AlksGit/OOTY-/BACKLOG.md

# Backlog

## TODO
- [ ] TASK-009 | Phase 6 — Fabrication
  > Gerbers + drill + CPL + BOM fab zippés dans out/fab/<projet>_<rev>.zip, checklist finale dans NOTES.md.
  > ⏸ Checkpoint final.
  > Blocked by: TASK-008 (DRC propre)

## IN PROGRESS
- [ ] TASK-008 | Phase 5 — Routage
  > Routage complet, zones remplies, DRC --schematic-parity : 0 erreur, 0 net non connecté. SVG par couche + rendu 3D.
  > ⏸ Checkpoint : routage relu.
  > Paires Kelvin et nœud µA des INA190 : F.Cu d'abord, B.Cu accepté à défaut (décision du 2026-10-20).
  > Blocked by: — (TASK-012 mergée)

## ON HOLD

## DONE
- [x] TASK-012 | Placement — intégration des nouveaux blocs + finition de la sérigraphie
  > Merged in: devape (2026-10-20) — revue + contre-revue « prêt pour le routage », DRC 0 / parité 0, découplage 59/59 ; face arrière non assemblée acceptée
- [x] TASK-011 | Schéma — mesure double calibre ×2 + retours de tension des rails fixes
  > Merged in: devape (2026-10-20) — ERC 0, netlist 196 nets et BOM 242 pièces sans écart
- [x] TASK-010 | Spec + composants — mesure double calibre (3V3_SW, 5V_SW) et retours de tension des rails fixes
  > Merged in: devape (2026-10-20) — validée par l'utilisateur après revue indépendante
- [x] TASK-007 | Phase 4 — Placement
  > Merged in: devape (2026-10-20) — refait après la revue des checkpoints, puis repris par TASK-012
- [x] TASK-006 | Phase 3 — Setup PCB
  > Merged in: devape (2026-10-20) — règles et classes corrigées après revue
- [x] TASK-005 | Phase 2 — Schéma
  > Merged in: devape (2026-10-20) — corrigé après revue (LQFP-80, boutons, ESD par header)
- [x] TASK-004 | Phase 1 — BOM préliminaire
  > Merged in: devape (2026-10-19) — BOM validée au checkpoint (recommandations retenues), choix du fabricant reporté en Phase 6
- [x] TASK-003 | Phase 0 — Spécification
  > Merged in: devape (2026-10-19) — spec validée au checkpoint
- [x] TASK-002 | Setup environnement + arborescence
  > Merged in: devape (2026-10-19)
- [x] TASK-001 | Remplir §1 de CLAUDE.md + créer la branche devape
  > Merged in: devape (2026-10-19)

## CANCELLED
