AlksGit/OOTY-/out/renders/pcb_phase3_iso.png

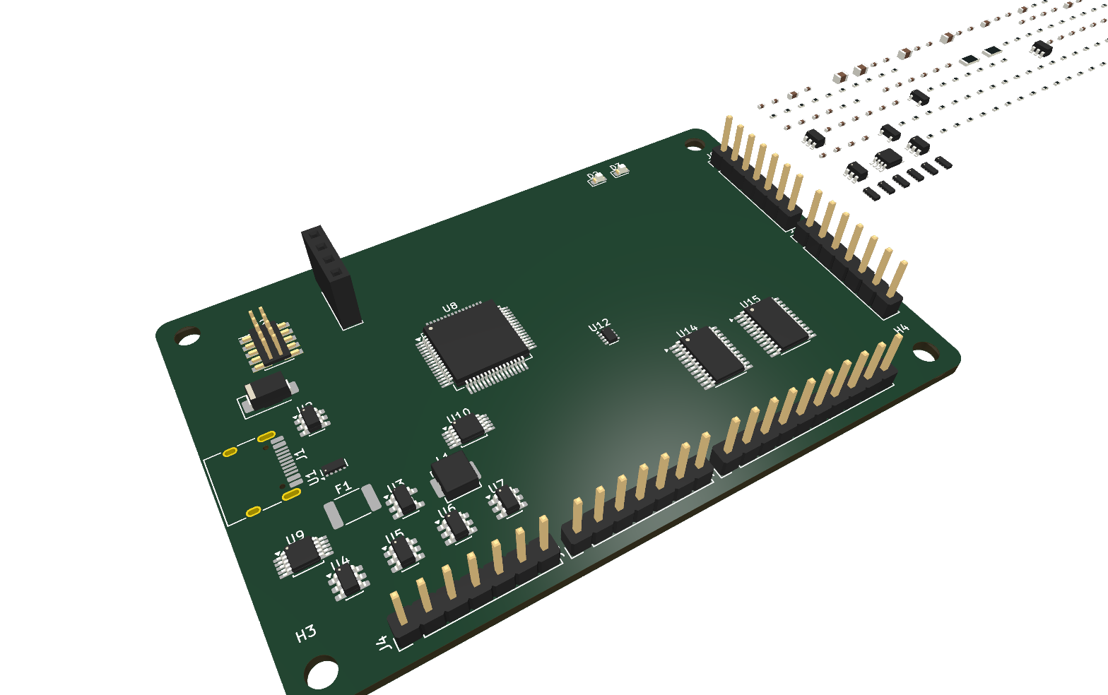
out/renders/pcb_phase3_iso.png
