AlksGit/OOTY-/out/renders/pcb_phase3_top.png

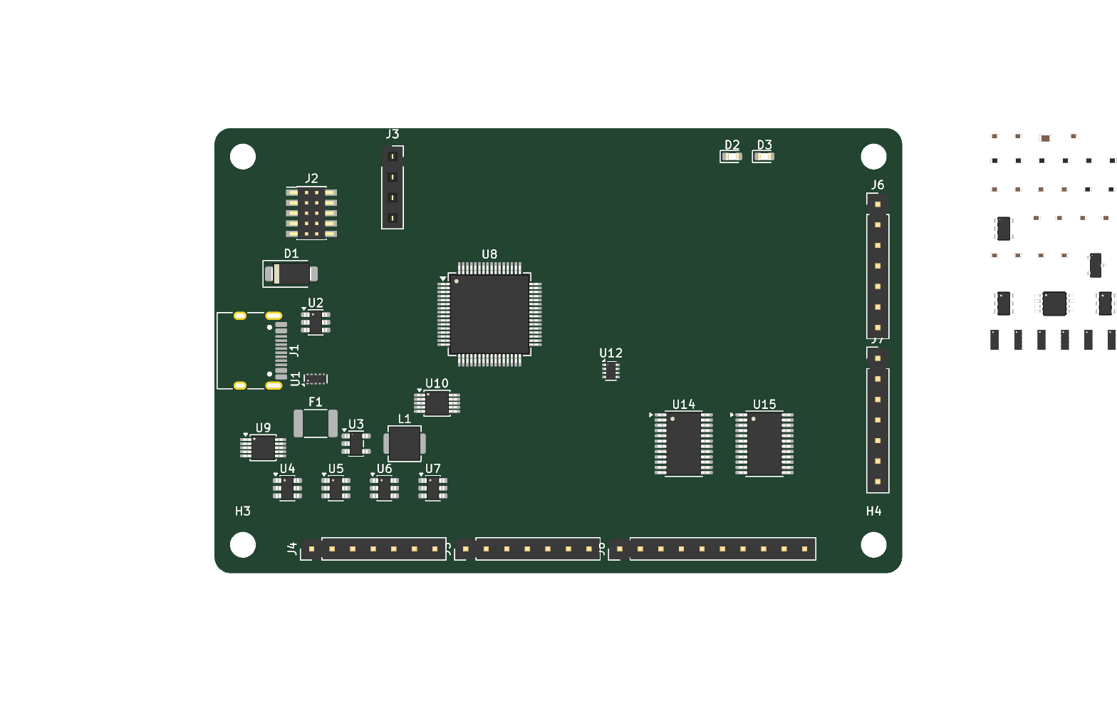
out/renders/pcb_phase3_top.png
