AlksGit/OOTY-/out/renders/pcb_placement_bottom.png

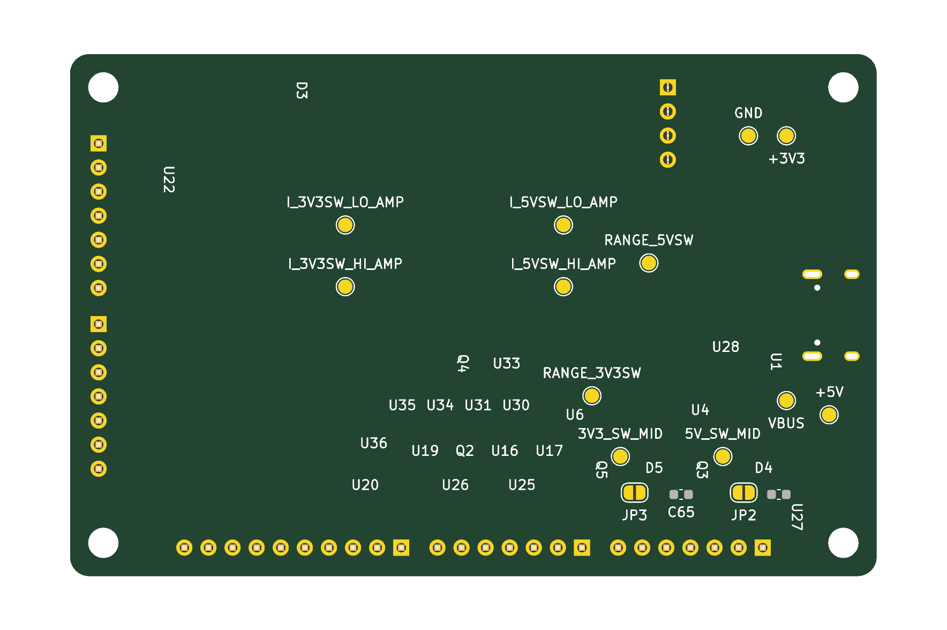
out/renders/pcb_placement_bottom.png
