AlksGit/OOTY-/out/renders/pcb_placement_iso.png

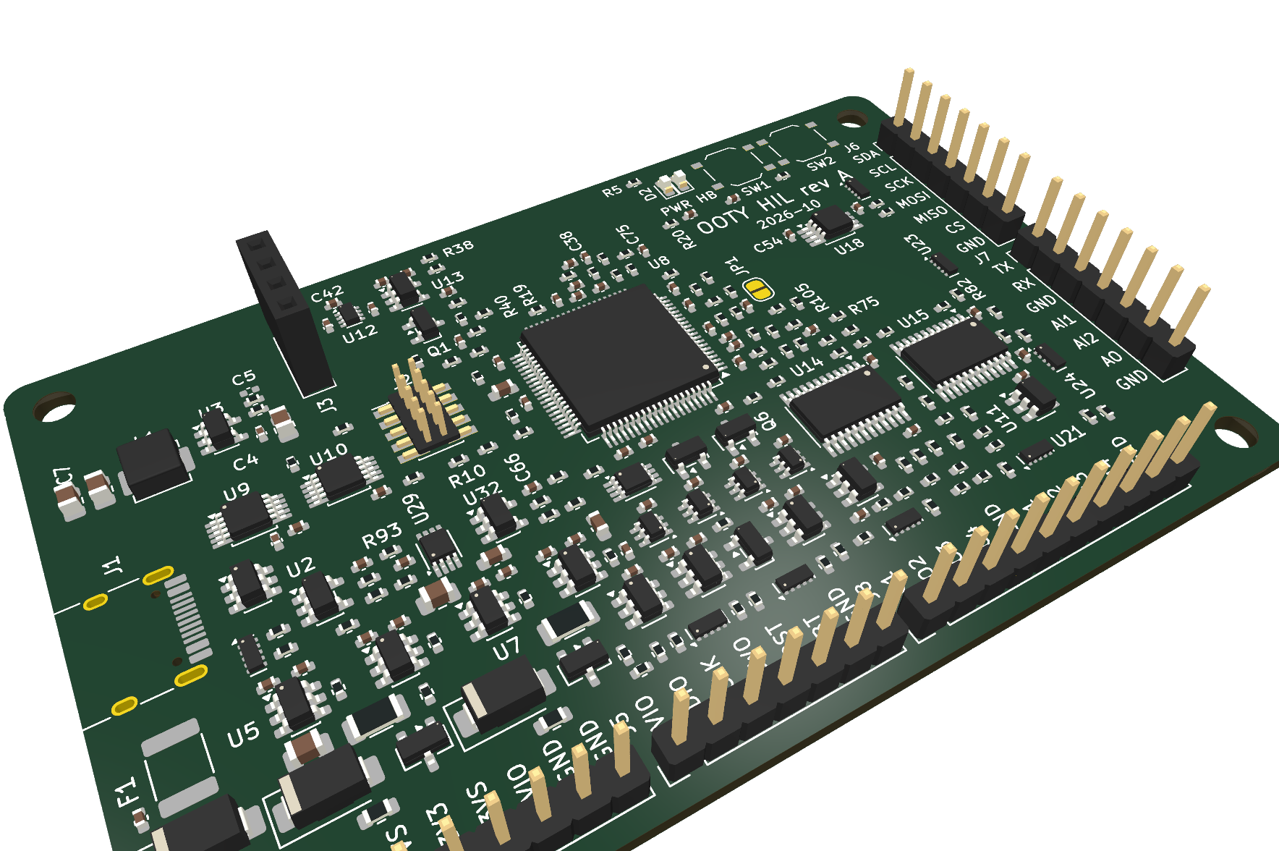
out/renders/pcb_placement_iso.png
