AlksGit/OOTY-/out/renders/pcb_placement_ratsnest.png

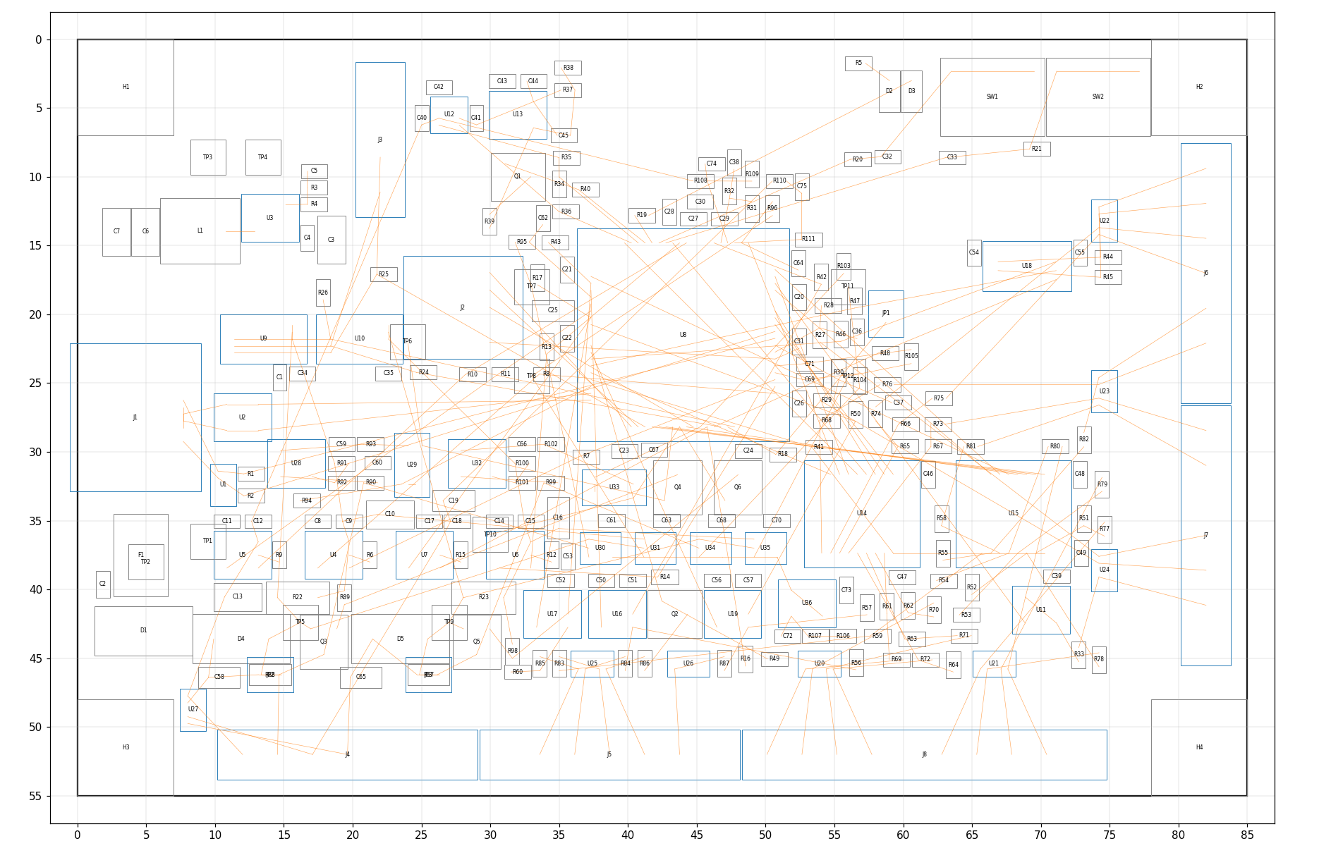
out/renders/pcb_placement_ratsnest.png
