AlksGit/OOTY-/out/renders/pcb_placement_top.png

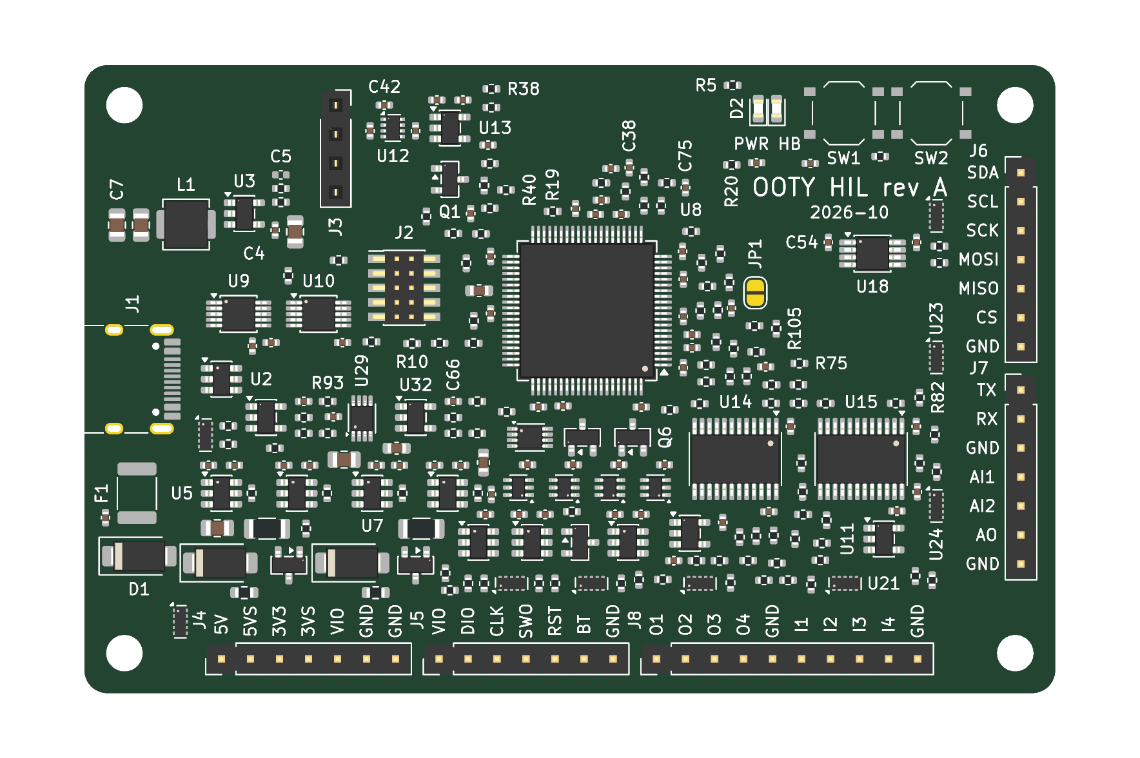
out/renders/pcb_placement_top.png
