AlksGit/OOTY-/out/renders/schematic_p1.png

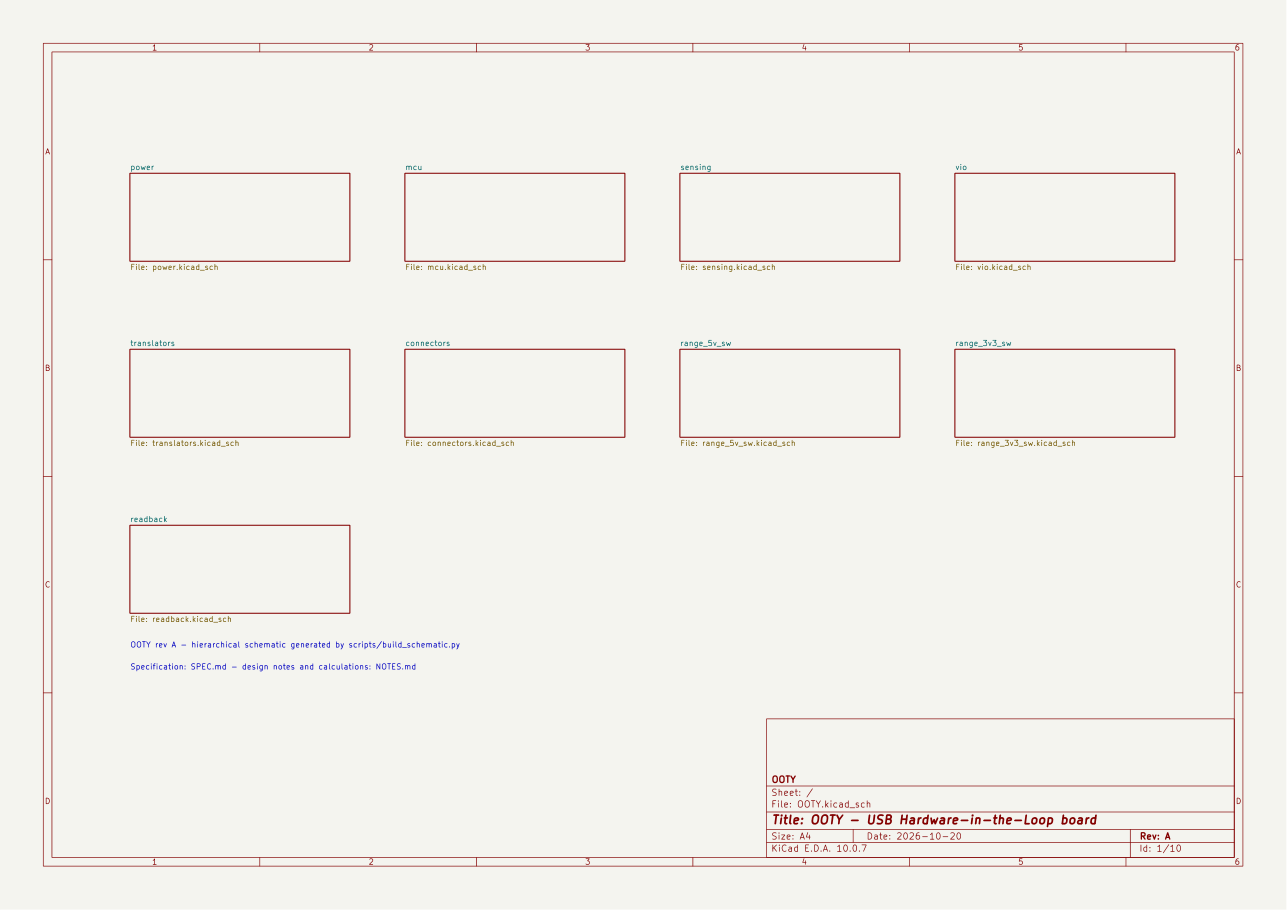
out/renders/schematic_p1.png
