AlksGit/OOTY-/out/renders/schematic_p2.png

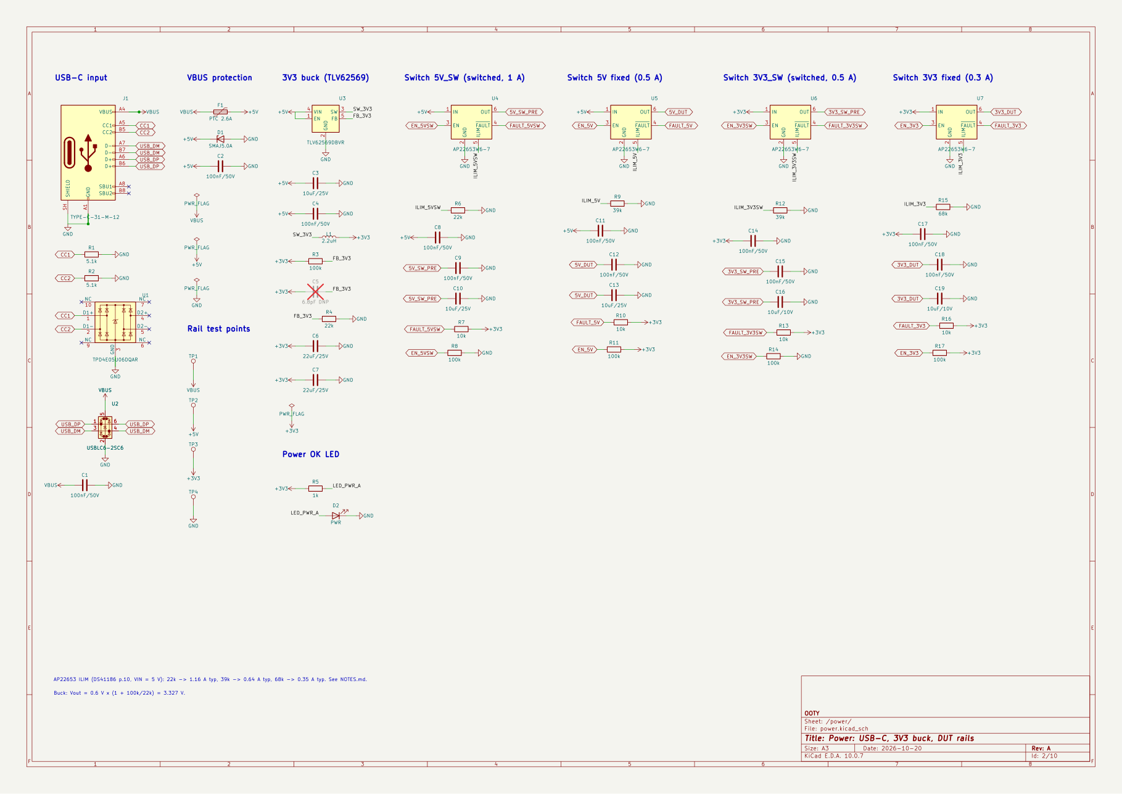
out/renders/schematic_p2.png
