AlksGit/OOTY-/out/renders/schematic_p3.png

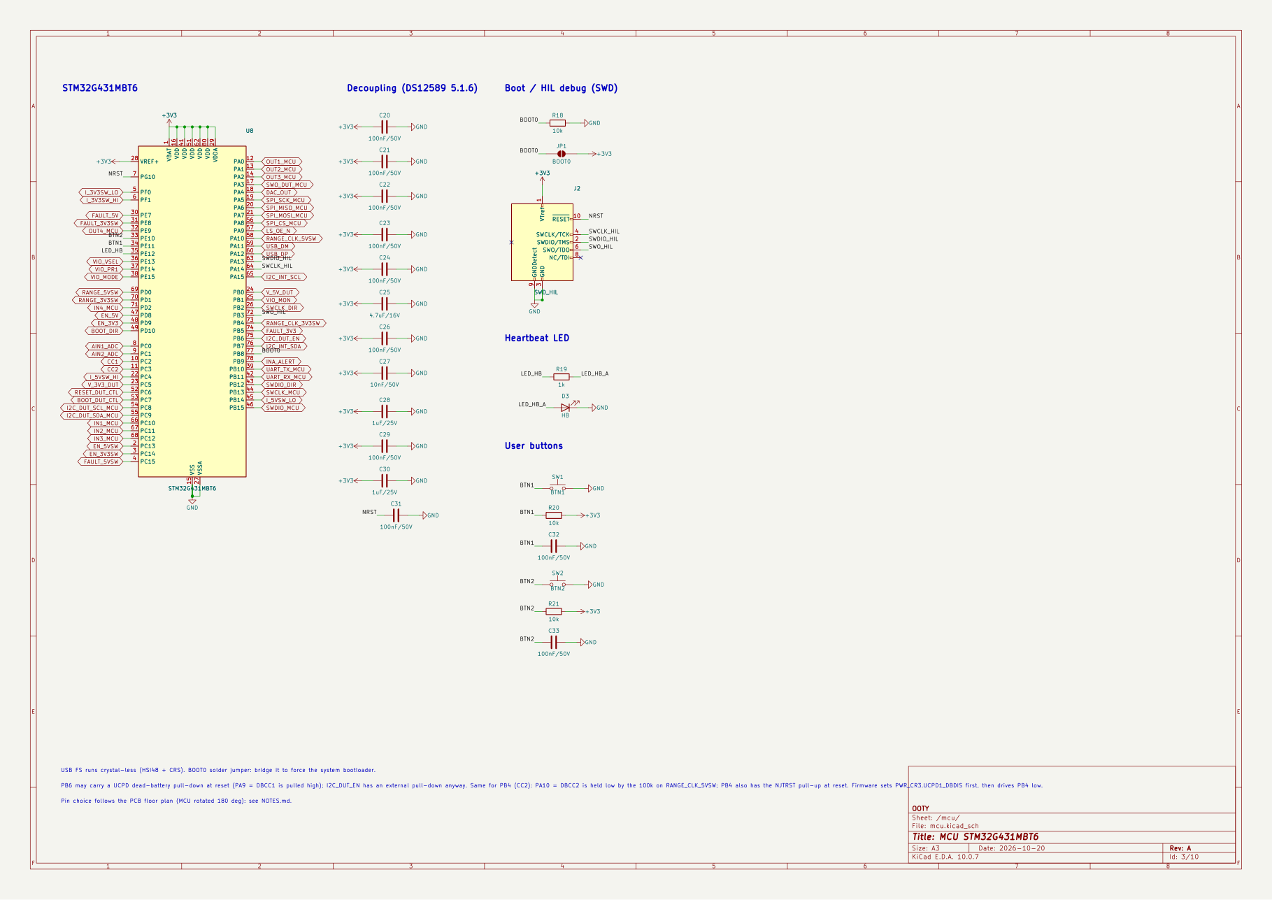
out/renders/schematic_p3.png
