AlksGit/OOTY-/out/renders/schematic_p4.png

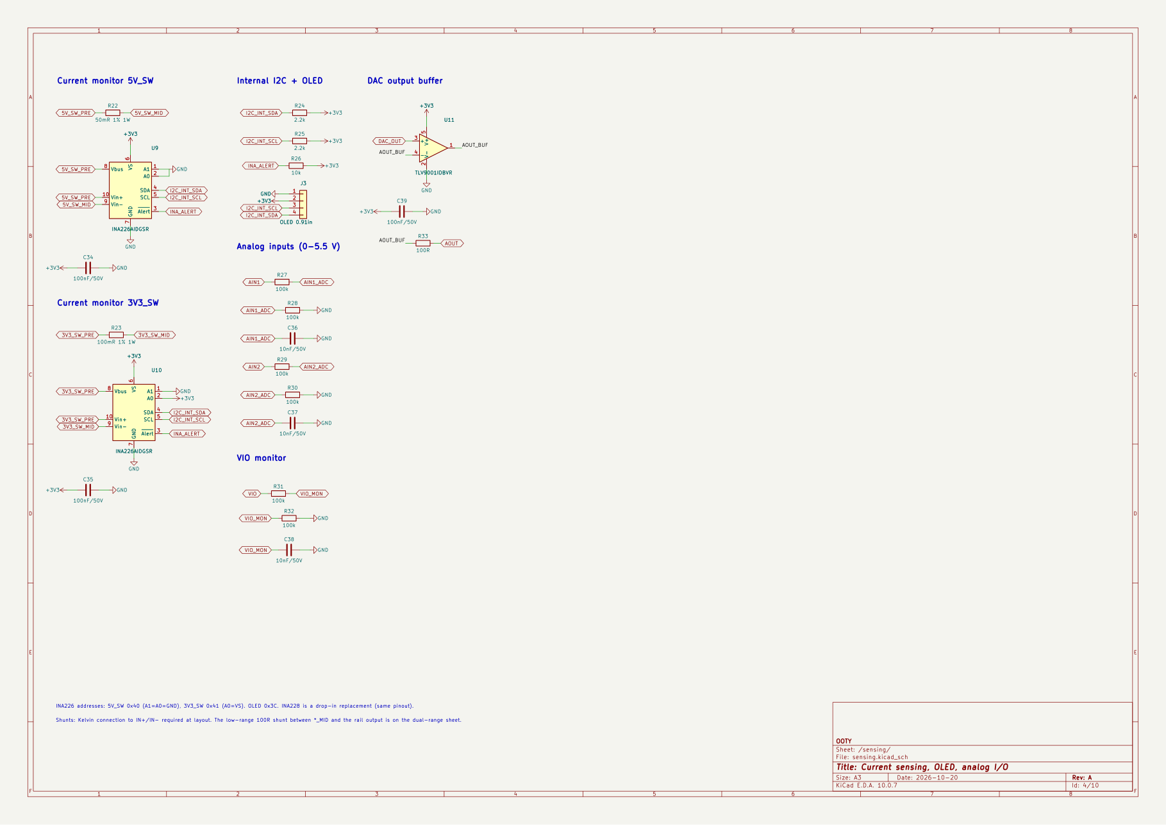
out/renders/schematic_p4.png
