AlksGit/OOTY-/out/renders/schematic_p5.png

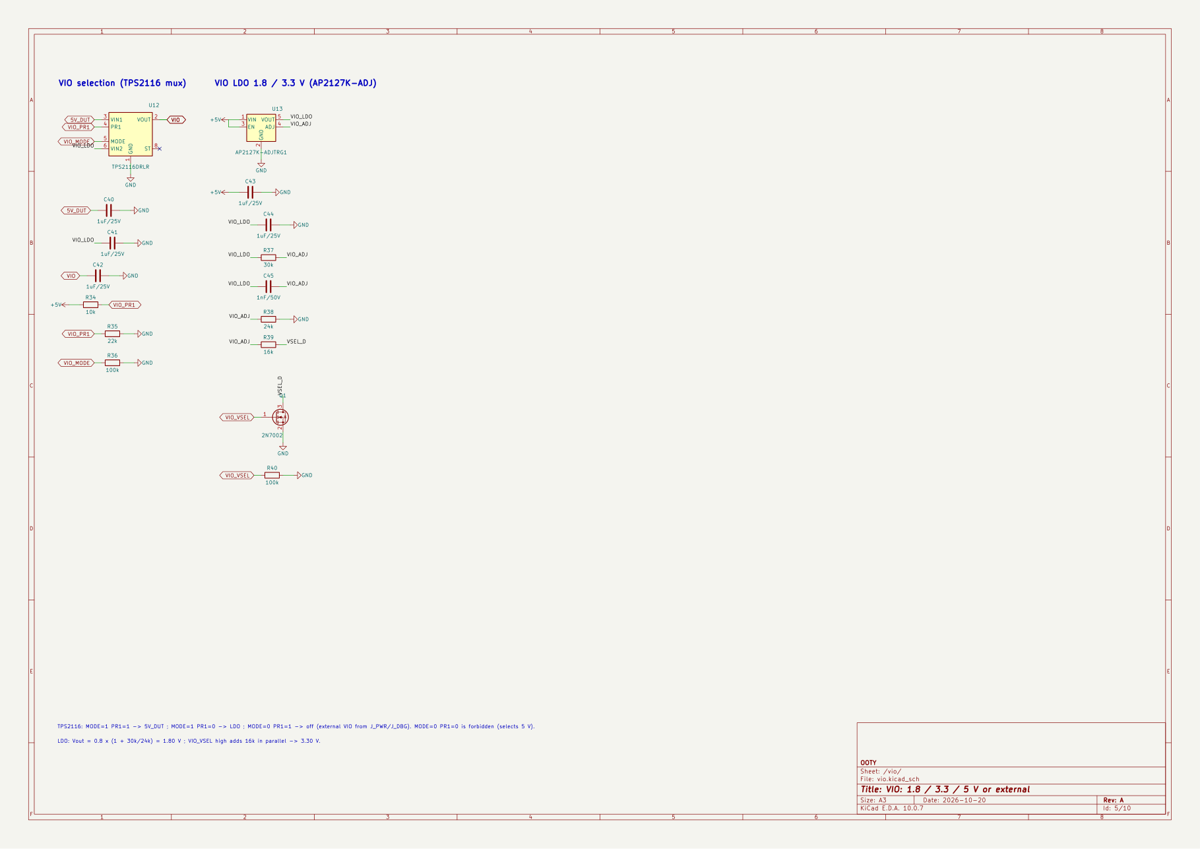
out/renders/schematic_p5.png
