AlksGit/OOTY-/out/renders/schematic_p6.png

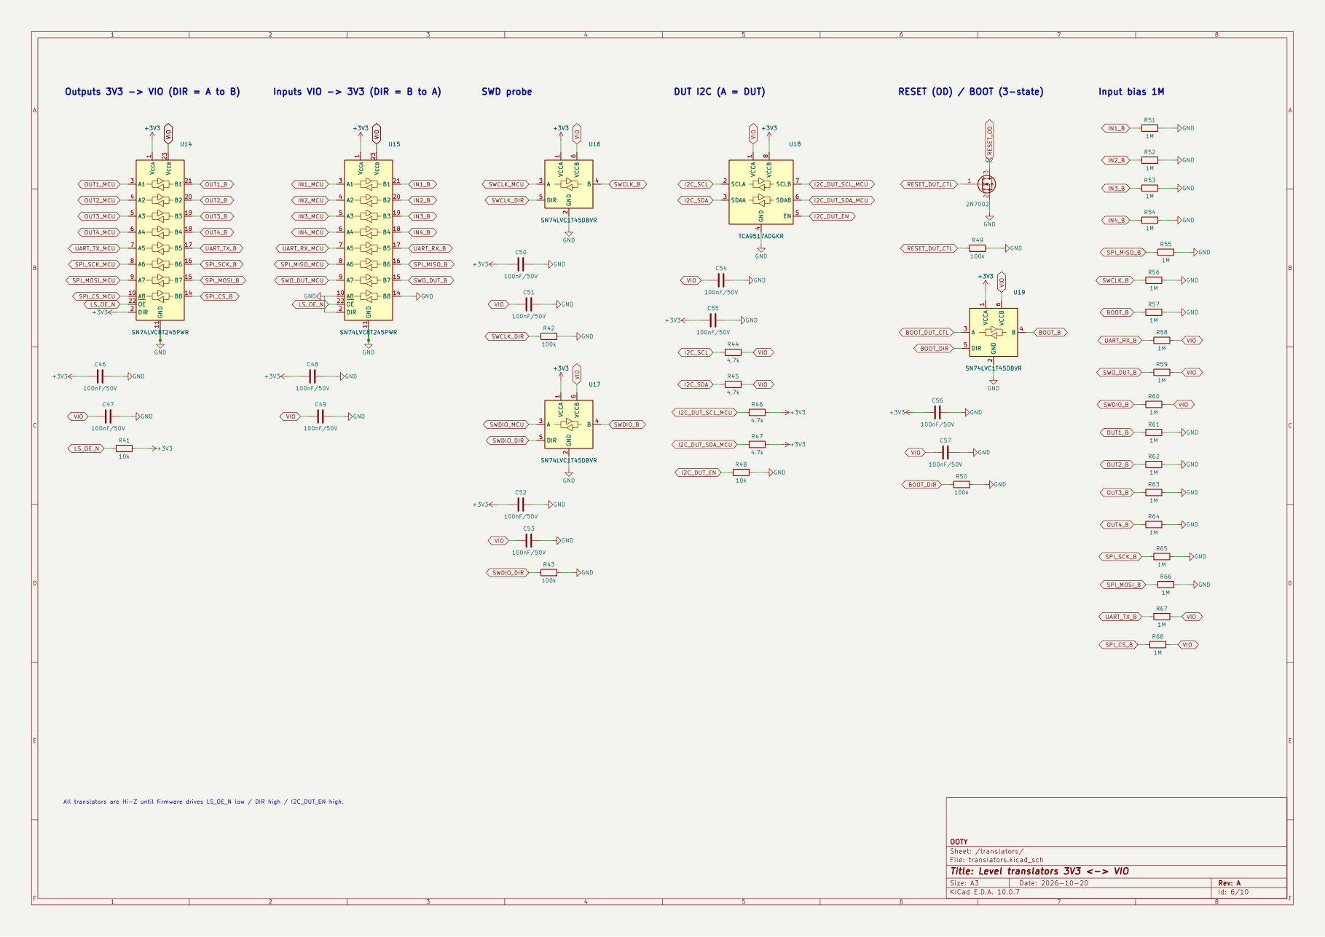
out/renders/schematic_p6.png
