AlksGit/OOTY-/out/renders/schematic_p7.png

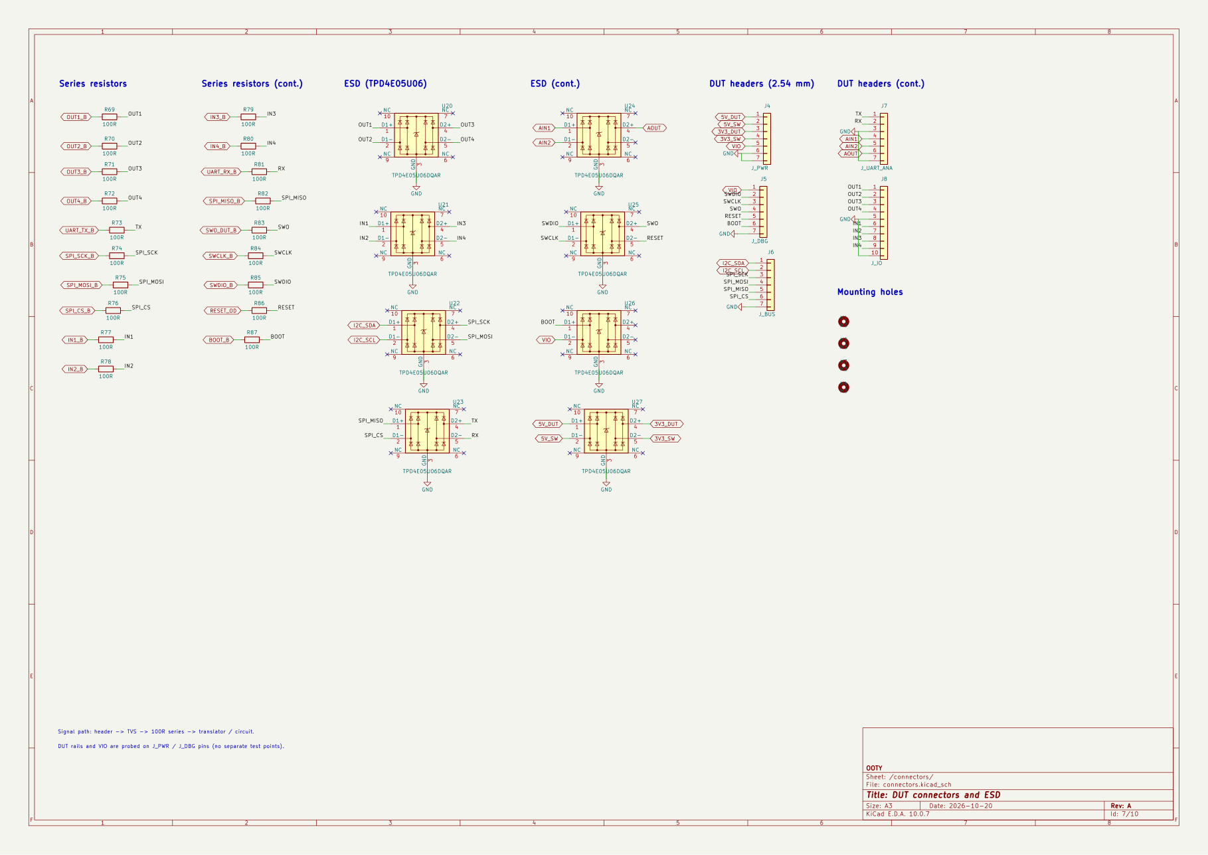
out/renders/schematic_p7.png
