AlksGit/OOTY-/out/renders/schematic_p8.png

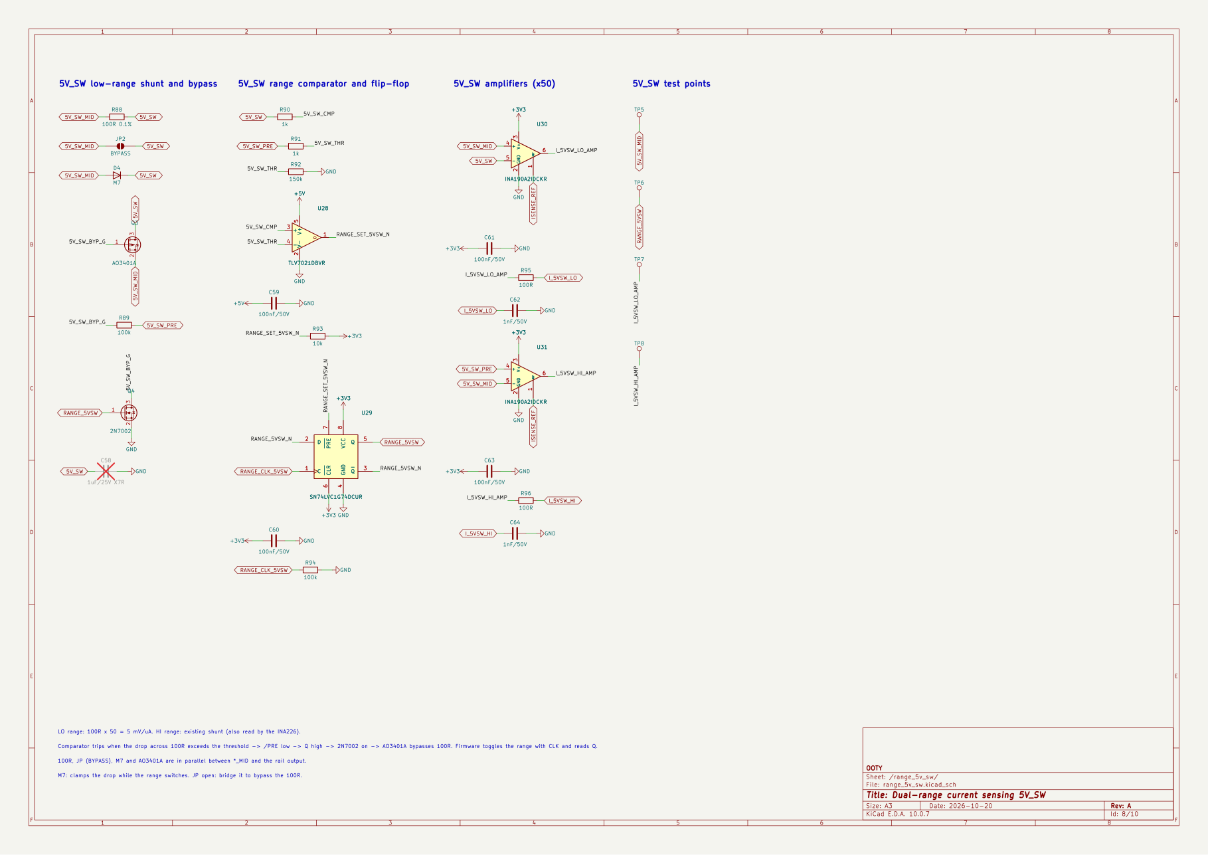
out/renders/schematic_p8.png
