AlksGit/OOTY-/out/renders/schematic_p9.png

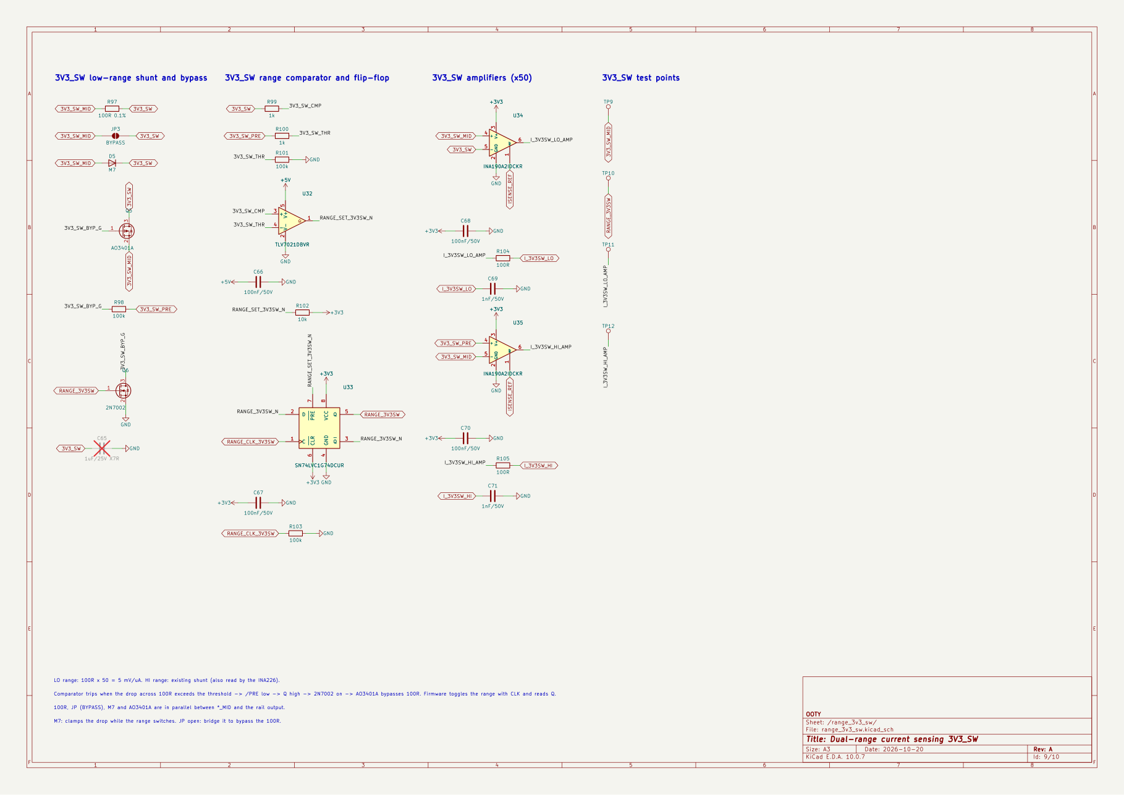
out/renders/schematic_p9.png
