AlksGit/OOTY-/out/renders/schematic_p10.png

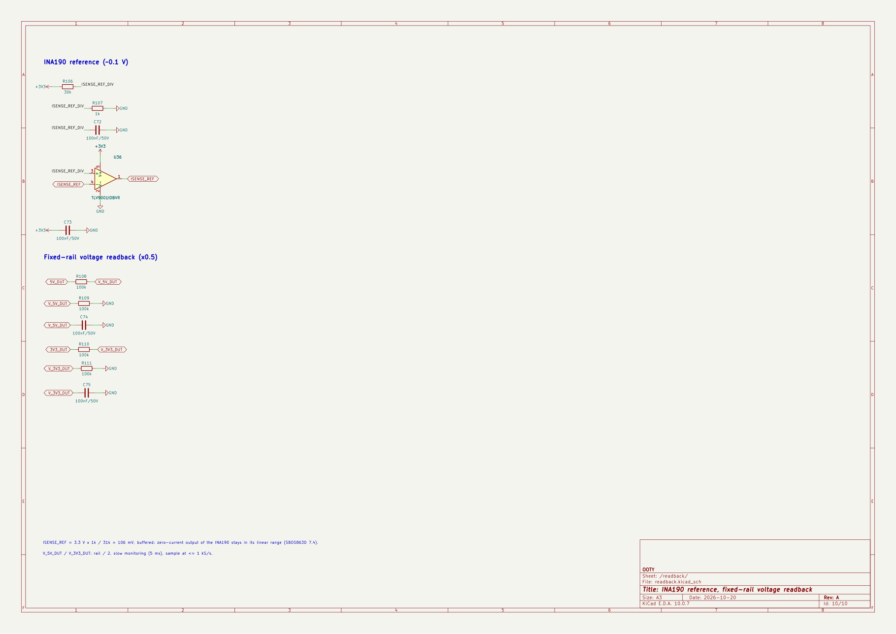
out/renders/schematic_p10.png
