AlksGit/OOTY-/out/OOTY_schematic.pdf

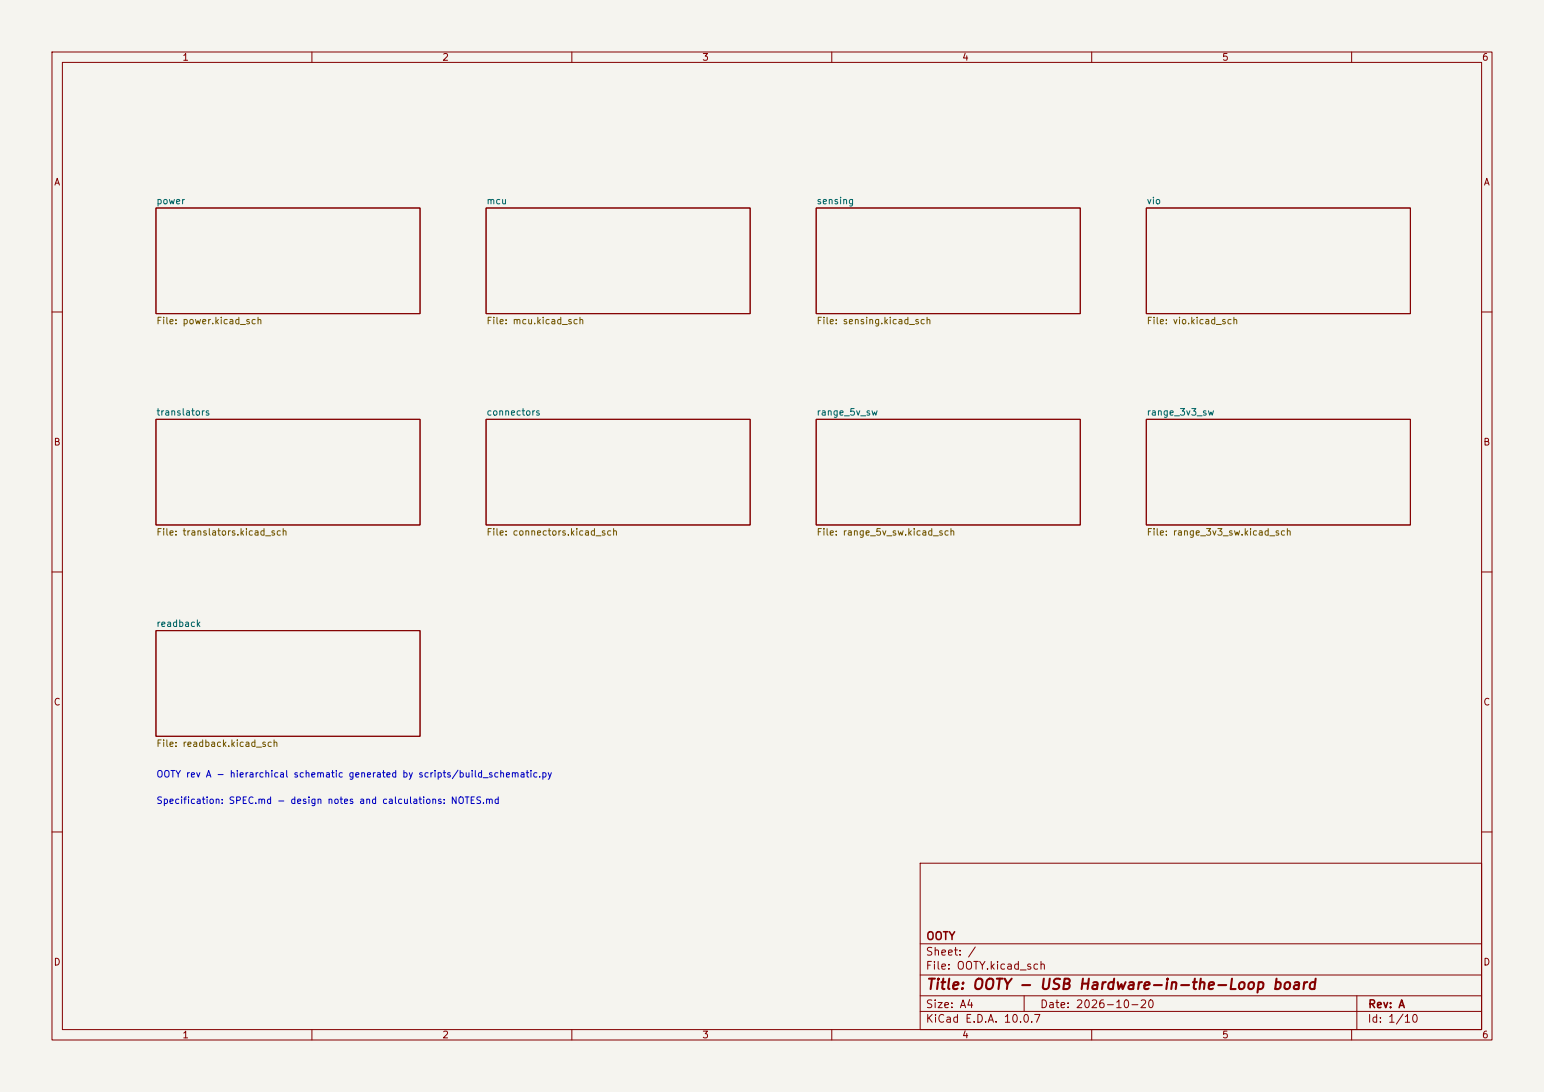
[picture p17: page 1]

File: range_5v_sw.kicad_sch OOTY rev A - hierarchical schematic generated by scripts/build_schematic.py

Specification: SPEC.md - design notes and calculations: NOTES.md

OOTY
Sheet: /
File: OOTY.kicad_sch
Title: OOTY - USB Hardware-in-the-Loop board

Size: A4 | Rev: A
KiCad E.D.A. 10.0.7 | Id: 1/10

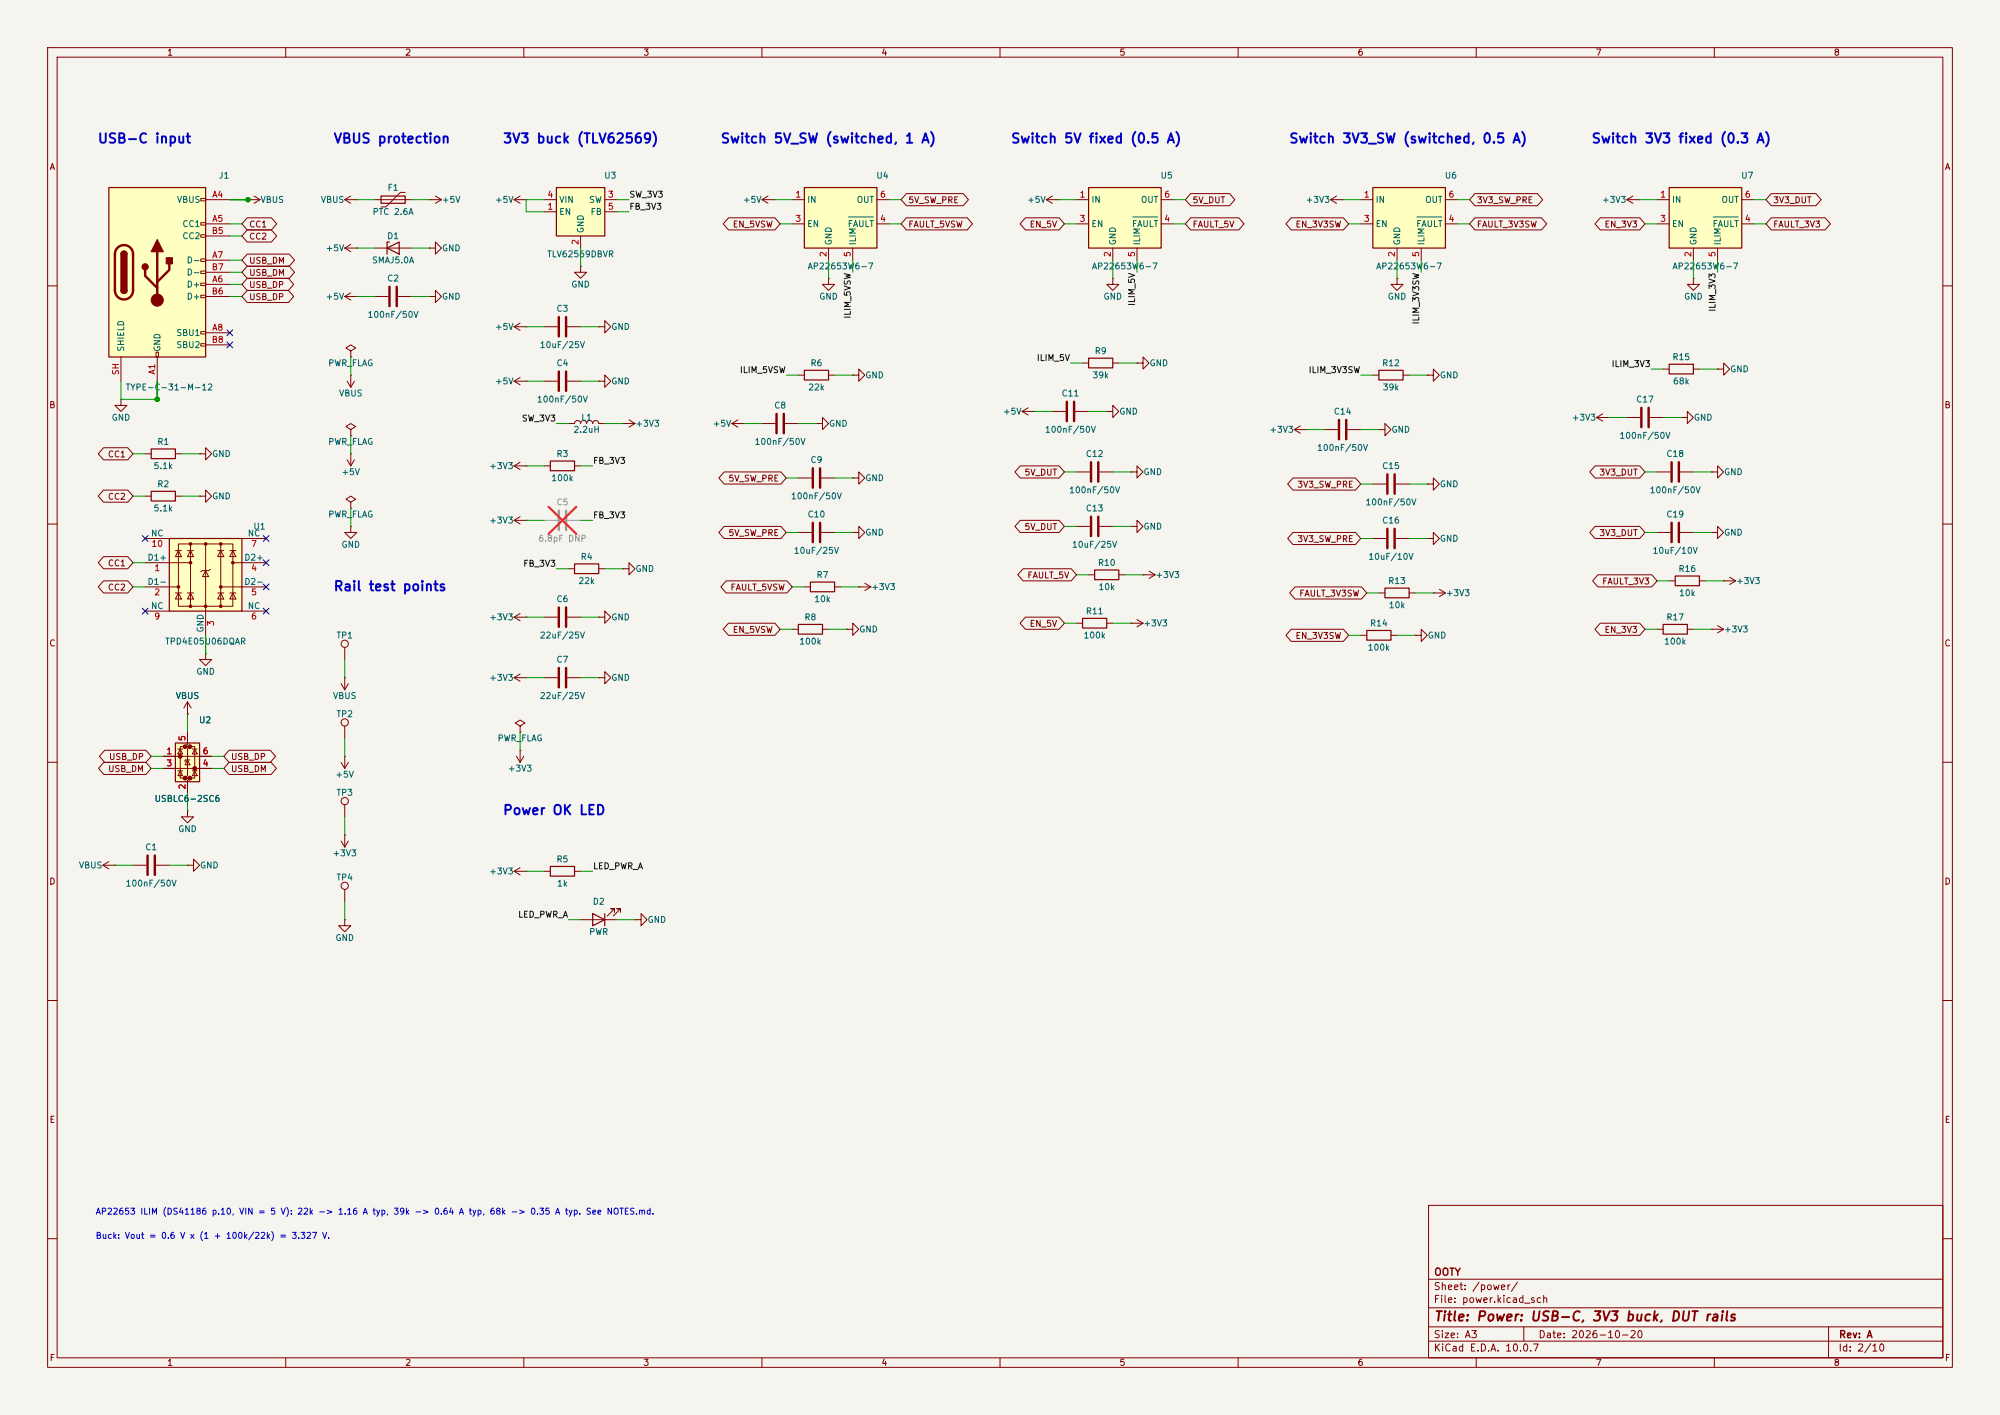
[picture p18: page 2]

Buck: Vout = 0.6 V x (1 + 100k/22k) = 3.327 V. AP22653 ILIM (DS41186 p.10, VIN = 5 V): 22k -> 1.16 A typ, 39k -> 0.64 A typ, 68k -> 0.35 A typ. See NOTES.md.

Sheet: /power/
File: power.kicad_sch
Title: Power: USB-C, 3V3 buck, DUT rails

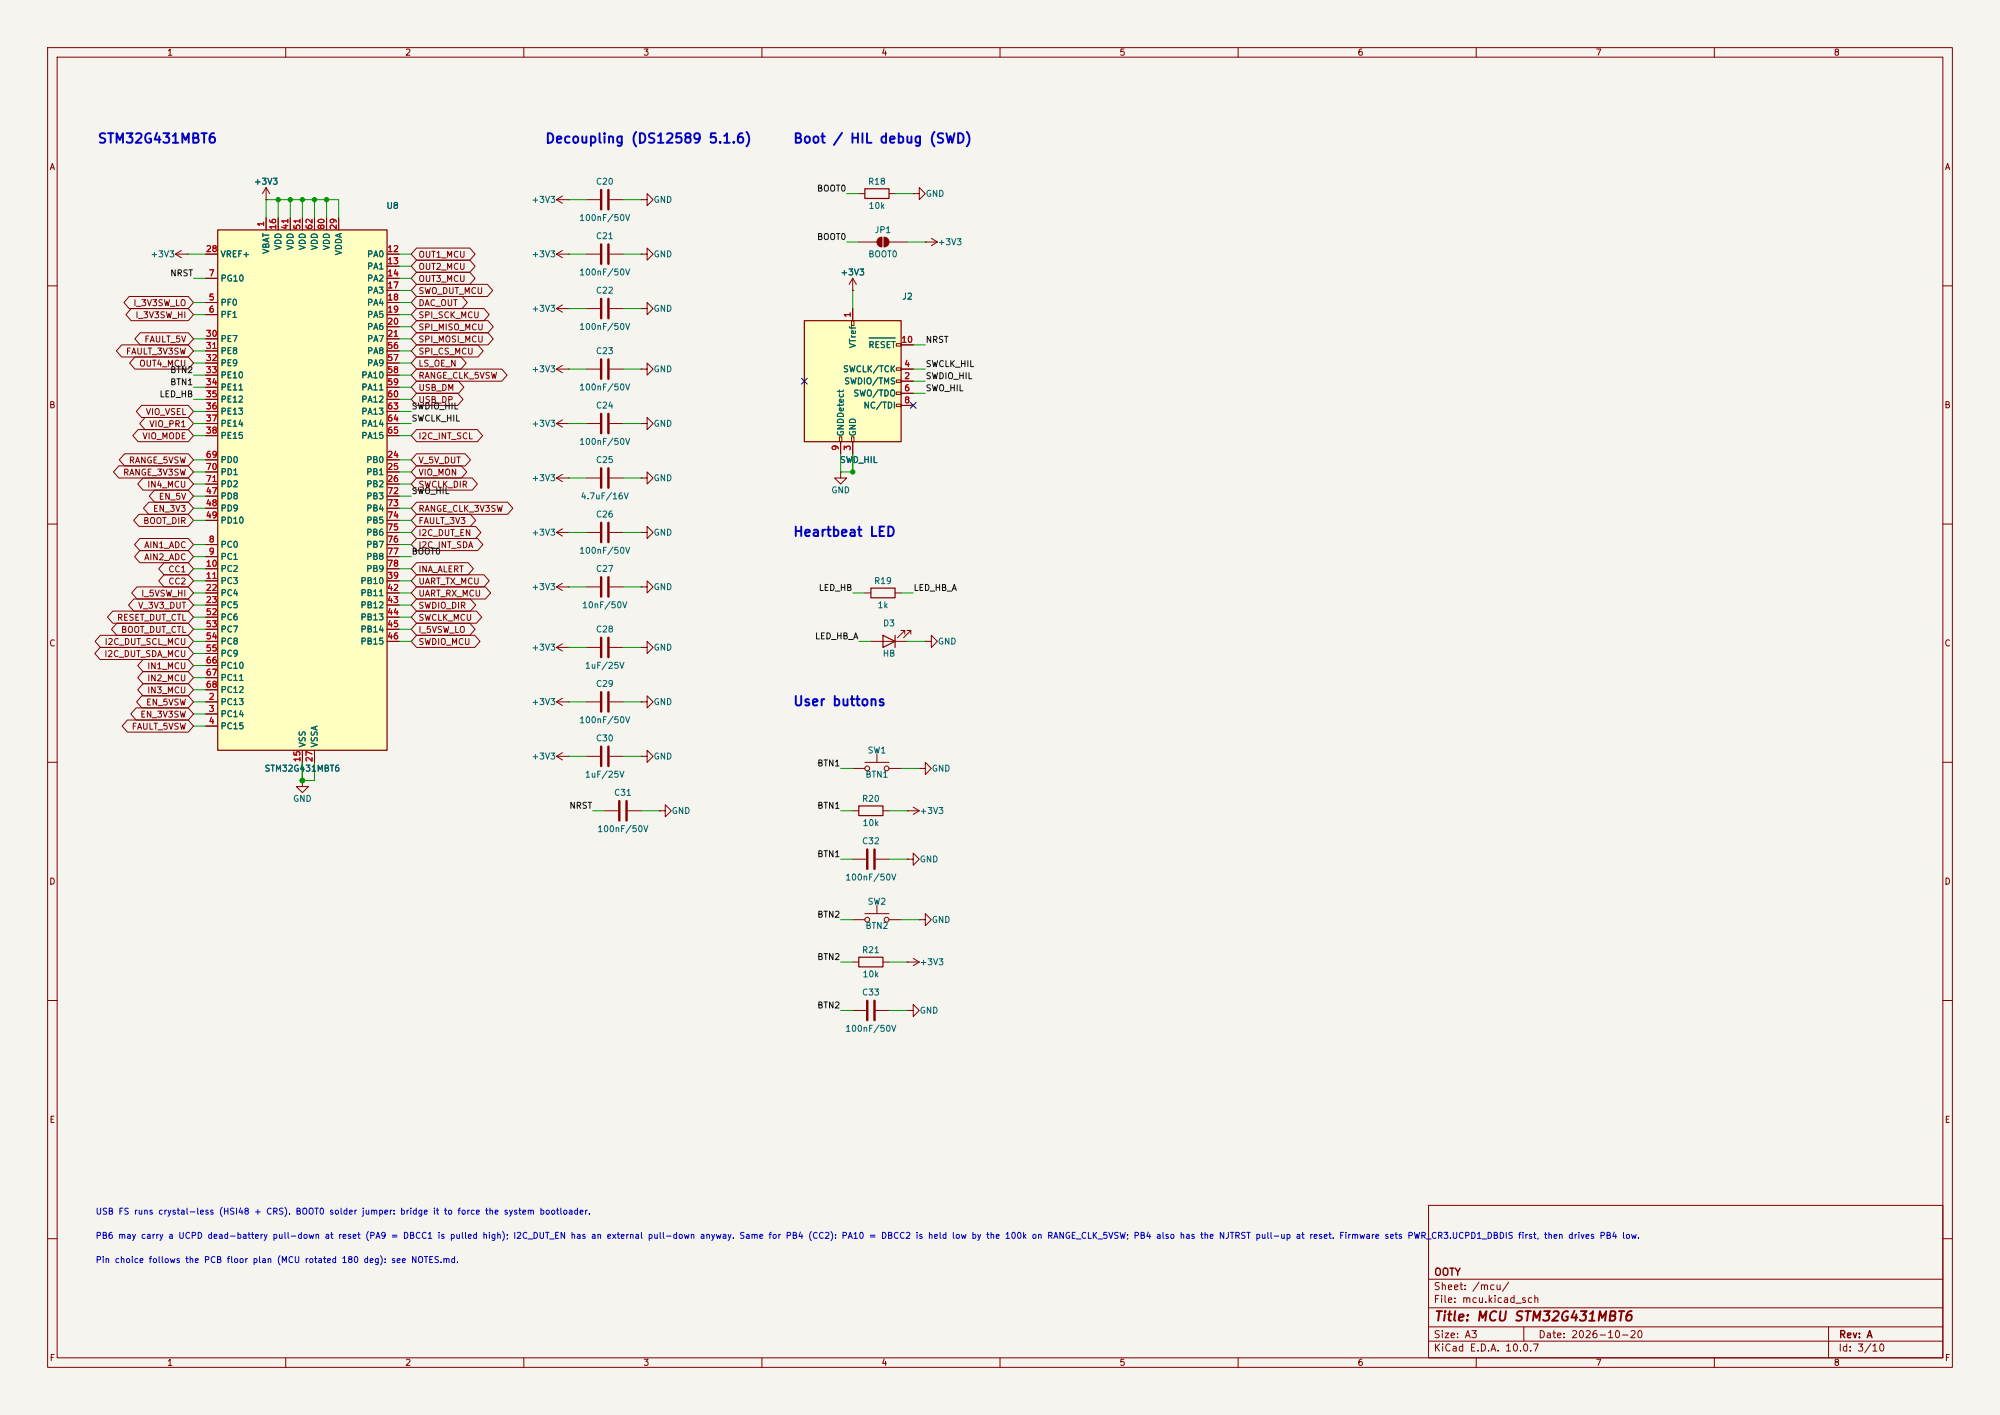
[picture p19: page 3]

Pin choice follows the PCB floor plan (MCU rotated 180 deg): see NOTES.md. PB6 may carry a UCPD dead-battery pull-down at reset (PA9 = DBCC1 is pulled high); I2C_DUT_EN has an external pull-down anyway. Same for PB4 (CC2): PA10 = DBCC2 is held low by the 100k on RANGE_CLK_5VSW; PB4 also has the NJTRST pull-up at reset. Firmware sets PWR_CR3.UCPD1_DBDIS first, then drives PB4 low. USB FS runs crystal-less (HSI48 + CRS). BOOT0 solder jumper: bridge it to force the system bootloader.

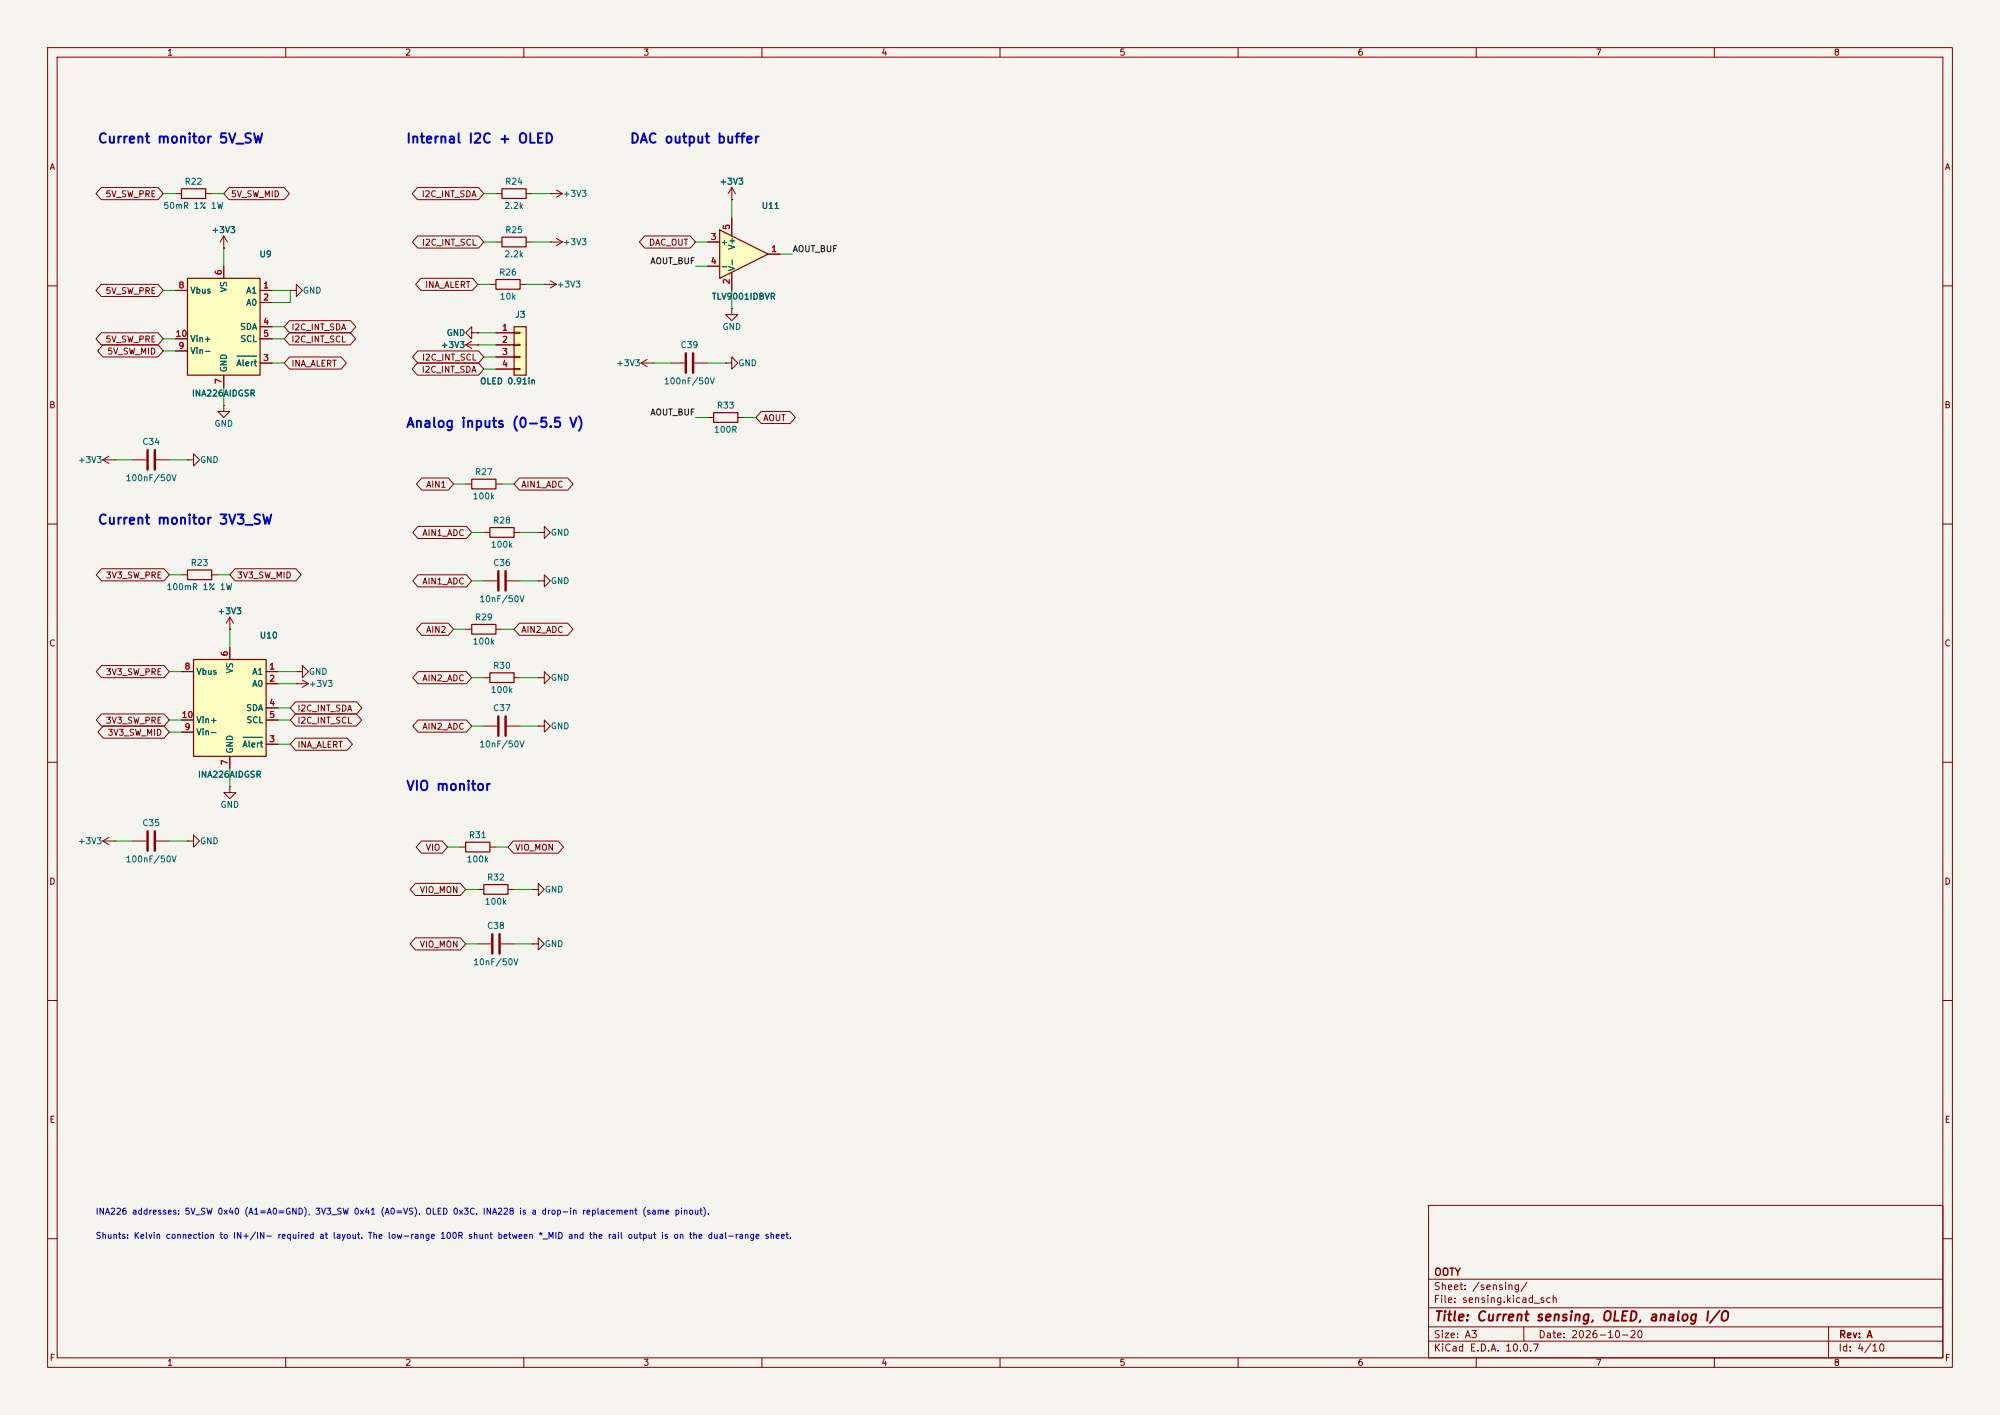
[picture p20: page 4]

INA226 addresses: 5V_SW 0x40 (A1=A0=GND), 3V3_SW 0x41 (A0=VS). OLED 0x3C. INA228 is a drop-in replacement (same pinout).

Shunts: Kelvin connection to IN+/IN- required at layout. The low-range 100R shunt between *_MID and the rail output is on the dual-range sheet.

OOTY
Sheet: /sensing/
File: sensing.kicad_sch
Title: Current sensing, OLED, analog I/O

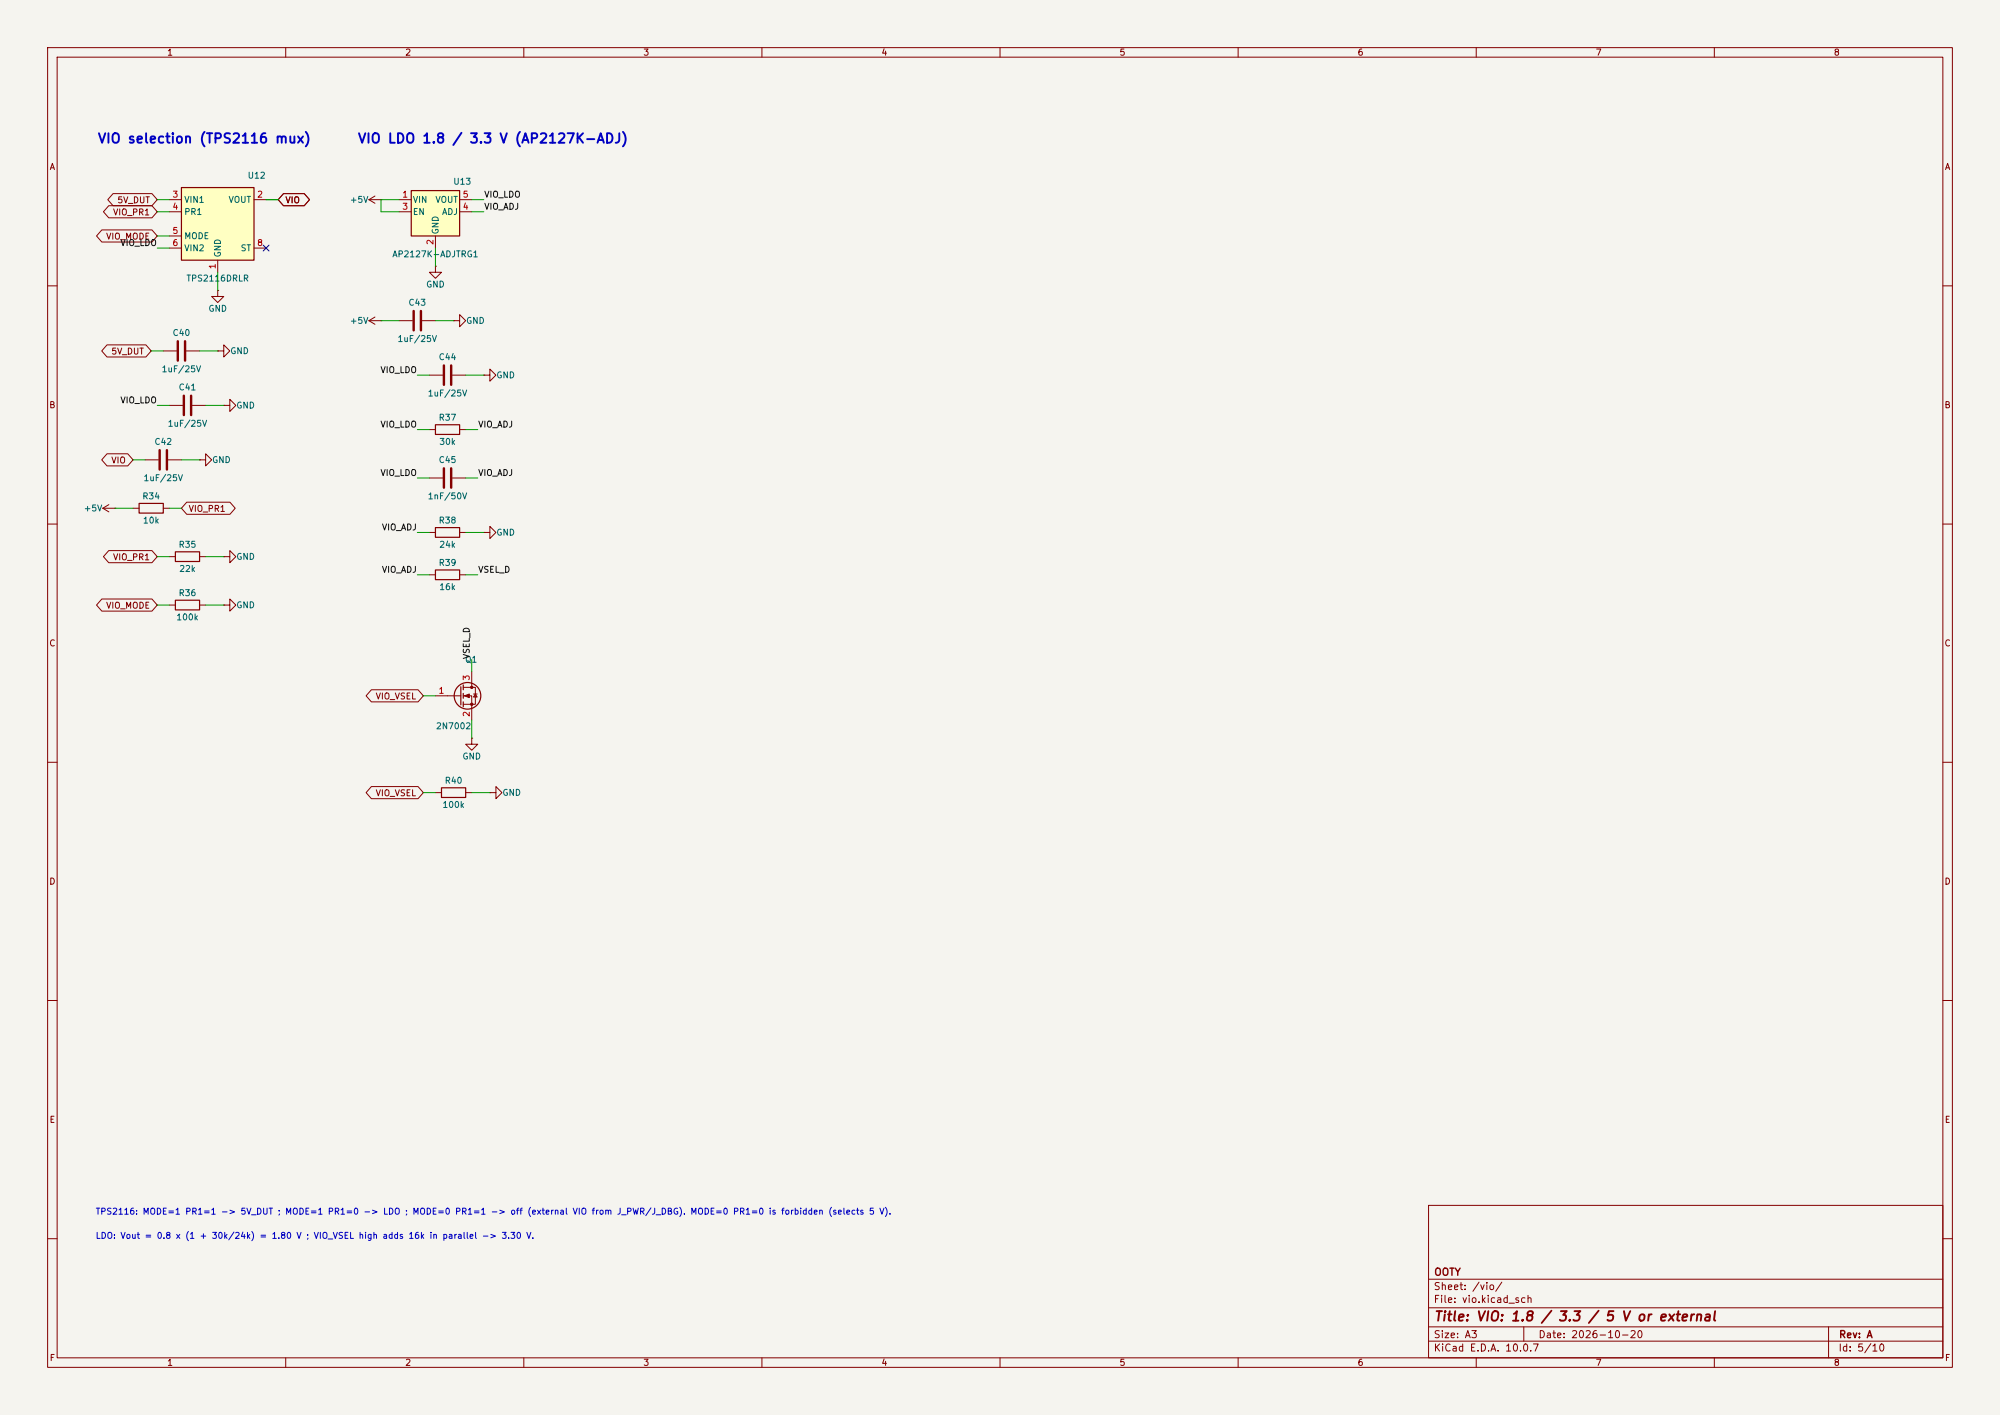
[picture p21: page 5]

TPS2116: MODE=1 PR1=1 -> 5V_DUT ; MODE=1 PR1=0 -> LDO ; MODE=0 PR1=1 -> off (external VIO from J_PWR/J_DBG). MODE=0 PR1=0 is forbidden (selects 5 V).

LDO: Vout = 0.8 x (1 + 30k/24k) = 1.80 V ; VIO_VSEL high adds 16k in parallel -> 3.30 V.

Sheet: /vio/
File: vio.kicad_sch
Title: VIO: 1.8 / 3.3 / 5 V or external

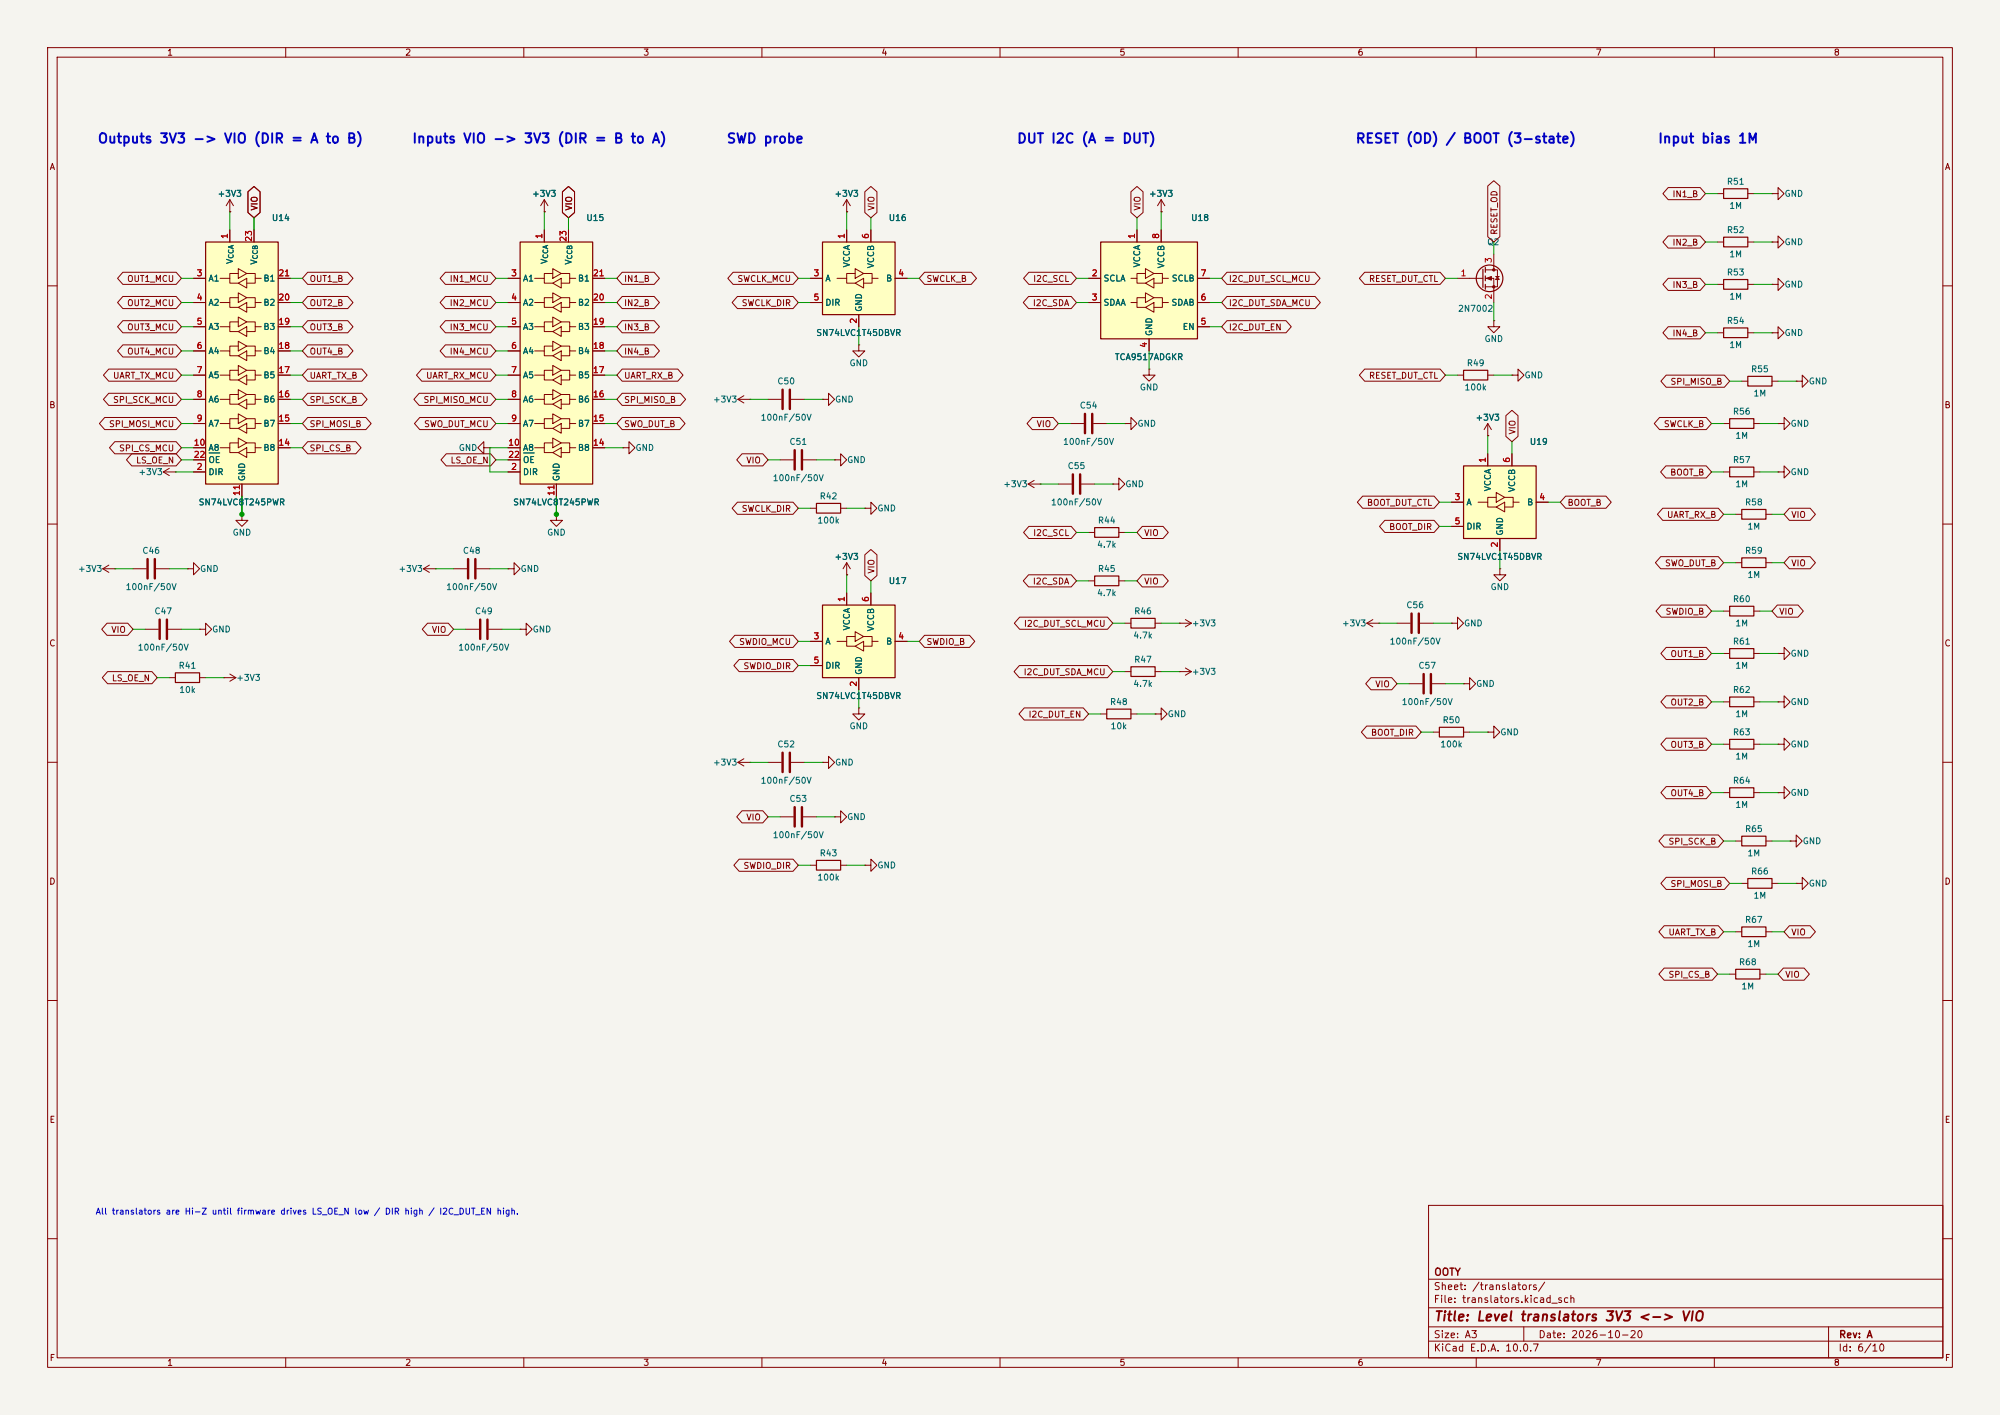
[picture p22: page 6]

All translators are Hi-Z until firmware drives LS_OE_N low / DIR high / I2C_DUT_EN high.

OOTY
Sheet: /translators/
File: translators.kicad_sch
Title: Level translators 3V3 <-> VIO

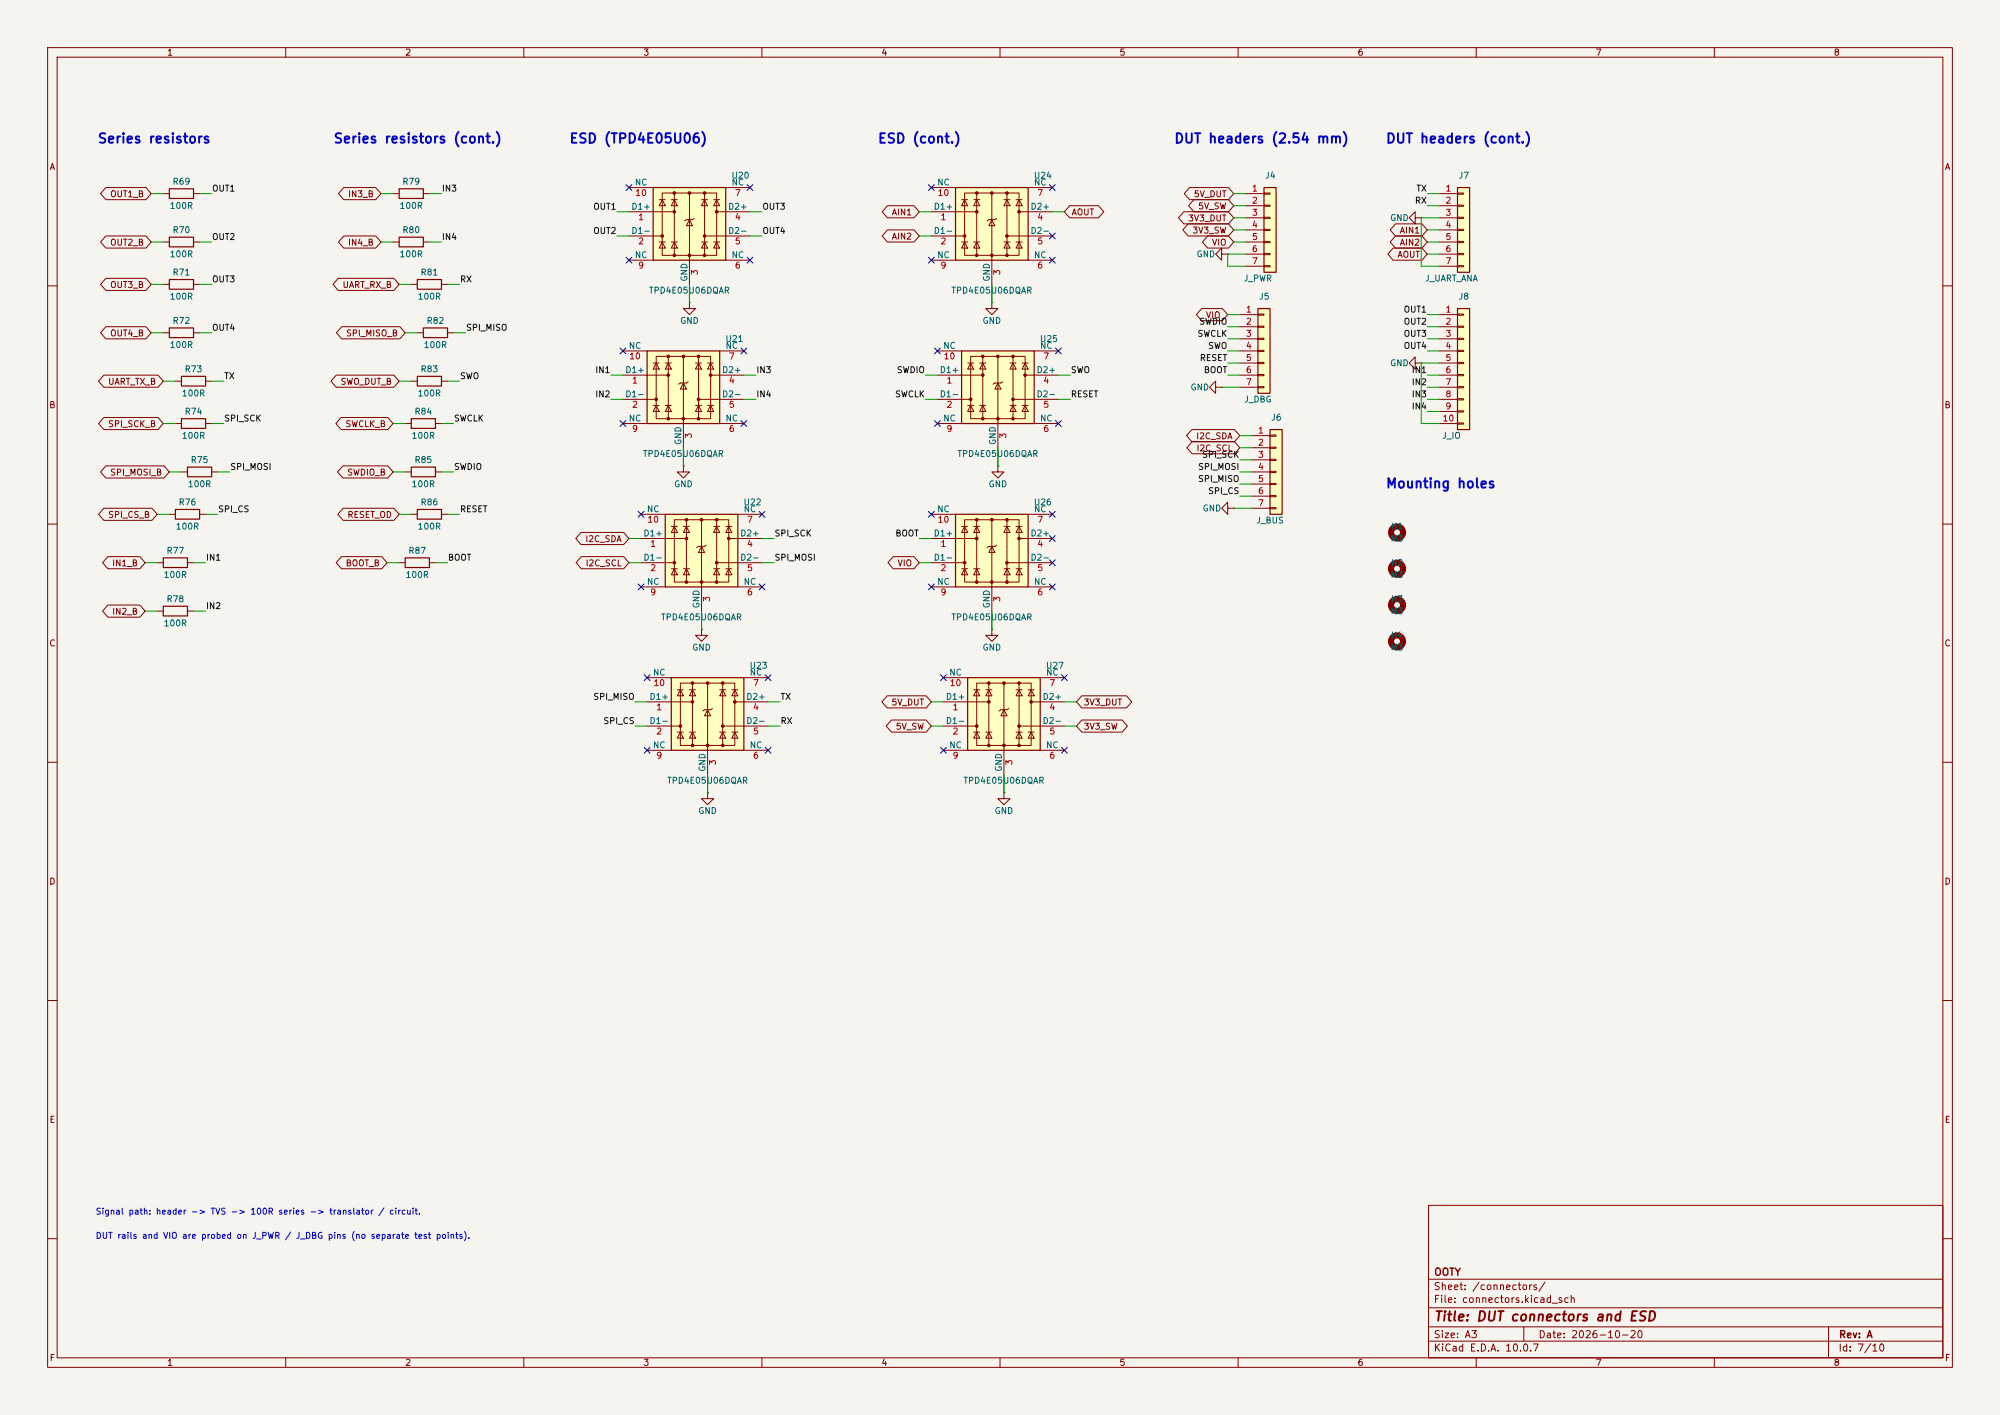
[picture p23: page 7]

DUT rails and VIO are probed on J_PWR / J_DBG pins (no separate test points).

OOTY
Sheet: /connectors/
File: connectors.kicad_sch
Title: DUT connectors and ESD

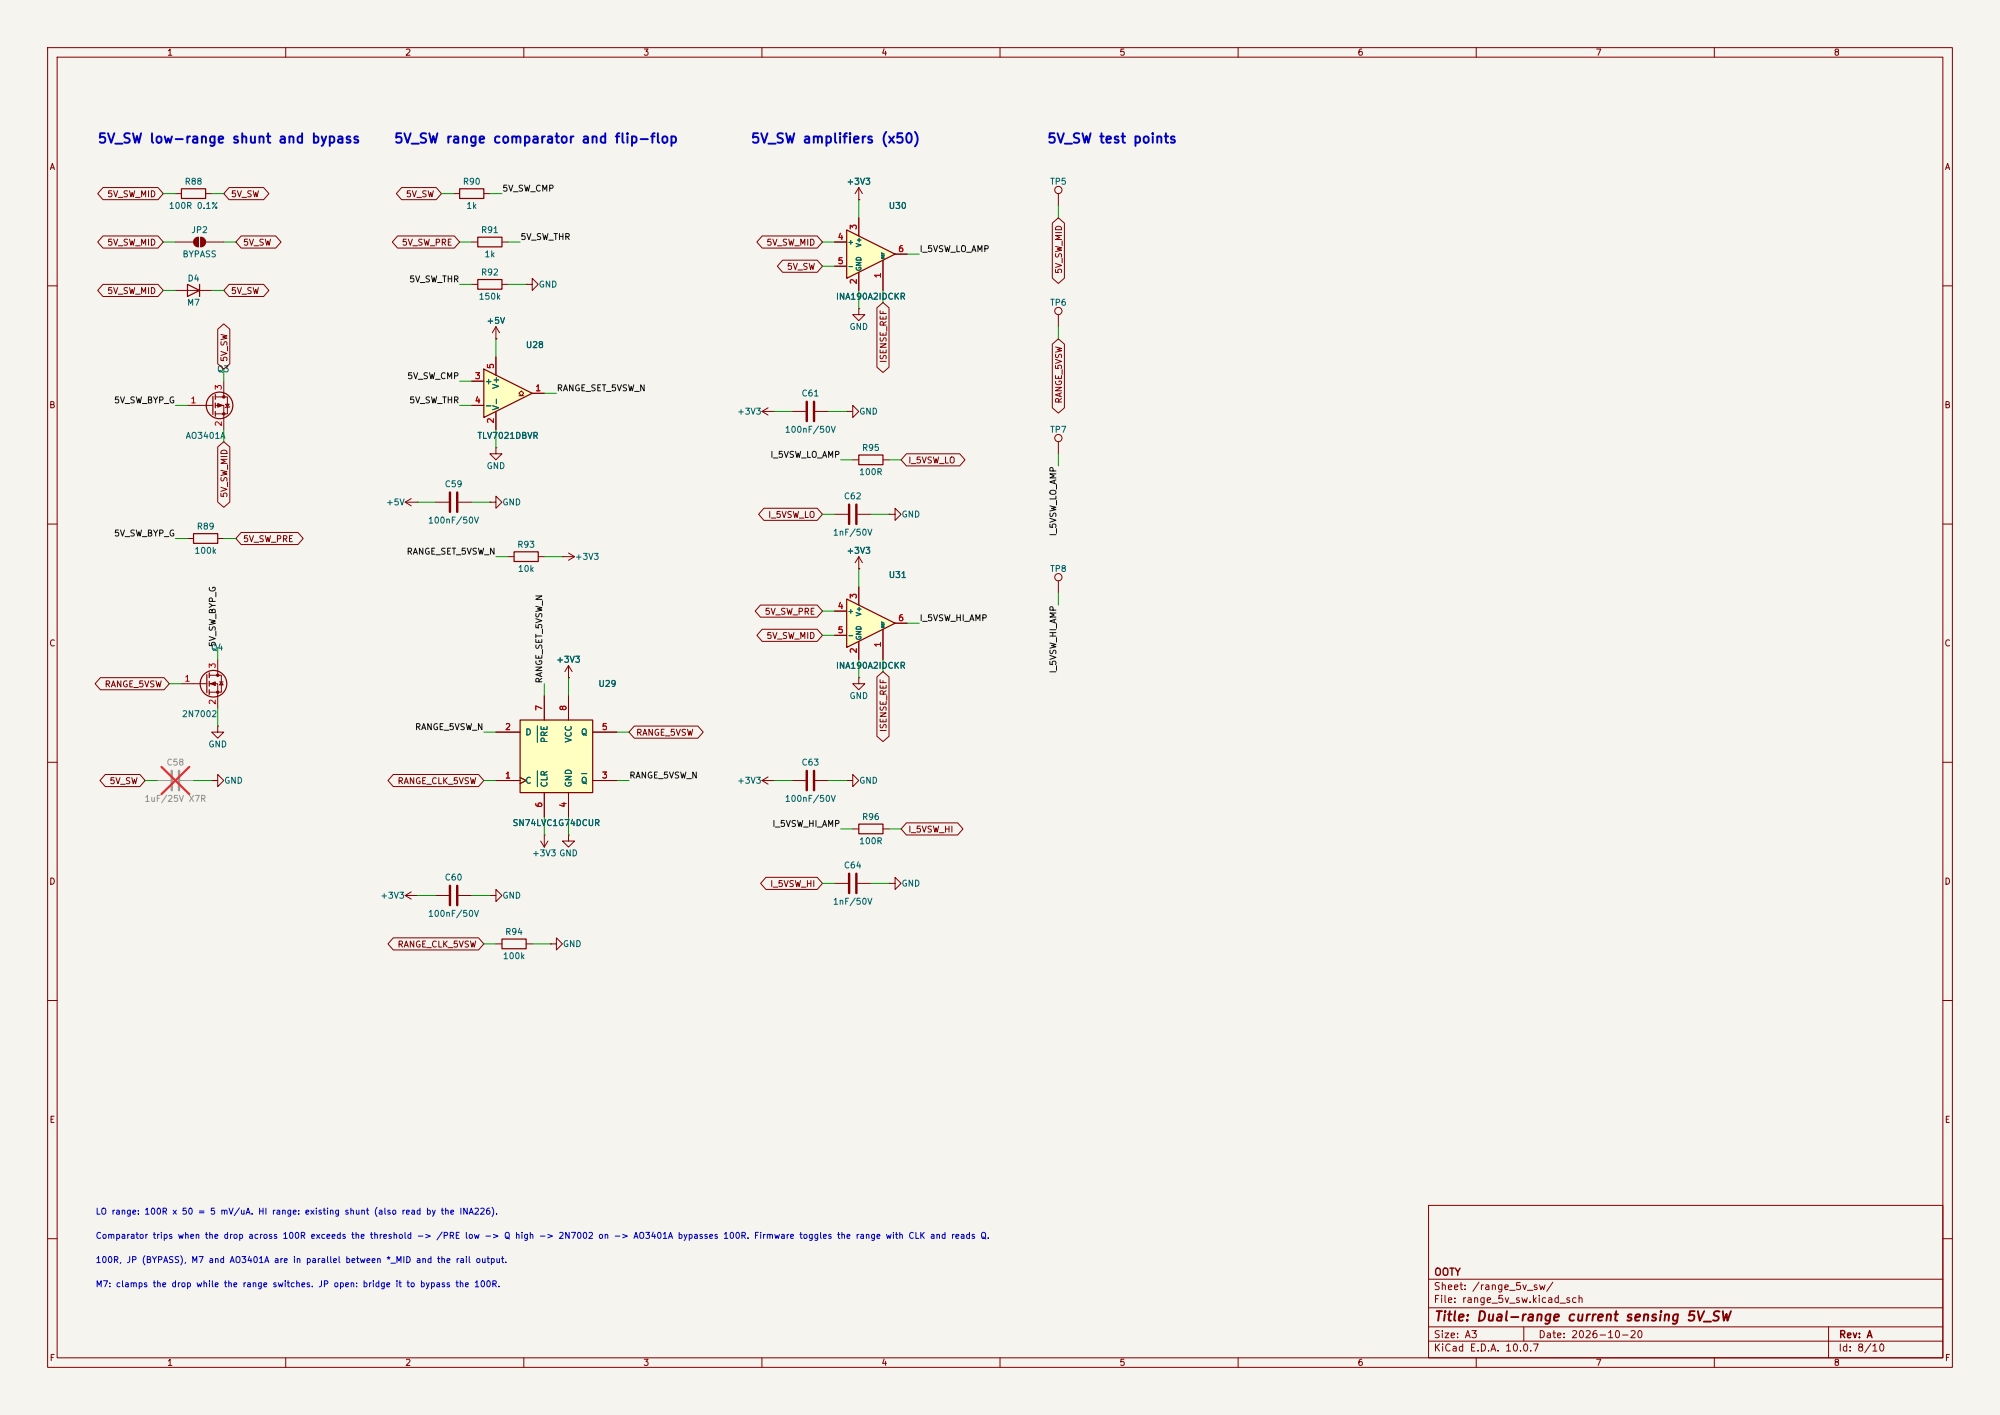
[picture p24: page 8]

5V_SW low-range shunt and bypass

LO range: 100R x 50 = 5 mV/uA. HI range: existing shunt (also read by the INA226).

Comparator trips when the drop across 100R exceeds the threshold -> /PRE low -> Q high -> 2N7002 on -> AO3401A bypasses 100R. Firmware toggles the range with CLK and reads Q. 100R, JP (BYPASS), M7 and AO3401A are in parallel between *_MID and the rail output. M7: clamps the drop while the range switches. JP open: bridge it to bypass the 100R.

OOTY
Sheet: /range_5v_sw/
File: range_5v_sw.kicad_sch
Title: Dual-range current sensing 5V_SW

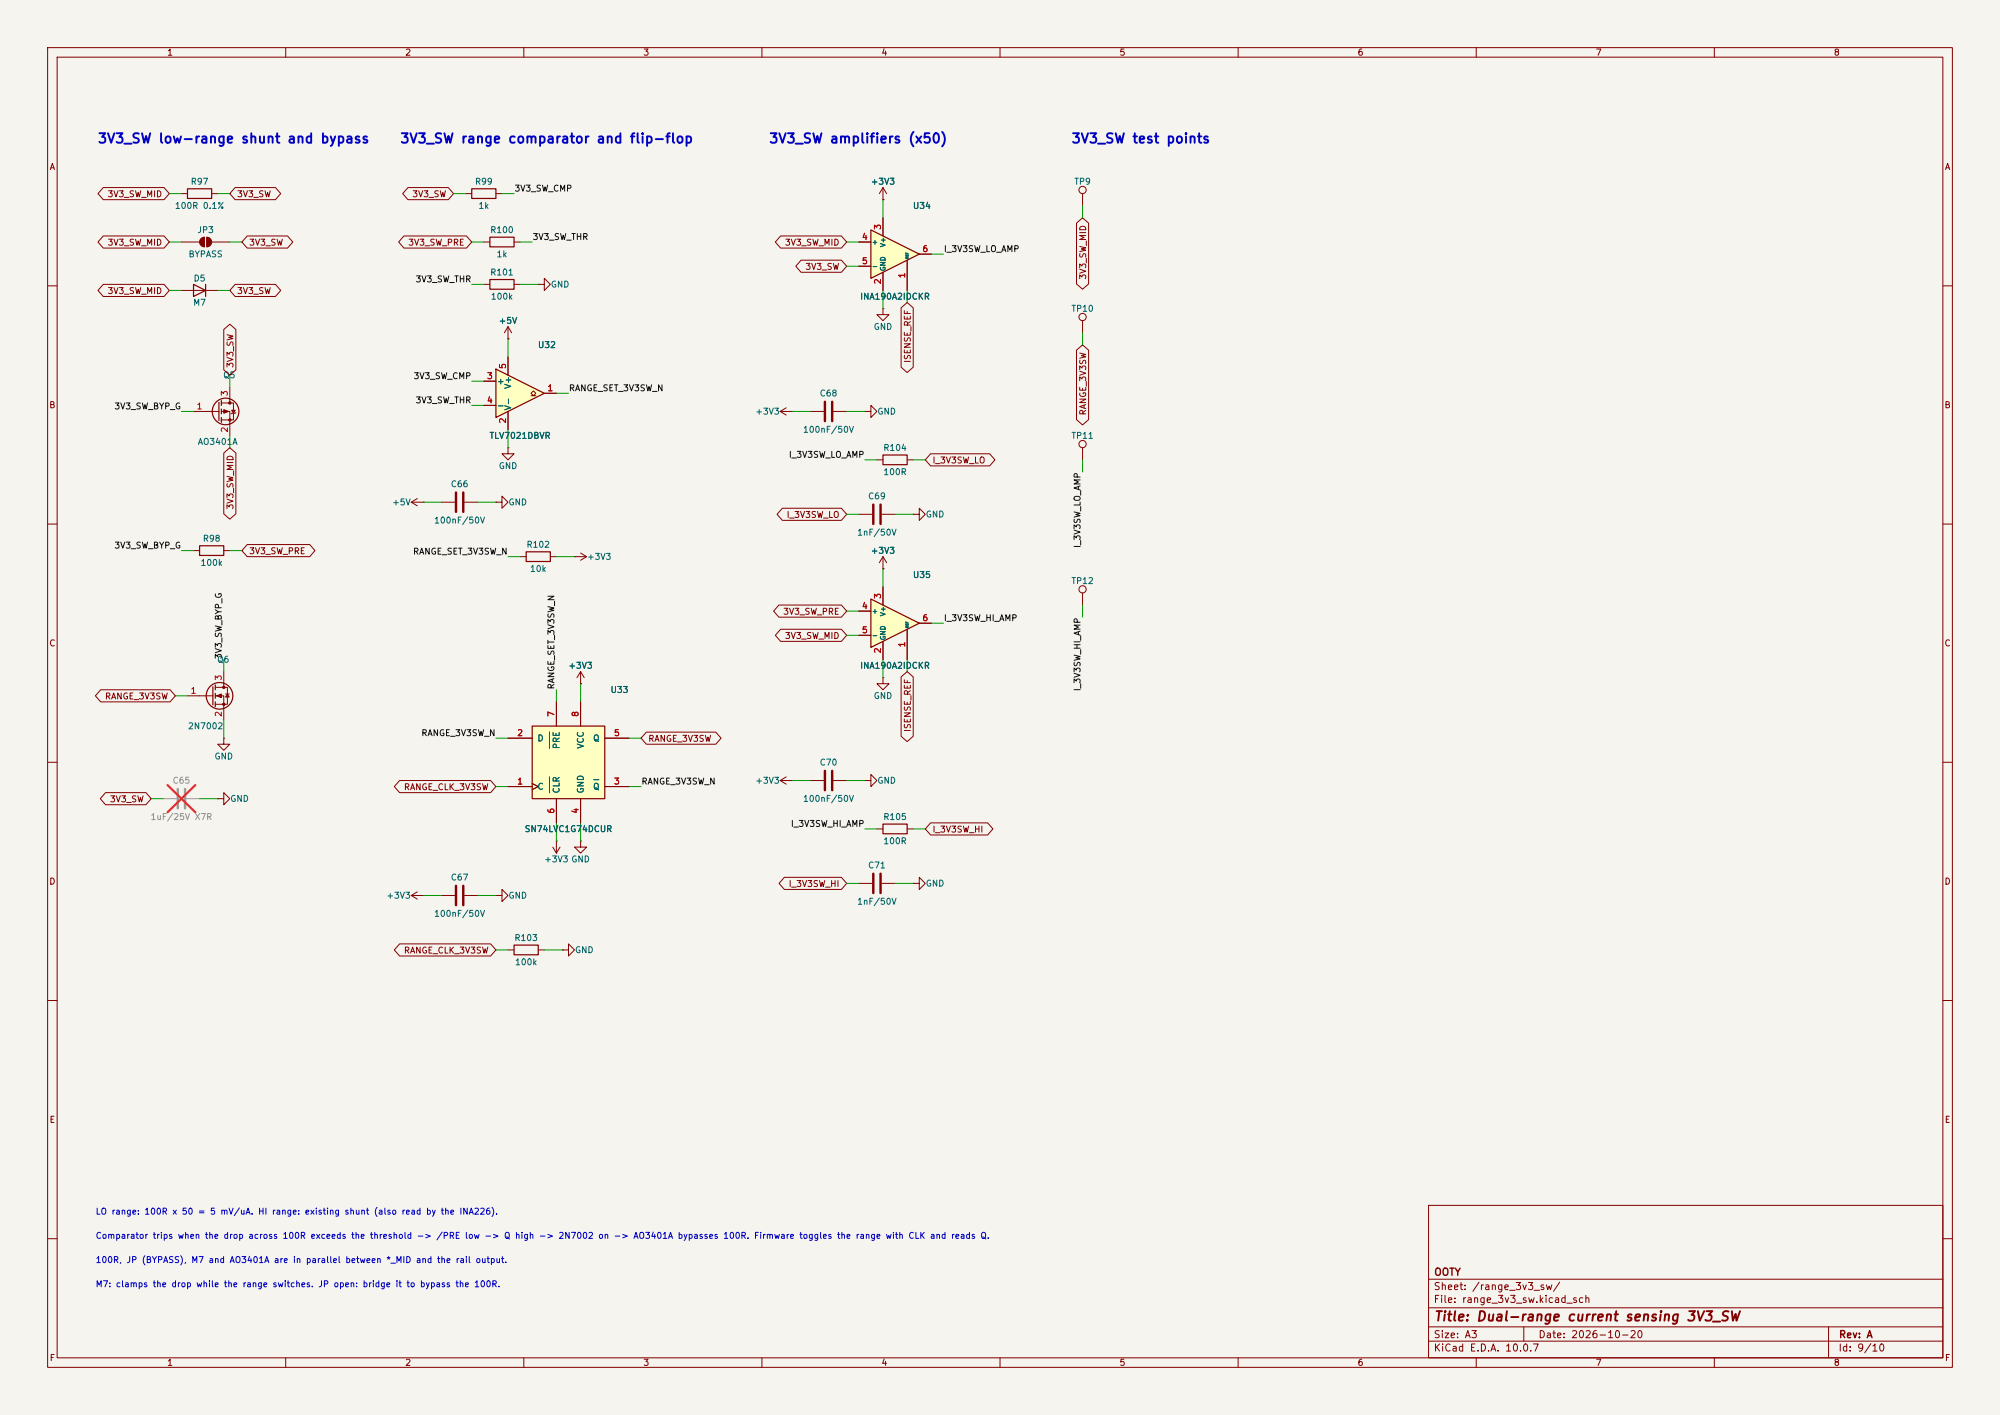
[picture p25: page 9]

100R, JP (BYPASS), M7 and AO3401A are in parallel between *_MID and the rail output. LO range: 100R x 50 = 5 mV/uA. HI range: existing shunt (also read by the INA226).

Comparator trips when the drop across 100R exceeds the threshold -> /PRE low -> Q high -> 2N7002 on -> AO3401A bypasses 100R. Firmware toggles the range with CLK and reads Q. M7: clamps the drop while the range switches. JP open: bridge it to bypass the 100R.

OOTY
Sheet: /range_3v3_sw/
File: range_3v3_sw.kicad_sch
Title: Dual-range current sensing 3V3_SW

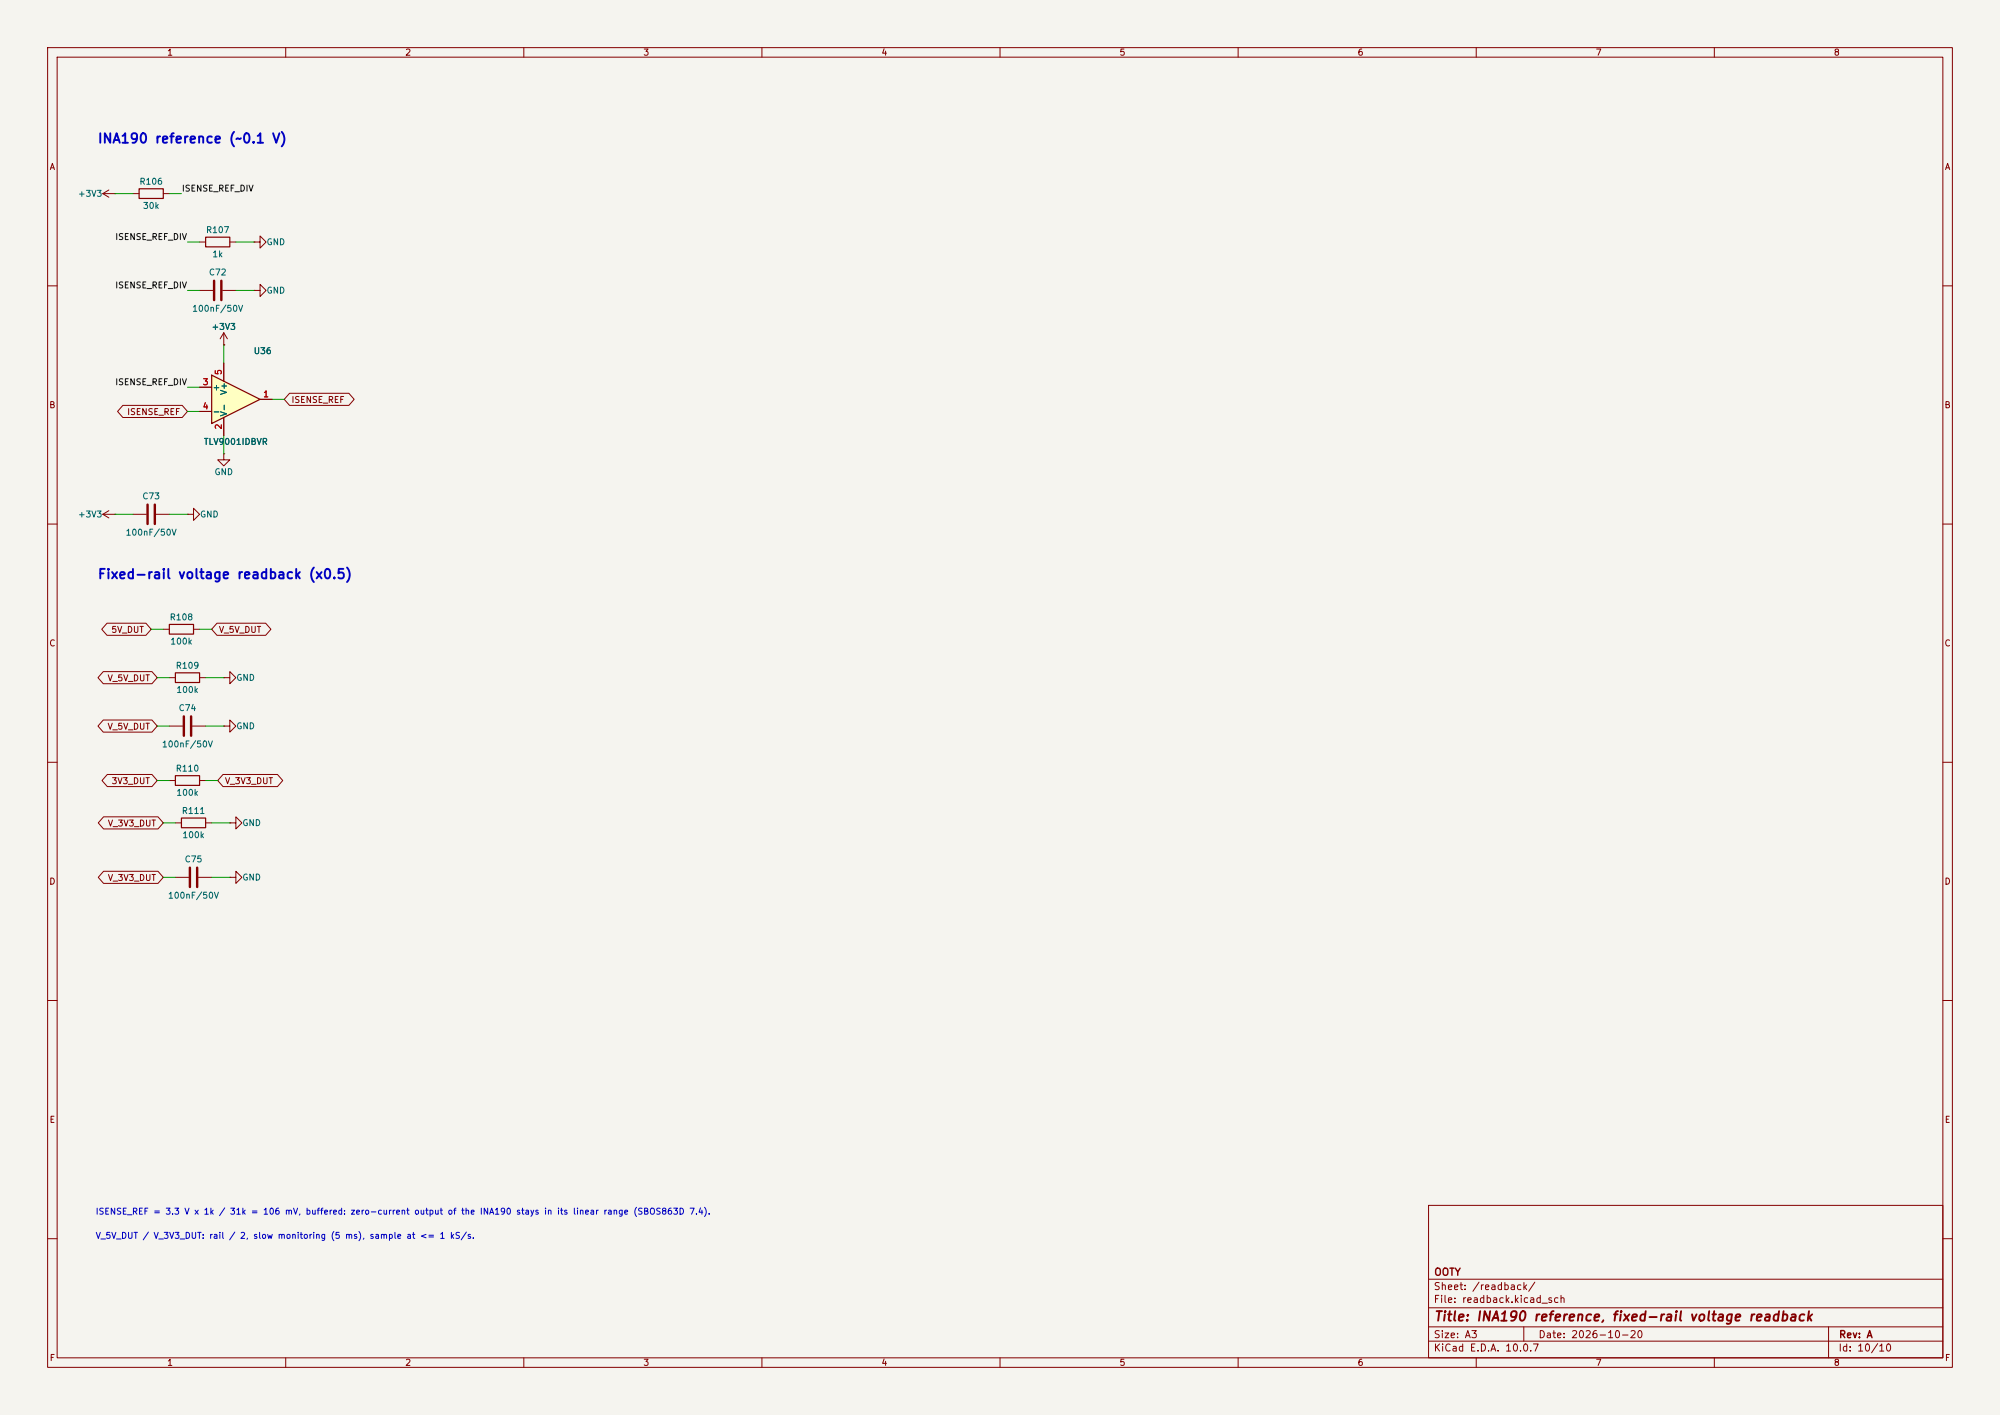
[picture p26: page 10]

ISENSE_REF_DIV Fixed-rail voltage readback (x0.5)

ISENSE_REF = 3.3 V x 1k / 31k = 106 mV, buffered: zero-current output of the INA190 stays in its linear range (SBOS863D 7.4).

V_5V_DUT / V_3V3_DUT: rail / 2, slow monitoring (5 ms), sample at <= 1 kS/s.

OOTY
Sheet: /readback/
File: readback.kicad_sch
Title: INA190 reference, fixed-rail voltage readback
