AlksGit/OOTY-/out/renders/pcb_placement_assembly_top.pdf

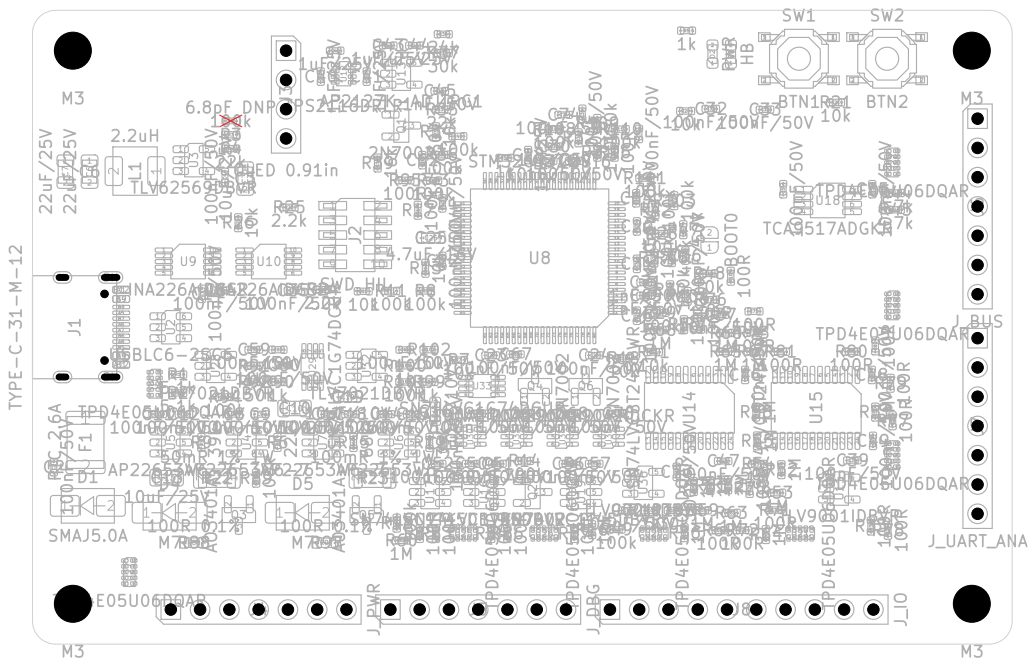
[picture p28: page 1]

Size: A4 | Rev:
KiCad E.D.A. 10.0.7 | Id: 1/1
