AlksGit/OOTY-/OOTY.kicad_pcb

## KiCad design OOTY.kicad_pcb (2026-10-20)

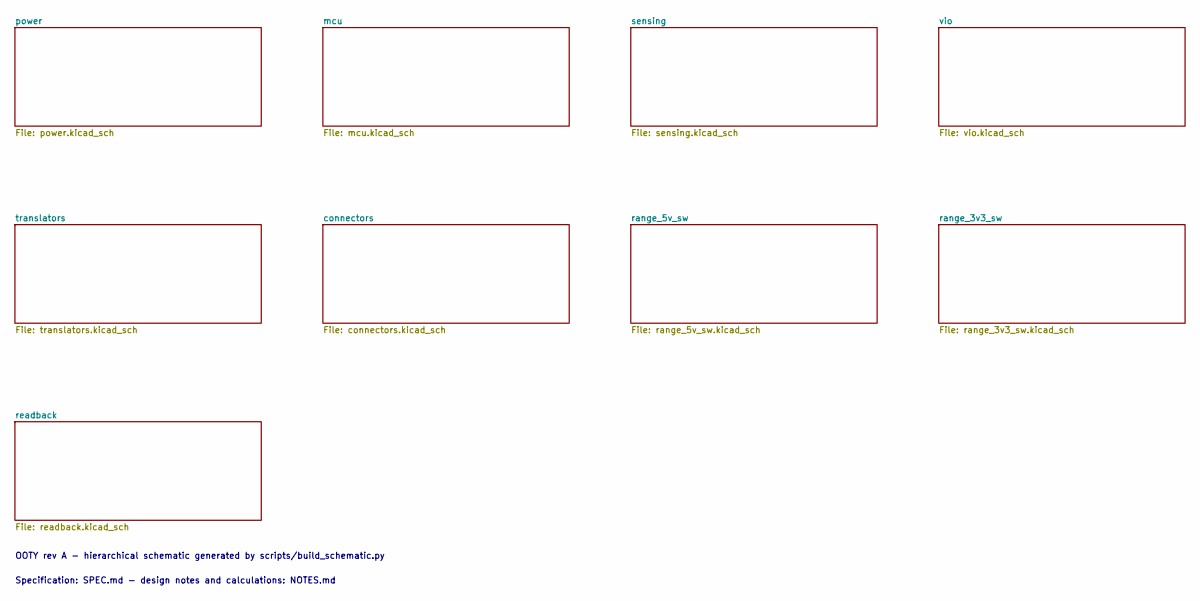
[picture p29: schematic OOTY.kicad_sch, OOTY - USB Hardware-in-the-Loop board]

Notes on the sheet:
OOTY rev A - hierarchical schematic generated by scripts/build_schematic.py
Specification: SPEC.md - design notes and calculations: NOTES.md

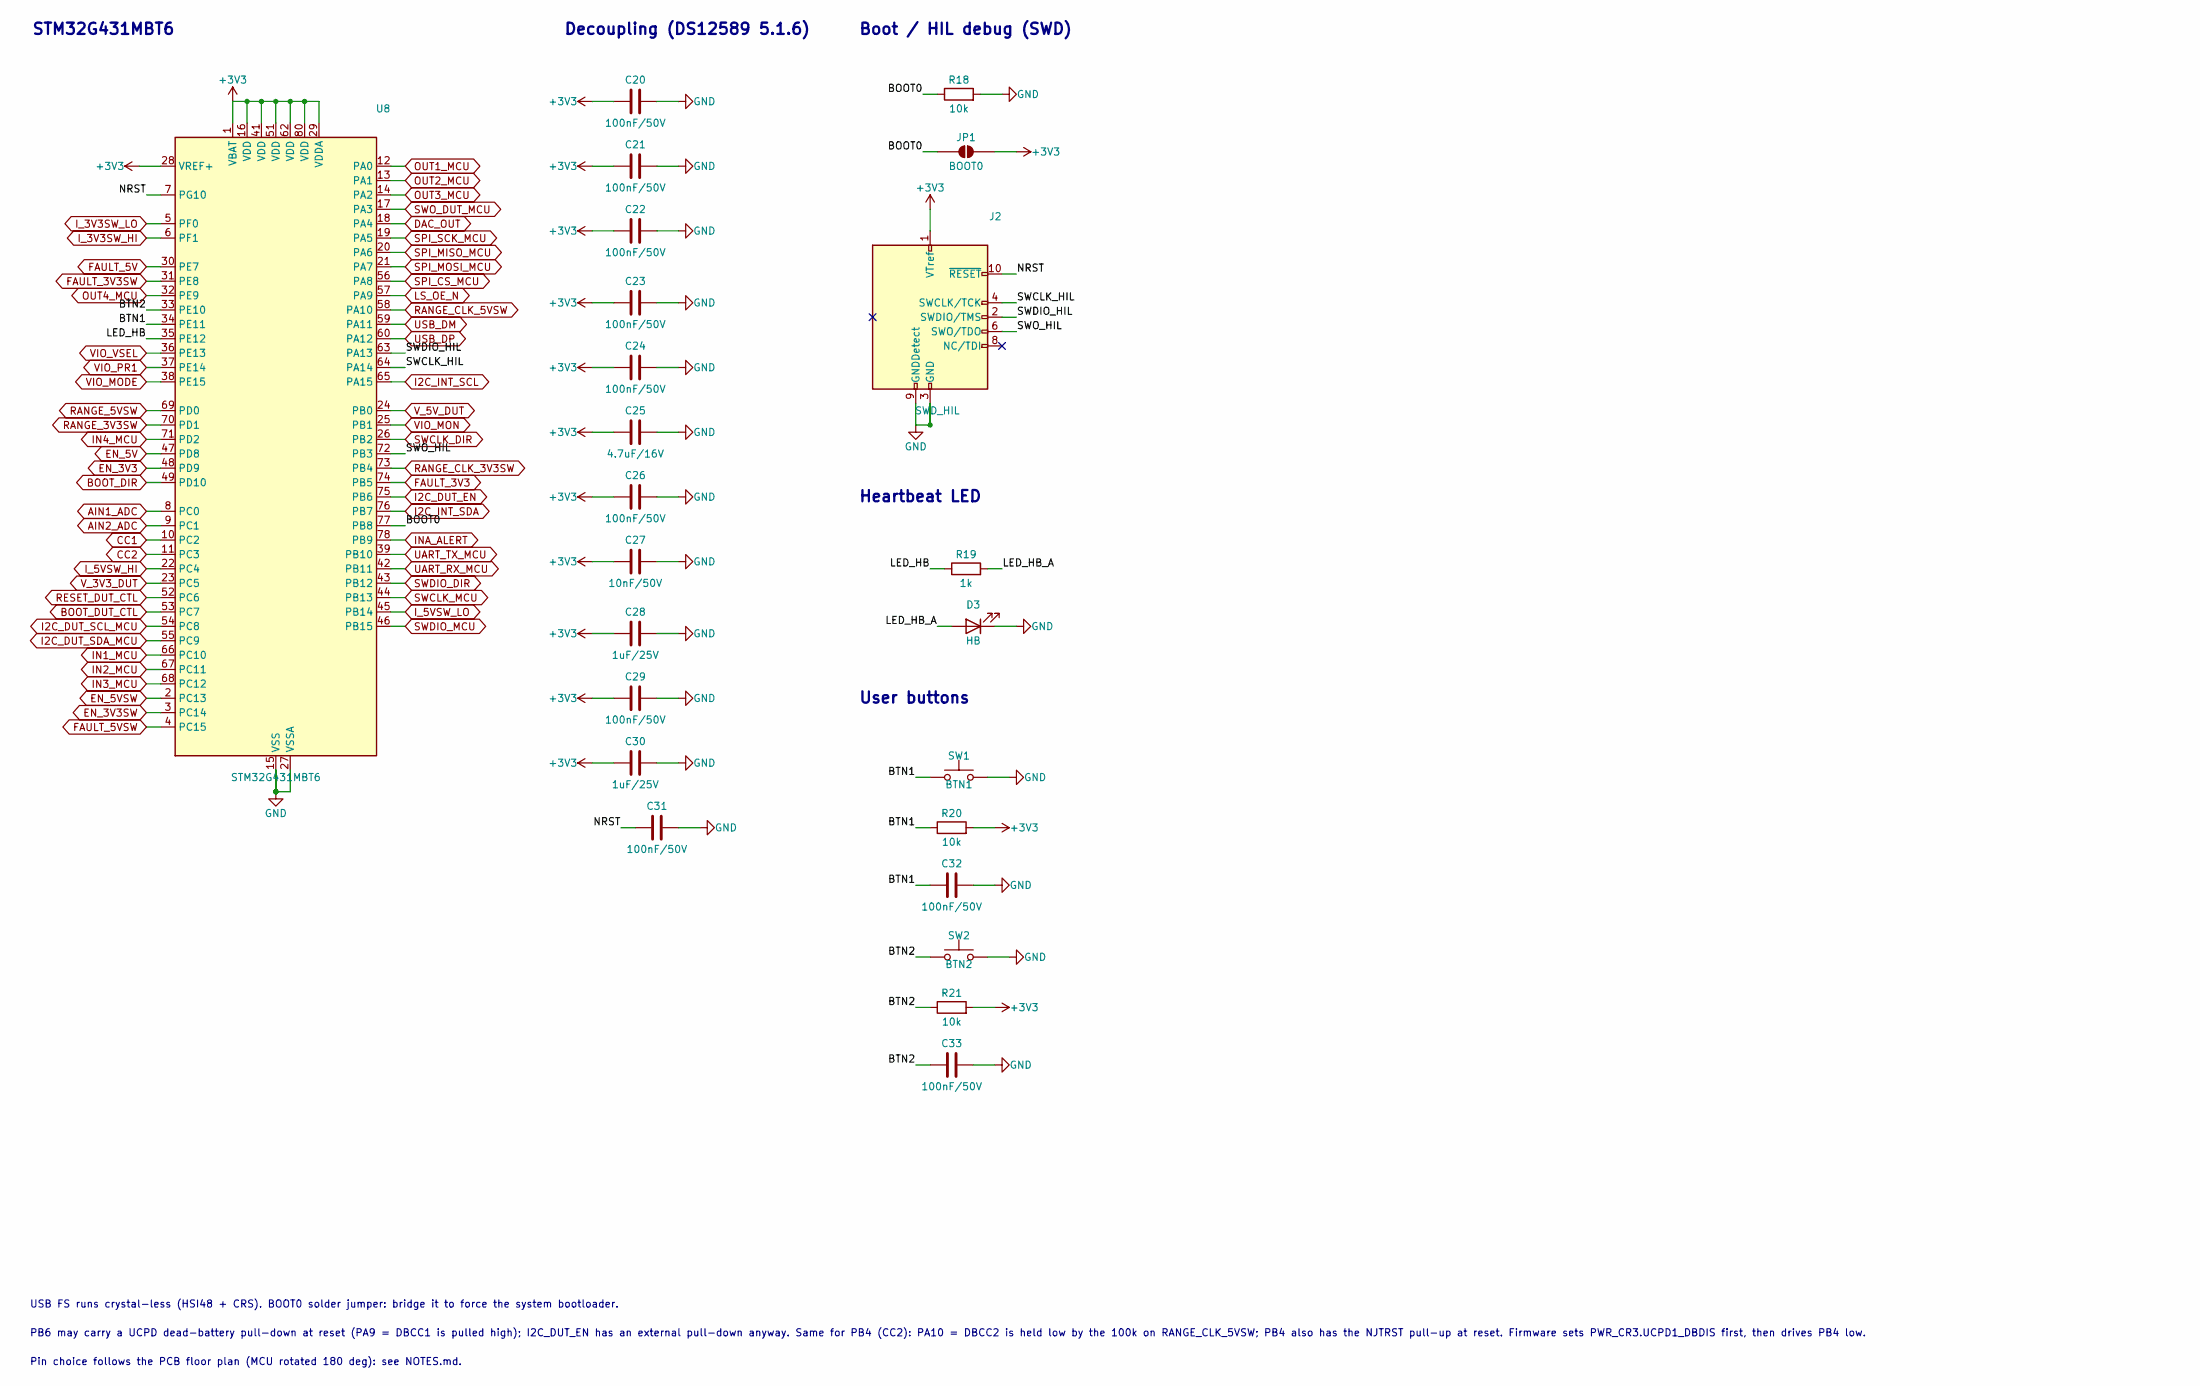
[picture p30: schematic mcu.kicad_sch, MCU STM32G431MBT6]

Parts:
C20, C21, C22, C23, C24, C26, C29, C31, C32, C33: 100nF/50V; C_0402_1005Metric; MPN CL05B104KB54PNC; LCSC C307331
C25: 4.7uF/16V; C_0603_1608Metric; MPN CL10A475KO8NNNC; LCSC C19666
C27: 10nF/50V; C_0402_1005Metric; MPN CL05B103KB5NNNC; LCSC C15195
C28, C30: 1uF/25V; C_0402_1005Metric; MPN CL05A105KA5NQNC; LCSC C52923
D3: HB; LED_0603_1608Metric; MPN KT-0603R; LCSC C2286
J2: SWD_HIL; PinHeader_2x05_P1.27mm_Vertical_SMD; MPN DZ127S-22-10-55; LCSC C5160761
JP1: BOOT0; SolderJumper-2_P1.3mm_Open_RoundedPad1.0x1.5mm
R18, R20, R21: 10k; R_0402_1005Metric; MPN 0402WGF1002TCE; LCSC C25744
R19: 1k; R_0402_1005Metric; MPN 0402WGF1001TCE; LCSC C11702
SW1: BTN1; SW_Push_1P1T_XKB_TS-1187A; MPN TS-1187A-B-A-B; LCSC C318884
SW2: BTN2; SW_Push_1P1T_XKB_TS-1187A; MPN TS-1187A-B-A-B; LCSC C318884
U8: STM32G431MBT6; LQFP-80_12x12mm_P0.5mm; MPN STM32G431MBT6; LCSC C730099

Connections:
+3V3: C20.1, C21.1, C22.1, C23.1, C24.1, C25.1, C26.1, C27.1, C28.1, C29.1, C30.1, J2.1 (VTref), JP1.2 (B), R20.2, R21.2, U8.1 (VBAT), U8.16 (VDD), U8.28 (VREF+), U8.29 (VDDA), U8.41 (VDD), U8.51 (VDD), U8.62 (VDD), U8.80 (VDD); also elsewhere on the board
/mcu/BOOT0: JP1.1 (A), R18.1, U8.77 (PB8)
/mcu/BTN1: C32.1, R20.1, SW1.1, U8.34 (PE11)
/mcu/BTN2: C33.1, R21.1, SW2.1, U8.33 (PE10)
/mcu/LED_HB: R19.1, U8.35 (PE12)
/mcu/LED_HB_A: D3.2 (A), R19.2
/mcu/NRST: C31.1, J2.10 (~RESET), U8.7 (PG10)
/mcu/SWCLK_HIL: J2.4 (SWCLK/TCK), U8.64 (PA14)
/mcu/SWDIO_HIL: J2.2 (SWDIO/TMS), U8.63 (PA13)
/mcu/SWO_HIL: J2.6 (SWO/TDO), U8.72 (PB3)
AIN1_ADC: U8.8 (PC0); also elsewhere on the board
AIN2_ADC: U8.9 (PC1); also elsewhere on the board
BOOT_DIR: U8.49 (PD10); also elsewhere on the board
BOOT_DUT_CTL: U8.53 (PC7); also elsewhere on the board
CC1: U8.10 (PC2); also elsewhere on the board
CC2: U8.11 (PC3); also elsewhere on the board
DAC_OUT: U8.18 (PA4); also elsewhere on the board
EN_3V3: U8.48 (PD9); also elsewhere on the board
EN_3V3SW: U8.3 (PC14); also elsewhere on the board
EN_5V: U8.47 (PD8); also elsewhere on the board
EN_5VSW: U8.2 (PC13); also elsewhere on the board
FAULT_3V3: U8.74 (PB5); also elsewhere on the board
FAULT_3V3SW: U8.31 (PE8); also elsewhere on the board
FAULT_5V: U8.30 (PE7); also elsewhere on the board
FAULT_5VSW: U8.4 (PC15); also elsewhere on the board
GND: C20.2, C21.2, C22.2, C23.2, C24.2, C25.2, C26.2, C27.2, C28.2, C29.2, C30.2, C31.2, C32.2, C33.2, D3.1 (K), J2.3 (GND), J2.5 (GND), J2.9 (GNDDetect), R18.2, SW1.2, SW2.2, U8.15 (VSS), U8.27 (VSSA), U8.40 (VSS), U8.50 (VSS), U8.61 (VSS), U8.79 (VSS); also elsewhere on the board
I2C_DUT_EN: U8.75 (PB6); also elsewhere on the board
I2C_DUT_SCL_MCU: U8.54 (PC8); also elsewhere on the board
I2C_DUT_SDA_MCU: U8.55 (PC9); also elsewhere on the board
I2C_INT_SCL: U8.65 (PA15); also elsewhere on the board
I2C_INT_SDA: U8.76 (PB7); also elsewhere on the board
IN1_MCU: U8.66 (PC10); also elsewhere on the board
IN2_MCU: U8.67 (PC11); also elsewhere on the board
IN3_MCU: U8.68 (PC12); also elsewhere on the board
IN4_MCU: U8.71 (PD2); also elsewhere on the board
INA_ALERT: U8.78 (PB9); also elsewhere on the board
I_3V3SW_HI: U8.6 (PF1); also elsewhere on the board
I_3V3SW_LO: U8.5 (PF0); also elsewhere on the board
I_5VSW_HI: U8.22 (PC4); also elsewhere on the board
I_5VSW_LO: U8.45 (PB14); also elsewhere on the board
LS_OE_N: U8.57 (PA9); also elsewhere on the board
OUT1_MCU: U8.12 (PA0); also elsewhere on the board
OUT2_MCU: U8.13 (PA1); also elsewhere on the board
OUT3_MCU: U8.14 (PA2); also elsewhere on the board
OUT4_MCU: U8.32 (PE9); also elsewhere on the board
RANGE_3V3SW: U8.70 (PD1); also elsewhere on the board
RANGE_5VSW: U8.69 (PD0); also elsewhere on the board
RANGE_CLK_3V3SW: U8.73 (PB4); also elsewhere on the board
RANGE_CLK_5VSW: U8.58 (PA10); also elsewhere on the board
RESET_DUT_CTL: U8.52 (PC6); also elsewhere on the board
SPI_CS_MCU: U8.56 (PA8); also elsewhere on the board
SPI_MISO_MCU: U8.20 (PA6); also elsewhere on the board
SPI_MOSI_MCU: U8.21 (PA7); also elsewhere on the board
SPI_SCK_MCU: U8.19 (PA5); also elsewhere on the board
SWCLK_DIR: U8.26 (PB2); also elsewhere on the board
SWCLK_MCU: U8.44 (PB13); also elsewhere on the board
SWDIO_DIR: U8.43 (PB12); also elsewhere on the board
SWDIO_MCU: U8.46 (PB15); also elsewhere on the board
SWO_DUT_MCU: U8.17 (PA3); also elsewhere on the board
UART_RX_MCU: U8.42 (PB11); also elsewhere on the board
UART_TX_MCU: U8.39 (PB10); also elsewhere on the board
USB_DM: U8.59 (PA11); also elsewhere on the board
USB_DP: U8.60 (PA12); also elsewhere on the board
VIO_MODE: U8.38 (PE15); also elsewhere on the board
VIO_MON: U8.25 (PB1); also elsewhere on the board
VIO_PR1: U8.37 (PE14); also elsewhere on the board
VIO_VSEL: U8.36 (PE13); also elsewhere on the board
V_3V3_DUT: U8.23 (PC5); also elsewhere on the board
V_5V_DUT: U8.24 (PB0); also elsewhere on the board

Notes on the sheet:
Decoupling (DS12589 5.1.6)
Pin choice follows the PCB floor plan (MCU rotated 180 deg): see NOTES.md.
Heartbeat LED
PB6 may carry a UCPD dead-battery pull-down at reset (PA9 = DBCC1 is pulled high); I2C_DUT_EN has an external pull-down anyway. Same for PB4 (CC2): PA10 = DBCC2 is held low by the 100k on RANGE_CLK_5VSW; PB4 also has the NJTRST pull-up at reset. Firmware sets PWR_CR3.UCPD1_DBDIS first, then drives 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
User buttons
Boot / HIL debug (SWD)
USB FS runs crystal-less (HSI48 + CRS). BOOT0 solder jumper: bridge it to force the system bootloader.
STM32G431MBT6

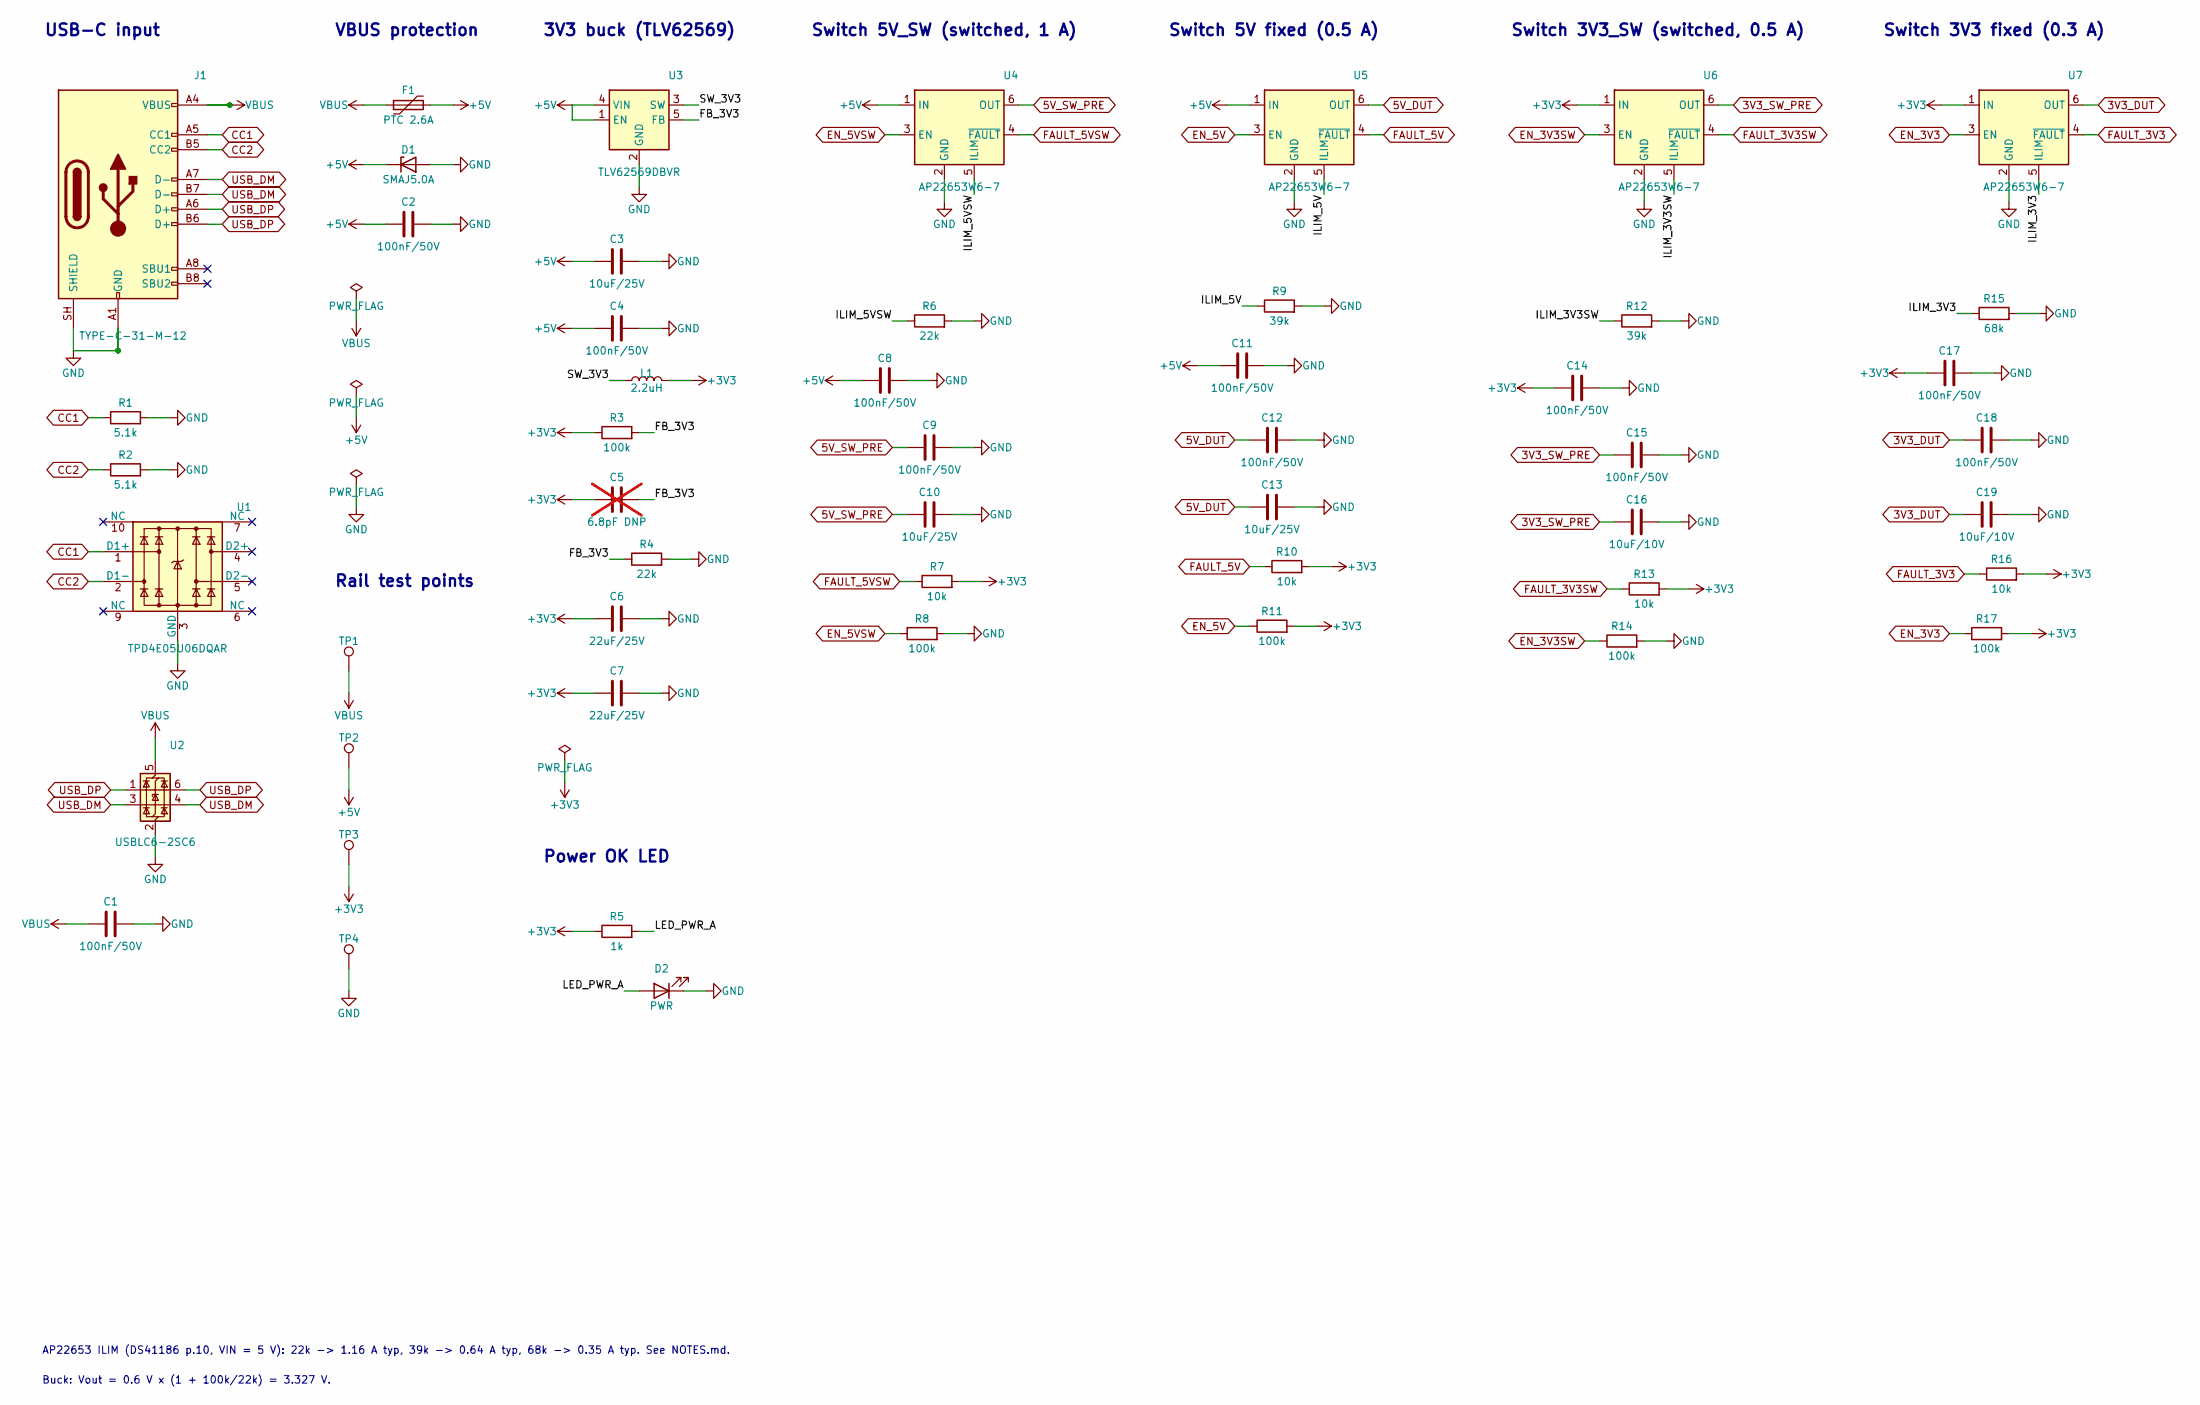
[picture p31: schematic power.kicad_sch, Power: USB-C, 3V3 buck, DUT rails]

Parts:
C1, C2, C4, C8, C9, C11, C12, C14, C15, C17, C18: 100nF/50V; C_0402_1005Metric; MPN CL05B104KB54PNC; LCSC C307331
C3, C10, C13: 10uF/25V; C_0805_2012Metric; MPN CL21A106KAYNNNE; LCSC C15850
C5: 6.8pF DNP; C_0402_1005Metric; not fitted
C6, C7: 22uF/25V; C_0805_2012Metric; MPN CL21A226MAQNNNE; LCSC C45783
C16, C19: 10uF/10V; C_0603_1608Metric; MPN CL10A106KP8NNNC; LCSC C19702
D1: SMAJ5.0A; D_SMA; MPN SMAJ5.0A; LCSC C83329
D2: PWR; LED_0603_1608Metric; MPN XL-1608SYGC-06; LCSC C965805
F1: PTC 2.6A; Fuse_1812_4532Metric; MPN SMD1812P260TF; LCSC C21003
J1: TYPE-C-31-M-12; USB_C_Receptacle_HRO_TYPE-C-31-M-12; MPN TYPE-C-31-M-12; LCSC C165948
L1: 2.2uH; L_Changjiang_FXL0420; MPN FXL0420-2R2-M; LCSC C167206
R1, R2: 5.1k; R_0402_1005Metric; MPN 0402WGF5101TCE; LCSC C25905
R3, R8, R11, R14, R17: 100k; R_0402_1005Metric; MPN 0402WGF1003TCE; LCSC C25741
R4, R6: 22k; R_0402_1005Metric; MPN 0402WGF2202TCE; LCSC C25768
R5: 1k; R_0402_1005Metric; MPN 0402WGF1001TCE; LCSC C11702
R7, R10, R13, R16: 10k; R_0402_1005Metric; MPN 0402WGF1002TCE; LCSC C25744
R9, R12: 39k; R_0402_1005Metric; MPN 0402WGF3902TCE; LCSC C25783
R15: 68k; R_0402_1005Metric; MPN 0402WGF6802TCE; LCSC C36871
TP1: VBUS; TestPoint_Pad_D1.5mm
TP2: +5V; TestPoint_Pad_D1.5mm
TP3: +3V3; TestPoint_Pad_D1.5mm
TP4: GND; TestPoint_Pad_D1.5mm
U1: TPD4E05U06DQAR; USON-10_2.5x1.0mm_P0.5mm; MPN TPD4E05U06DQAR; LCSC C138714
U2: USBLC6-2SC6; SOT-23-6; MPN USBLC6-2SC6; LCSC C7519
U3: TLV62569DBVR; SOT-23-5; MPN TLV62569DBVR; LCSC C141836
U4, U5, U6, U7: AP22653W6-7; SOT-23-6; MPN AP22653W6-7; LCSC C2158037

Connections:
3V3_DUT: C18.1, C19.1, U7.6 (OUT); also elsewhere on the board
3V3_SW_PRE: C15.1, C16.1, U6.6 (OUT); also elsewhere on the board
5V_DUT: C12.1, C13.1, U5.6 (OUT); also elsewhere on the board
5V_SW_PRE: C9.1, C10.1, U4.6 (OUT); also elsewhere on the board
+3V3: C5.1, C6.1, C7.1, C14.1, C17.1, L1.2, R3.1, R5.1, R7.2, R10.2, R11.2, R13.2, R16.2, R17.2, TP3.1, U6.1 (IN), U7.1 (IN); also elsewhere on the board
+5V: C2.1, C3.1, C4.1, C8.1, C11.1, D1.1 (K), F1.2, TP2.1, U3.1 (EN), U3.4 (VIN), U4.1 (IN), U5.1 (IN); also elsewhere on the board
/power/FB_3V3: C5.2, R3.2, R4.1, U3.5 (FB)
/power/ILIM_3V3: R15.1, U7.5 (ILIM)
/power/ILIM_3V3SW: R12.1, U6.5 (ILIM)
/power/ILIM_5V: R9.1, U5.5 (ILIM)
/power/ILIM_5VSW: R6.1, U4.5 (ILIM)
/power/LED_PWR_A: D2.2 (A), R5.2
/power/SW_3V3: L1.1, U3.3 (SW)
CC1: J1.A5 (CC1), R1.1, U1.1 (D1+); also elsewhere on the board
CC2: J1.B5 (CC2), R2.1, U1.2 (D1-); also elsewhere on the board
EN_3V3: R17.1, U7.3 (EN); also elsewhere on the board
EN_3V3SW: R14.1, U6.3 (EN); also elsewhere on the board
EN_5V: R11.1, U5.3 (EN); also elsewhere on the board
EN_5VSW: R8.1, U4.3 (EN); also elsewhere on the board
FAULT_3V3: R16.1, U7.4 (~FAULT); also elsewhere on the board
FAULT_3V3SW: R13.1, U6.4 (~FAULT); also elsewhere on the board
FAULT_5V: R10.1, U5.4 (~FAULT); also elsewhere on the board
FAULT_5VSW: R7.1, U4.4 (~FAULT); also elsewhere on the board
GND: C1.2, C2.2, C3.2, C4.2, C6.2, C7.2, C8.2, C9.2, C10.2, C11.2, C12.2, C13.2, C14.2, C15.2, C16.2, C17.2, C18.2, C19.2, D1.2 (A), D2.1 (K), J1.A1 (GND), J1.A12 (GND), J1.B1 (GND), J1.B12 (GND), J1.SH (SHIELD), R1.2, R2.2, R4.2, R6.2, R8.2, R9.2, R12.2, R14.2, R15.2, TP4.1, U1.3 (GND), U1.8 (GND), U2.2 (GND), U3.2 (GND), U4.2 (GND), U5.2 (GND), U6.2 (GND), U7.2 (GND); also elsewhere on the board
USB_DM: J1.A7 (D-), J1.B7 (D-), U2.3 (I/O2), U2.4 (I/O2); also elsewhere on the board
USB_DP: J1.A6 (D+), J1.B6 (D+), U2.1 (I/O1), U2.6 (I/O1); also elsewhere on the board
VBUS: C1.1, F1.1, J1.A4 (VBUS), J1.A9 (VBUS), J1.B4 (VBUS), J1.B9 (VBUS), TP1.1, U2.5 (VBUS)

Notes on the sheet:
USB-C input
3V3 buck (TLV62569)
AP22653 ILIM (DS41186 p.10, VIN = 5 V): 22k -> 1.16 A typ, 39k -> 0.64 A typ, 68k -> 0.35 A typ. See NOTES.md.
Power OK LED
Buck: Vout = 0.6 V x (1 + 100k/22k) = 3.327 V.
Switch 3V3 fixed (0.3 A)
Switch 3V3_SW (switched, 0.5 A)
Rail test points
VBUS protection
Switch 5V fixed (0.5 A)
Switch 5V_SW (switched, 1 A)

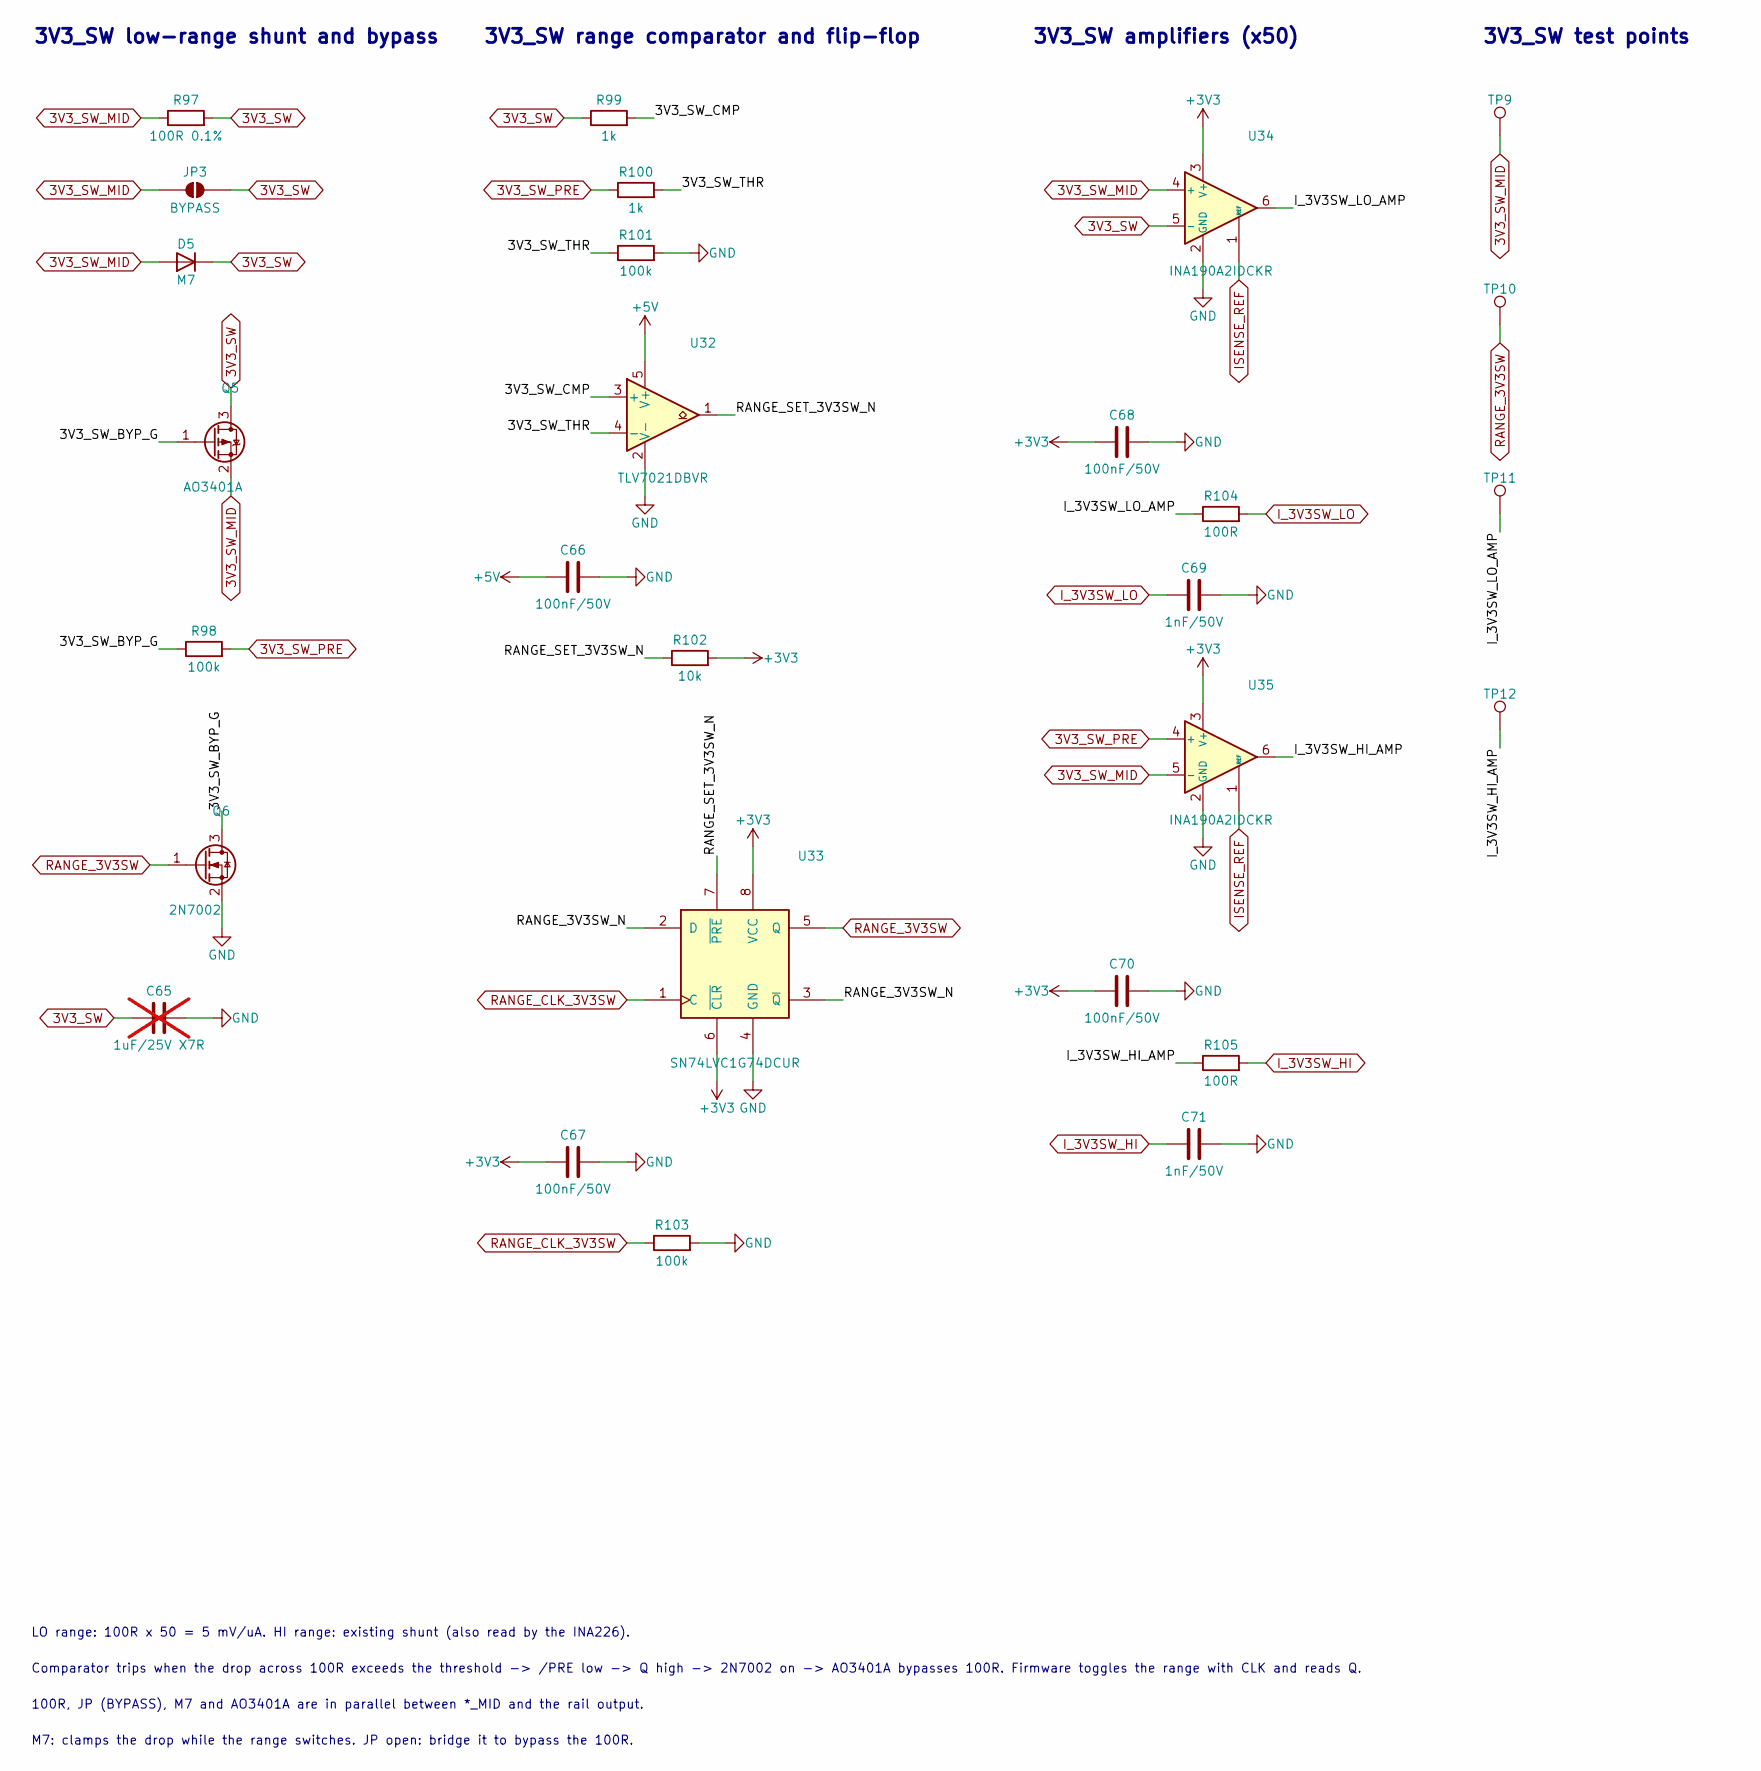
[picture p32: schematic range_3v3_sw.kicad_sch, Dual-range current sensing 3V3_SW]

Parts:
C65: 1uF/25V X7R; C_0603_1608Metric; MPN CL10B105KA8NNNC; LCSC_DNP C29936; not fitted
C66, C67, C68, C70: 100nF/50V; C_0402_1005Metric; MPN CL05B104KB54PNC; LCSC C307331
C69, C71: 1nF/50V; C_0402_1005Metric; MPN 0402B102K500NT; LCSC C1523
D5: M7; D_SMA; MPN M7; LCSC C95872
JP3: BYPASS; SolderJumper-2_P1.3mm_Open_RoundedPad1.0x1.5mm
Q5: AO3401A; SOT-23; MPN AO3401A; LCSC C15127
Q6: 2N7002; SOT-23; MPN 2N7002; LCSC C8545
R97: 100R 0.1%; R_0603_1608Metric; MPN RT0603BRD07100RL; LCSC C122970
R98, R101, R103: 100k; R_0402_1005Metric; MPN 0402WGF1003TCE; LCSC C25741
R99, R100: 1k; R_0402_1005Metric; MPN 0402WGF1001TCE; LCSC C11702
R102: 10k; R_0402_1005Metric; MPN 0402WGF1002TCE; LCSC C25744
R104, R105: 100R; R_0402_1005Metric; MPN 0402WGF1000TCE; LCSC C25076
TP9: 3V3_SW_MID; TestPoint_Pad_D1.5mm
TP10: RANGE_3V3SW; TestPoint_Pad_D1.5mm
TP11: I_3V3SW_LO_AMP; TestPoint_Pad_D1.5mm
TP12: I_3V3SW_HI_AMP; TestPoint_Pad_D1.5mm
U32: TLV7021DBVR; SOT-23-5; MPN TLV7021DBVR; LCSC C2860939
U33: SN74LVC1G74DCUR; VSSOP-8_2.3x2mm_P0.5mm; MPN SN74LVC1G74DCUR; LCSC C70285
U34, U35: INA190A2IDCKR; SOT-363_SC-70-6; MPN INA190A2IDCKR; LCSC C2870223

Connections:
3V3_SW: C65.1, D5.1 (K), JP3.2 (B), Q5.3 (D), R97.2, R99.1, U34.5 (-); also elsewhere on the board
3V3_SW_MID: D5.2 (A), JP3.1 (A), Q5.2 (S), R97.1, TP9.1, U34.4 (+), U35.5 (-); also elsewhere on the board
3V3_SW_PRE: R98.2, R100.1, U35.4 (+); also elsewhere on the board
+3V3: C67.1, C68.1, C70.1, R102.2, U33.6 (~CLR), U33.8 (VCC), U34.3 (V+), U35.3 (V+); also elsewhere on the board
+5V: C66.1, U32.5 (V+); also elsewhere on the board
/range_3v3_sw/3V3_SW_BYP_G: Q5.1 (G), Q6.3 (D), R98.1
/range_3v3_sw/3V3_SW_CMP: R99.2, U32.3 (+)
/range_3v3_sw/3V3_SW_THR: R100.2, R101.1, U32.4 (-)
/range_3v3_sw/I_3V3SW_HI_AMP: R105.1, TP12.1, U35.6
/range_3v3_sw/I_3V3SW_LO_AMP: R104.1, TP11.1, U34.6
/range_3v3_sw/RANGE_3V3SW_N: U33.2 (D), U33.3 (~Q)
/range_3v3_sw/RANGE_SET_3V3SW_N: R102.1, U32.1, U33.7 (~PRE)
GND: C65.2, C66.2, C67.2, C68.2, C69.2, C70.2, C71.2, Q6.2 (S), R101.2, R103.2, U32.2 (V-), U33.4 (GND), U34.2 (GND), U35.2 (GND); also elsewhere on the board
ISENSE_REF: U34.1 (REF), U35.1 (REF); also elsewhere on the board
I_3V3SW_HI: C71.1, R105.2; also elsewhere on the board
I_3V3SW_LO: C69.1, R104.2; also elsewhere on the board
RANGE_3V3SW: Q6.1 (G), TP10.1, U33.5 (Q); also elsewhere on the board
RANGE_CLK_3V3SW: R103.1, U33.1 (C); also elsewhere on the board

Notes on the sheet:
3V3_SW range comparator and flip-flop
100R, JP (BYPASS), M7 and AO3401A are in parallel between *_MID and the rail output.
3V3_SW low-range shunt and bypass
3V3_SW test points
LO range: 100R x 50 = 5 mV/uA. HI range: existing shunt (also read by the INA226).
Comparator trips when the drop across 100R exceeds the threshold -> /PRE low -> Q high -> 2N7002 on -> AO3401A bypasses 100R. Firmware toggles the range with CLK and reads Q.
M7: clamps the drop while the range switches. JP open: bridge it to bypass the 100R.
3V3_SW amplifiers (x50)

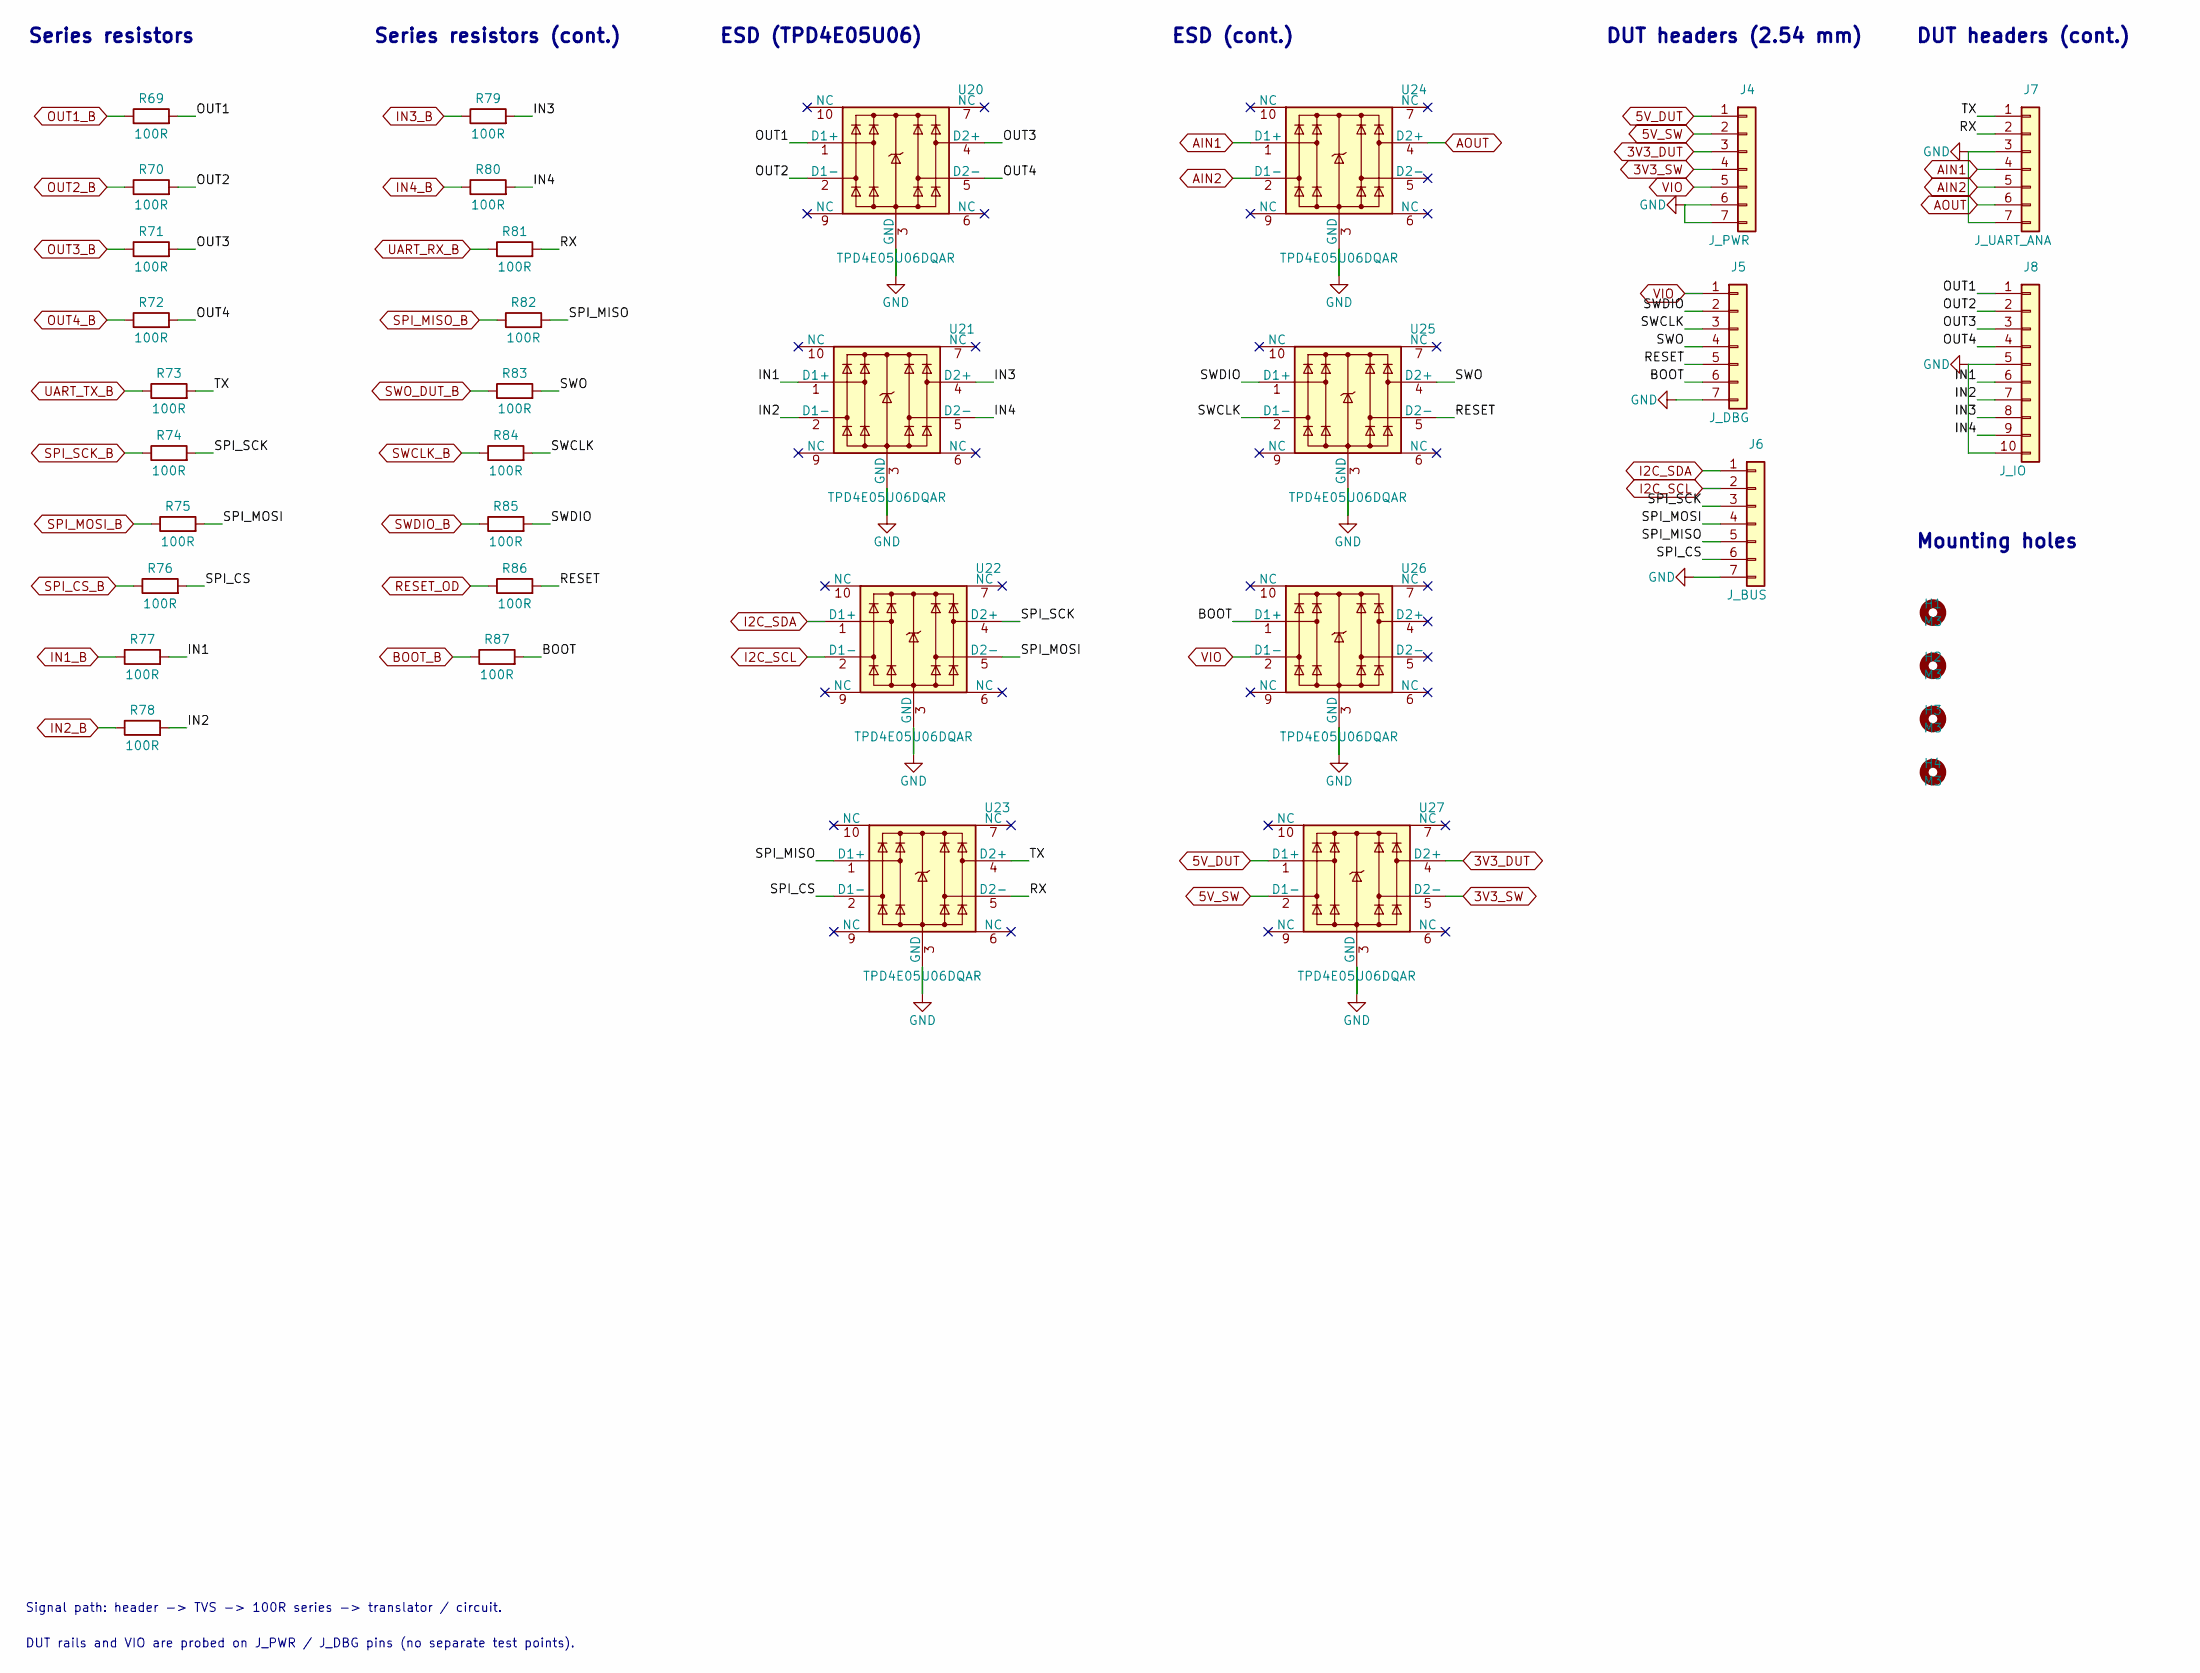
[picture p33: schematic connectors.kicad_sch, DUT connectors and ESD]

Parts:
H1, H2, H3, H4: M3; MountingHole_3.2mm_M3
J4: J_PWR; PinHeader_1x07_P2.54mm_Vertical; MPN PZ254V-11-07P; LCSC C492406
J5: J_DBG; PinHeader_1x07_P2.54mm_Vertical; MPN PZ254V-11-07P; LCSC C492406
J6: J_BUS; PinHeader_1x07_P2.54mm_Vertical; MPN PZ254V-11-07P; LCSC C492406
J7: J_UART_ANA; PinHeader_1x07_P2.54mm_Vertical; MPN PZ254V-11-07P; LCSC C492406
J8: J_IO; PinHeader_1x10_P2.54mm_Vertical; MPN PZ254V-11-10P; LCSC C492409
R69, R70, R71, R72, R73, R74, R75, R76, R77, R78, R79, R80, R81, R82, R83, R84, R85, R86, R87: 100R; R_0402_1005Metric; MPN 0402WGF1000TCE; LCSC C25076
U20, U21, U22, U23, U24, U25, U26, U27: TPD4E05U06DQAR; USON-10_2.5x1.0mm_P0.5mm; MPN TPD4E05U06DQAR; LCSC C138714

Connections:
3V3_DUT: J4.3, U27.4 (D2+); also elsewhere on the board
3V3_SW: J4.4, U27.5 (D2-); also elsewhere on the board
5V_DUT: J4.1, U27.1 (D1+); also elsewhere on the board
5V_SW: J4.2, U27.2 (D1-); also elsewhere on the board
/connectors/BOOT: J5.6, R87.2, U26.1 (D1+)
/connectors/IN1: J8.6, R77.2, U21.1 (D1+)
/connectors/IN2: J8.7, R78.2, U21.2 (D1-)
/connectors/IN3: J8.8, R79.2, U21.4 (D2+)
/connectors/IN4: J8.9, R80.2, U21.5 (D2-)
/connectors/OUT1: J8.1, R69.2, U20.1 (D1+)
/connectors/OUT2: J8.2, R70.2, U20.2 (D1-)
/connectors/OUT3: J8.3, R71.2, U20.4 (D2+)
/connectors/OUT4: J8.4, R72.2, U20.5 (D2-)
/connectors/RESET: J5.5, R86.2, U25.5 (D2-)
/connectors/RX: J7.2, R81.2, U23.5 (D2-)
/connectors/SPI_CS: J6.6, R76.2, U23.2 (D1-)
/connectors/SPI_MISO: J6.5, R82.2, U23.1 (D1+)
/connectors/SPI_MOSI: J6.4, R75.2, U22.5 (D2-)
/connectors/SPI_SCK: J6.3, R74.2, U22.4 (D2+)
/connectors/SWCLK: J5.3, R84.2, U25.2 (D1-)
/connectors/SWDIO: J5.2, R85.2, U25.1 (D1+)
/connectors/SWO: J5.4, R83.2, U25.4 (D2+)
/connectors/TX: J7.1, R73.2, U23.4 (D2+)
AIN1: J7.4, U24.1 (D1+); also elsewhere on the board
AIN2: J7.5, U24.2 (D1-); also elsewhere on the board
AOUT: J7.6, U24.4 (D2+); also elsewhere on the board
BOOT_B: R87.1; also elsewhere on the board
GND: J4.6, J4.7, J5.7, J6.7, J7.3, J7.7, J8.5, J8.10, U20.3 (GND), U20.8 (GND), U21.3 (GND), U21.8 (GND), U22.3 (GND), U22.8 (GND), U23.3 (GND), U23.8 (GND), U24.3 (GND), U24.8 (GND), U25.3 (GND), U25.8 (GND), U26.3 (GND), U26.8 (GND), U27.3 (GND), U27.8 (GND); also elsewhere on the board
I2C_SCL: J6.2, U22.2 (D1-); also elsewhere on the board
I2C_SDA: J6.1, U22.1 (D1+); also elsewhere on the board
IN1_B: R77.1; also elsewhere on the board
IN2_B: R78.1; also elsewhere on the board
IN3_B: R79.1; also elsewhere on the board
IN4_B: R80.1; also elsewhere on the board
OUT1_B: R69.1; also elsewhere on the board
OUT2_B: R70.1; also elsewhere on the board
OUT3_B: R71.1; also elsewhere on the board
OUT4_B: R72.1; also elsewhere on the board
RESET_OD: R86.1; also elsewhere on the board
SPI_CS_B: R76.1; also elsewhere on the board
SPI_MISO_B: R82.1; also elsewhere on the board
SPI_MOSI_B: R75.1; also elsewhere on the board
SPI_SCK_B: R74.1; also elsewhere on the board
SWCLK_B: R84.1; also elsewhere on the board
SWDIO_B: R85.1; also elsewhere on the board
SWO_DUT_B: R83.1; also elsewhere on the board
UART_RX_B: R81.1; also elsewhere on the board
UART_TX_B: R73.1; also elsewhere on the board
VIO: J4.5, J5.1, U26.2 (D1-); also elsewhere on the board

Notes on the sheet:
DUT rails and VIO are probed on J_PWR / J_DBG pins (no separate test points).
ESD (cont.)
DUT headers (cont.)
DUT headers (2.54 mm)
Series resistors (cont.)
Series resistors
Signal path: header -> TVS -> 100R series -> translator / circuit.
ESD (TPD4E05U06)
Mounting holes
