AlksGit/OOTY-/OOTY.kicad_pcb

## KiCad design OOTY.kicad_pcb (continued)

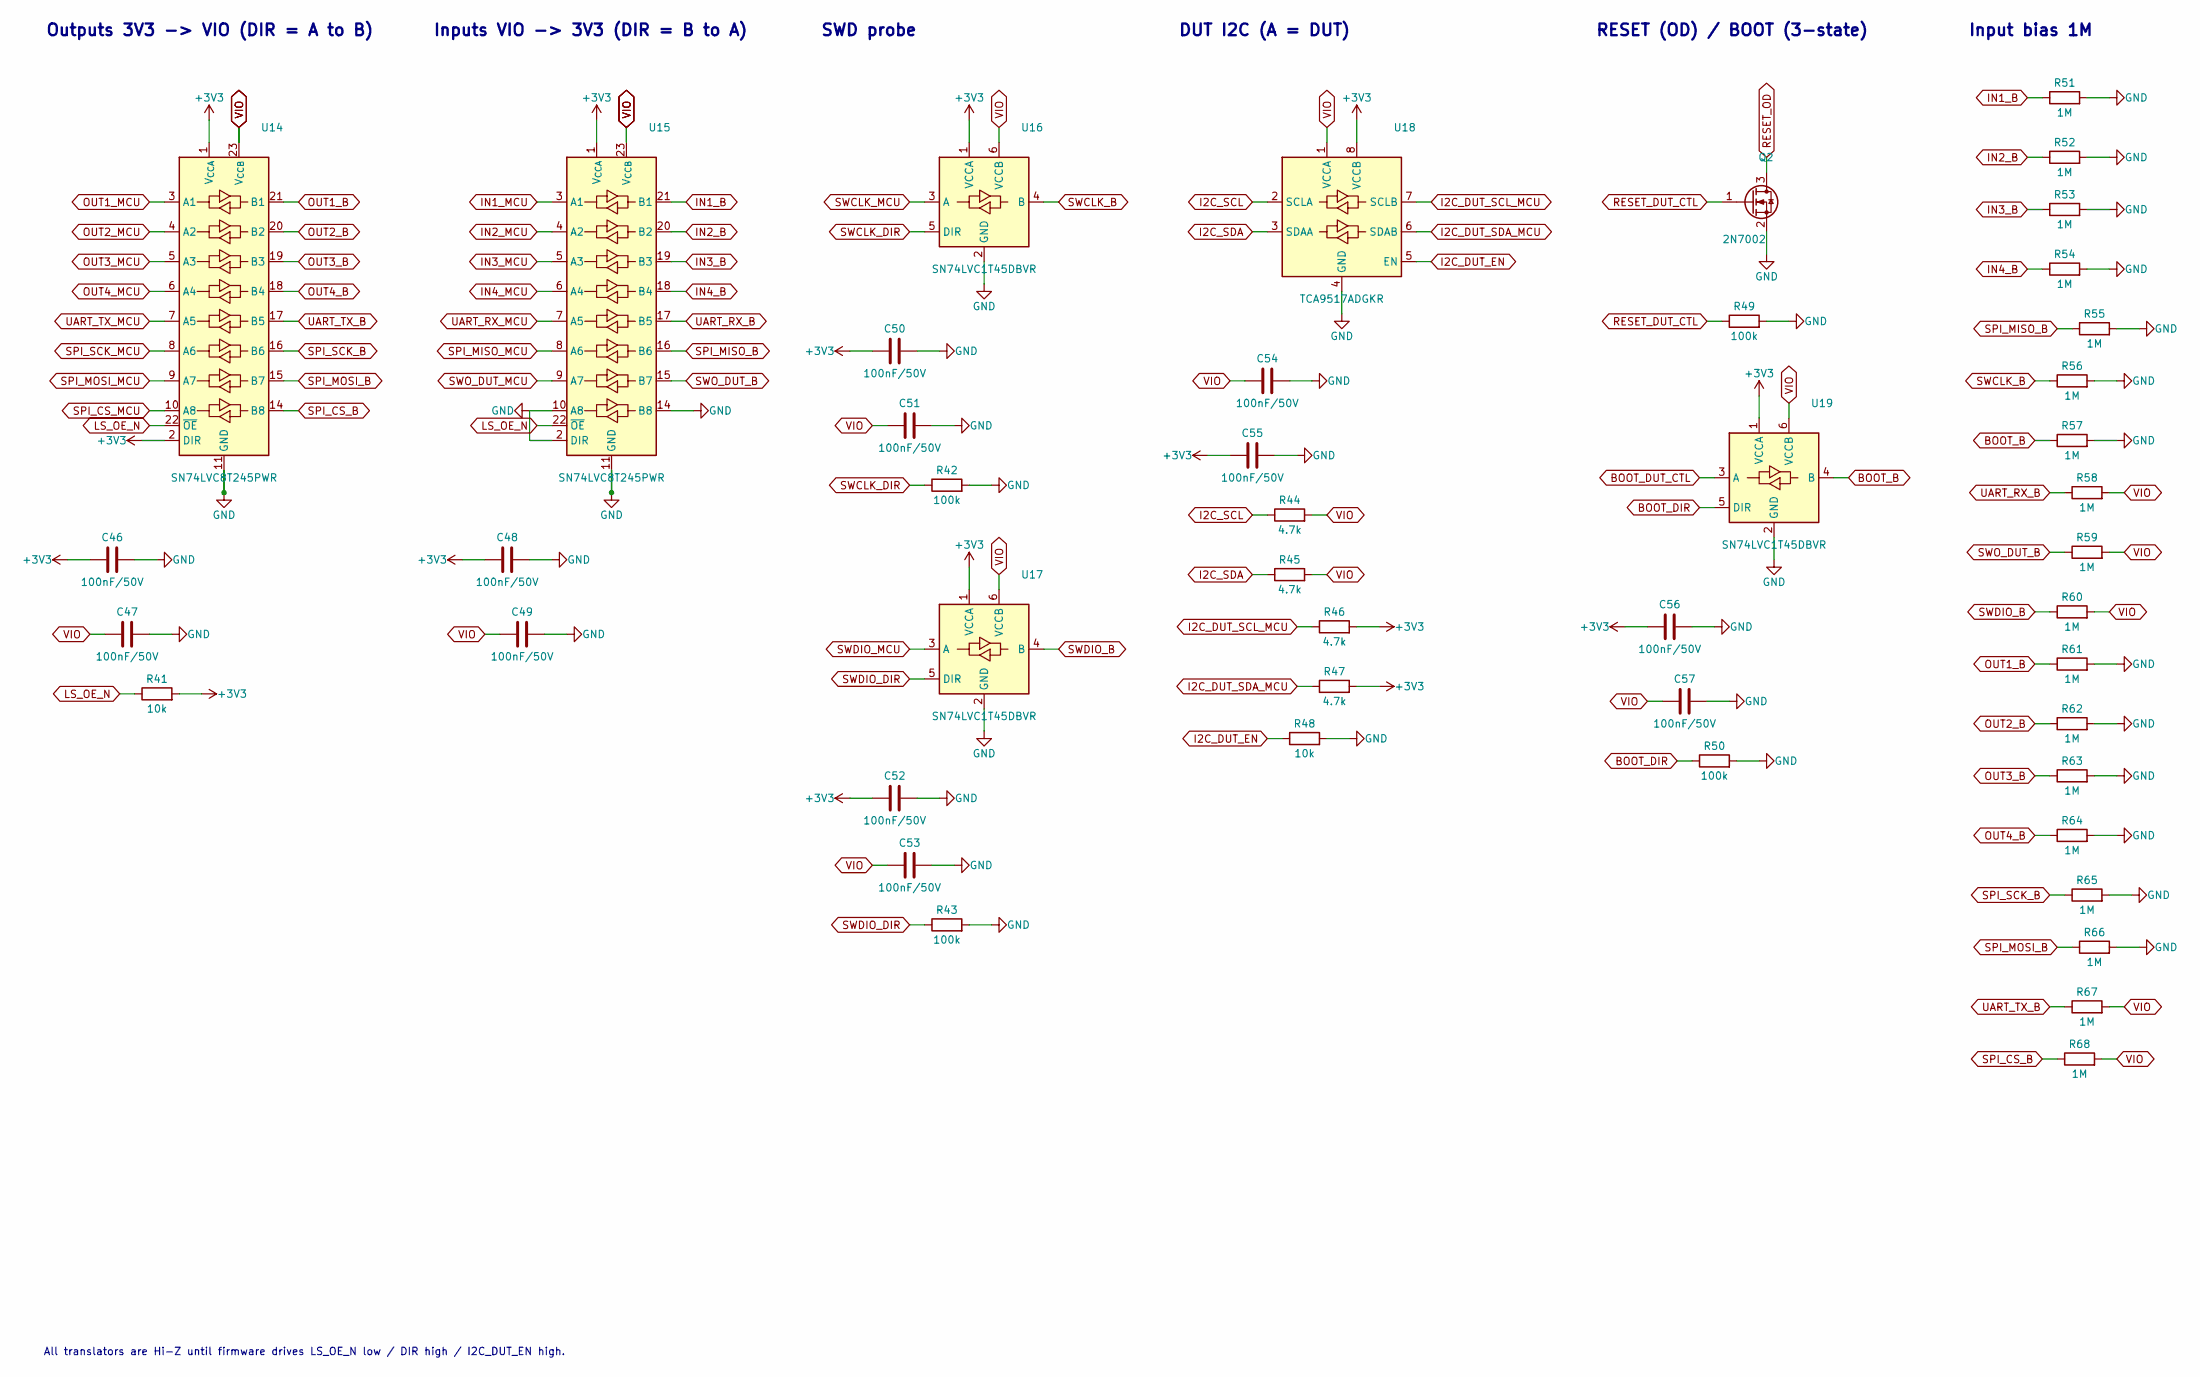
[picture p34: schematic translators.kicad_sch, Level translators 3V3 <-> VIO]

Parts:
C46, C47, C48, C49, C50, C51, C52, C53, C54, C55, C56, C57: 100nF/50V; C_0402_1005Metric; MPN CL05B104KB54PNC; LCSC C307331
Q2: 2N7002; SOT-23; MPN 2N7002; LCSC C8545
R41, R48: 10k; R_0402_1005Metric; MPN 0402WGF1002TCE; LCSC C25744
R42, R43, R49, R50: 100k; R_0402_1005Metric; MPN 0402WGF1003TCE; LCSC C25741
R44, R45, R46, R47: 4.7k; R_0402_1005Metric; MPN 0402WGF4701TCE; LCSC C25900
R51, R52, R53, R54, R55, R56, R57, R58, R59, R60, R61, R62, R63, R64, R65, R66, R67, R68: 1M; R_0402_1005Metric; MPN 0402WGF1004TCE; LCSC C26083
U14, U15: SN74LVC8T245PWR; TSSOP-24_4.4x7.8mm_P0.65mm; MPN SN74LVC8T245PWR; LCSC C27643
U16, U17, U19: SN74LVC1T45DBVR; SOT-23-6; MPN SN74LVC1T45DBVR; LCSC C7843
U18: TCA9517ADGKR; VSSOP-8_3x3mm_P0.65mm; MPN TCA9517ADGKR; LCSC C201698

Connections:
+3V3: C46.1, C48.1, C50.1, C52.1, C55.1, C56.1, R41.2, R46.2, R47.2, U14.1 (V_{CCA}), U14.2 (DIR), U15.1 (V_{CCA}), U16.1 (VCCA), U17.1 (VCCA), U18.8 (VCCB), U19.1 (VCCA); also elsewhere on the board
BOOT_B: R57.1, U19.4 (B); also elsewhere on the board
BOOT_DIR: R50.1, U19.5 (DIR); also elsewhere on the board
BOOT_DUT_CTL: U19.3 (A); also elsewhere on the board
GND: C46.2, C47.2, C48.2, C49.2, C50.2, C51.2, C52.2, C53.2, C54.2, C55.2, C56.2, C57.2, Q2.2 (S), R42.2, R43.2, R48.2, R49.2, R50.2, R51.2, R52.2, R53.2, R54.2, R55.2, R56.2, R57.2, R61.2, R62.2, R63.2, R64.2, R65.2, R66.2, U14.11 (GND), U14.12 (GND), U14.13 (GND), U15.2 (DIR), U15.10 (A8), U15.11 (GND), U15.12 (GND), U15.13 (GND), U15.14 (B8), U16.2 (GND), U17.2 (GND), U18.4 (GND), U19.2 (GND); also elsewhere on the board
I2C_DUT_EN: R48.1, U18.5 (EN); also elsewhere on the board
I2C_DUT_SCL_MCU: R46.1, U18.7 (SCLB); also elsewhere on the board
I2C_DUT_SDA_MCU: R47.1, U18.6 (SDAB); also elsewhere on the board
I2C_SCL: R44.1, U18.2 (SCLA); also elsewhere on the board
I2C_SDA: R45.1, U18.3 (SDAA); also elsewhere on the board
IN1_B: R51.1, U15.21 (B1); also elsewhere on the board
IN1_MCU: U15.3 (A1); also elsewhere on the board
IN2_B: R52.1, U15.20 (B2); also elsewhere on the board
IN2_MCU: U15.4 (A2); also elsewhere on the board
IN3_B: R53.1, U15.19 (B3); also elsewhere on the board
IN3_MCU: U15.5 (A3); also elsewhere on the board
IN4_B: R54.1, U15.18 (B4); also elsewhere on the board
IN4_MCU: U15.6 (A4); also elsewhere on the board
LS_OE_N: R41.1, U14.22 (~OE), U15.22 (~OE); also elsewhere on the board
OUT1_B: R61.1, U14.21 (B1); also elsewhere on the board
OUT1_MCU: U14.3 (A1); also elsewhere on the board
OUT2_B: R62.1, U14.20 (B2); also elsewhere on the board
OUT2_MCU: U14.4 (A2); also elsewhere on the board
OUT3_B: R63.1, U14.19 (B3); also elsewhere on the board
OUT3_MCU: U14.5 (A3); also elsewhere on the board
OUT4_B: R64.1, U14.18 (B4); also elsewhere on the board
OUT4_MCU: U14.6 (A4); also elsewhere on the board
RESET_DUT_CTL: Q2.1 (G), R49.1; also elsewhere on the board
RESET_OD: Q2.3 (D); also elsewhere on the board
SPI_CS_B: R68.1, U14.14 (B8); also elsewhere on the board
SPI_CS_MCU: U14.10 (A8); also elsewhere on the board
SPI_MISO_B: R55.1, U15.16 (B6); also elsewhere on the board
SPI_MISO_MCU: U15.8 (A6); also elsewhere on the board
SPI_MOSI_B: R66.1, U14.15 (B7); also elsewhere on the board
SPI_MOSI_MCU: U14.9 (A7); also elsewhere on the board
SPI_SCK_B: R65.1, U14.16 (B6); also elsewhere on the board
SPI_SCK_MCU: U14.8 (A6); also elsewhere on the board
SWCLK_B: R56.1, U16.4 (B); also elsewhere on the board
SWCLK_DIR: R42.1, U16.5 (DIR); also elsewhere on the board
SWCLK_MCU: U16.3 (A); also elsewhere on the board
SWDIO_B: R60.1, U17.4 (B); also elsewhere on the board
SWDIO_DIR: R43.1, U17.5 (DIR); also elsewhere on the board
SWDIO_MCU: U17.3 (A); also elsewhere on the board
SWO_DUT_B: R59.1, U15.15 (B7); also elsewhere on the board
SWO_DUT_MCU: U15.9 (A7); also elsewhere on the board
UART_RX_B: R58.1, U15.17 (B5); also elsewhere on the board
UART_RX_MCU: U15.7 (A5); also elsewhere on the board
UART_TX_B: R67.1, U14.17 (B5); also elsewhere on the board
UART_TX_MCU: U14.7 (A5); also elsewhere on the board
VIO: C47.1, C49.1, C51.1, C53.1, C54.1, C57.1, R44.2, R45.2, R58.2, R59.2, R60.2, R67.2, R68.2, U14.23 (V_{CCB}), U14.24 (V_{CCB}), U15.23 (V_{CCB}), U15.24 (V_{CCB}), U16.6 (VCCB), U17.6 (VCCB), U18.1 (VCCA), U19.6 (VCCB); also elsewhere on the board

Notes on the sheet:
Input bias 1M
DUT I2C (A = DUT)
SWD probe
Inputs VIO -> 3V3 (DIR = B to A)
RESET (OD) / BOOT (3-state)
Outputs 3V3 -> VIO (DIR = A to B)
All translators are Hi-Z until firmware drives LS_OE_N low / DIR high / I2C_DUT_EN high.

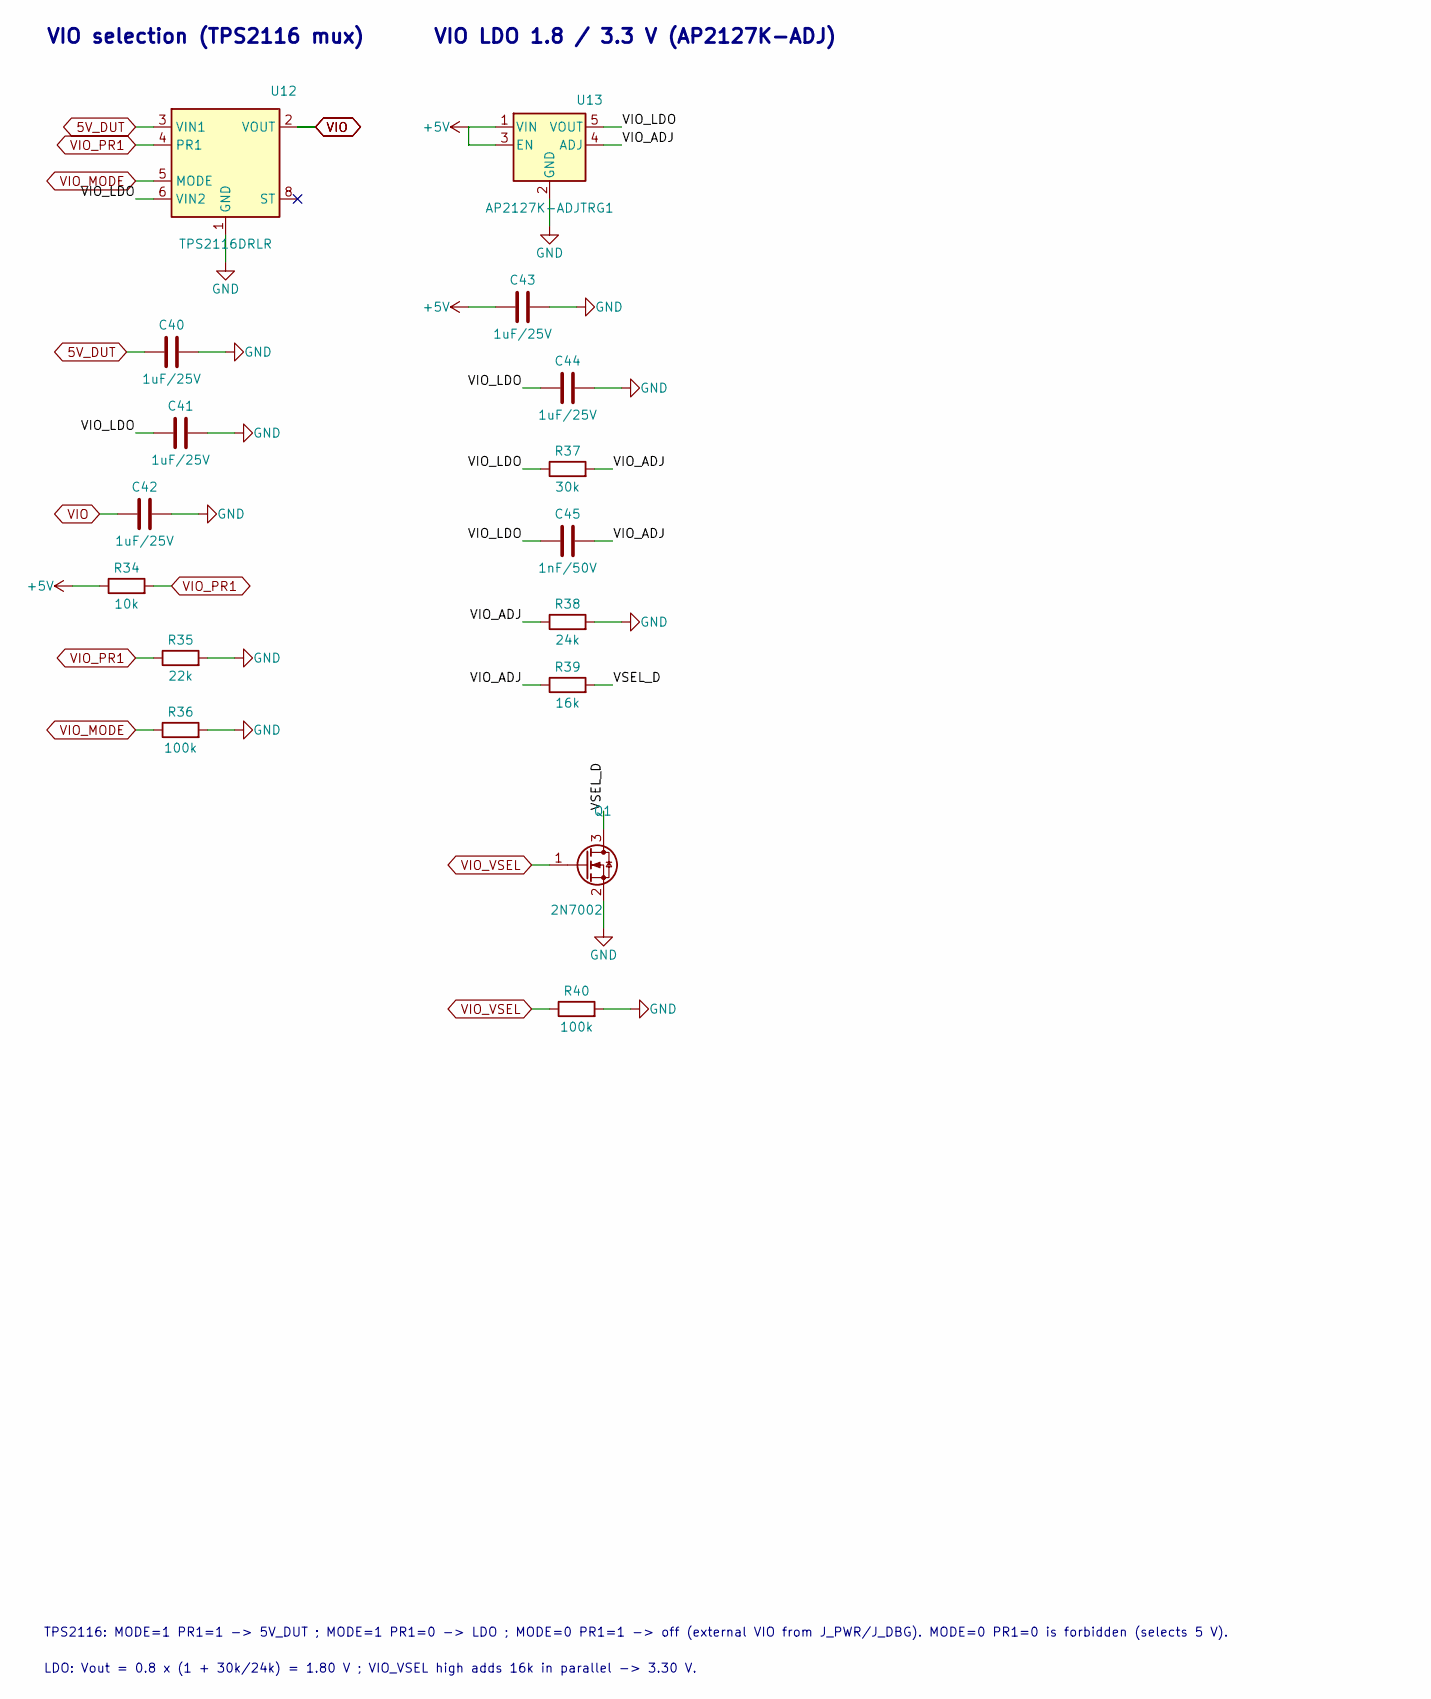
[picture p35: schematic vio.kicad_sch, VIO: 1.8 / 3.3 / 5 V or external]

Parts:
C40, C41, C42, C43, C44: 1uF/25V; C_0402_1005Metric; MPN CL05A105KA5NQNC; LCSC C52923
C45: 1nF/50V; C_0402_1005Metric; MPN 0402B102K500NT; LCSC C1523
Q1: 2N7002; SOT-23; MPN 2N7002; LCSC C8545
R34: 10k; R_0402_1005Metric; MPN 0402WGF1002TCE; LCSC C25744
R35: 22k; R_0402_1005Metric; MPN 0402WGF2202TCE; LCSC C25768
R36, R40: 100k; R_0402_1005Metric; MPN 0402WGF1003TCE; LCSC C25741
R37: 30k; R_0402_1005Metric; MPN 0402WGF3002TCE; LCSC C25776
R38: 24k; R_0402_1005Metric; MPN 0402WGF2402TCE; LCSC C25769
R39: 16k; R_0402_1005Metric; MPN 0402WGF1602TCE; LCSC C25759
U12: TPS2116DRLR; SOT-583-8; MPN TPS2116DRLR; LCSC C3235557
U13: AP2127K-ADJTRG1; SOT-23-5; MPN AP2127K-ADJTRG1; LCSC C96343

Connections:
5V_DUT: C40.1, U12.3 (VIN1); also elsewhere on the board
+5V: C43.1, R34.1, U13.1 (VIN), U13.3 (EN); also elsewhere on the board
/vio/VIO_ADJ: C45.2, R37.2, R38.1, R39.1, U13.4 (ADJ)
/vio/VIO_LDO: C41.1, C44.1, C45.1, R37.1, U12.6 (VIN2), U13.5 (VOUT)
/vio/VSEL_D: Q1.3 (D), R39.2
GND: C40.2, C41.2, C42.2, C43.2, C44.2, Q1.2 (S), R35.2, R36.2, R38.2, R40.2, U12.1 (GND), U13.2 (GND); also elsewhere on the board
VIO: C42.1, U12.2 (VOUT), U12.7 (VOUT); also elsewhere on the board
VIO_MODE: R36.1, U12.5 (MODE); also elsewhere on the board
VIO_PR1: R34.2, R35.1, U12.4 (PR1); also elsewhere on the board
VIO_VSEL: Q1.1 (G), R40.1; also elsewhere on the board

Notes on the sheet:
VIO selection (TPS2116 mux)
LDO: Vout = 0.8 x (1 + 30k/24k) = 1.80 V ; VIO_VSEL high adds 16k in parallel -> 3.30 V.
VIO LDO 1.8 / 3.3 V (AP2127K-ADJ)
TPS2116: MODE=1 PR1=1 -> 5V_DUT ; MODE=1 PR1=0 -> LDO ; MODE=0 PR1=1 -> off (external VIO from J_PWR/J_DBG). MODE=0 PR1=0 is forbidden (selects 5 V).

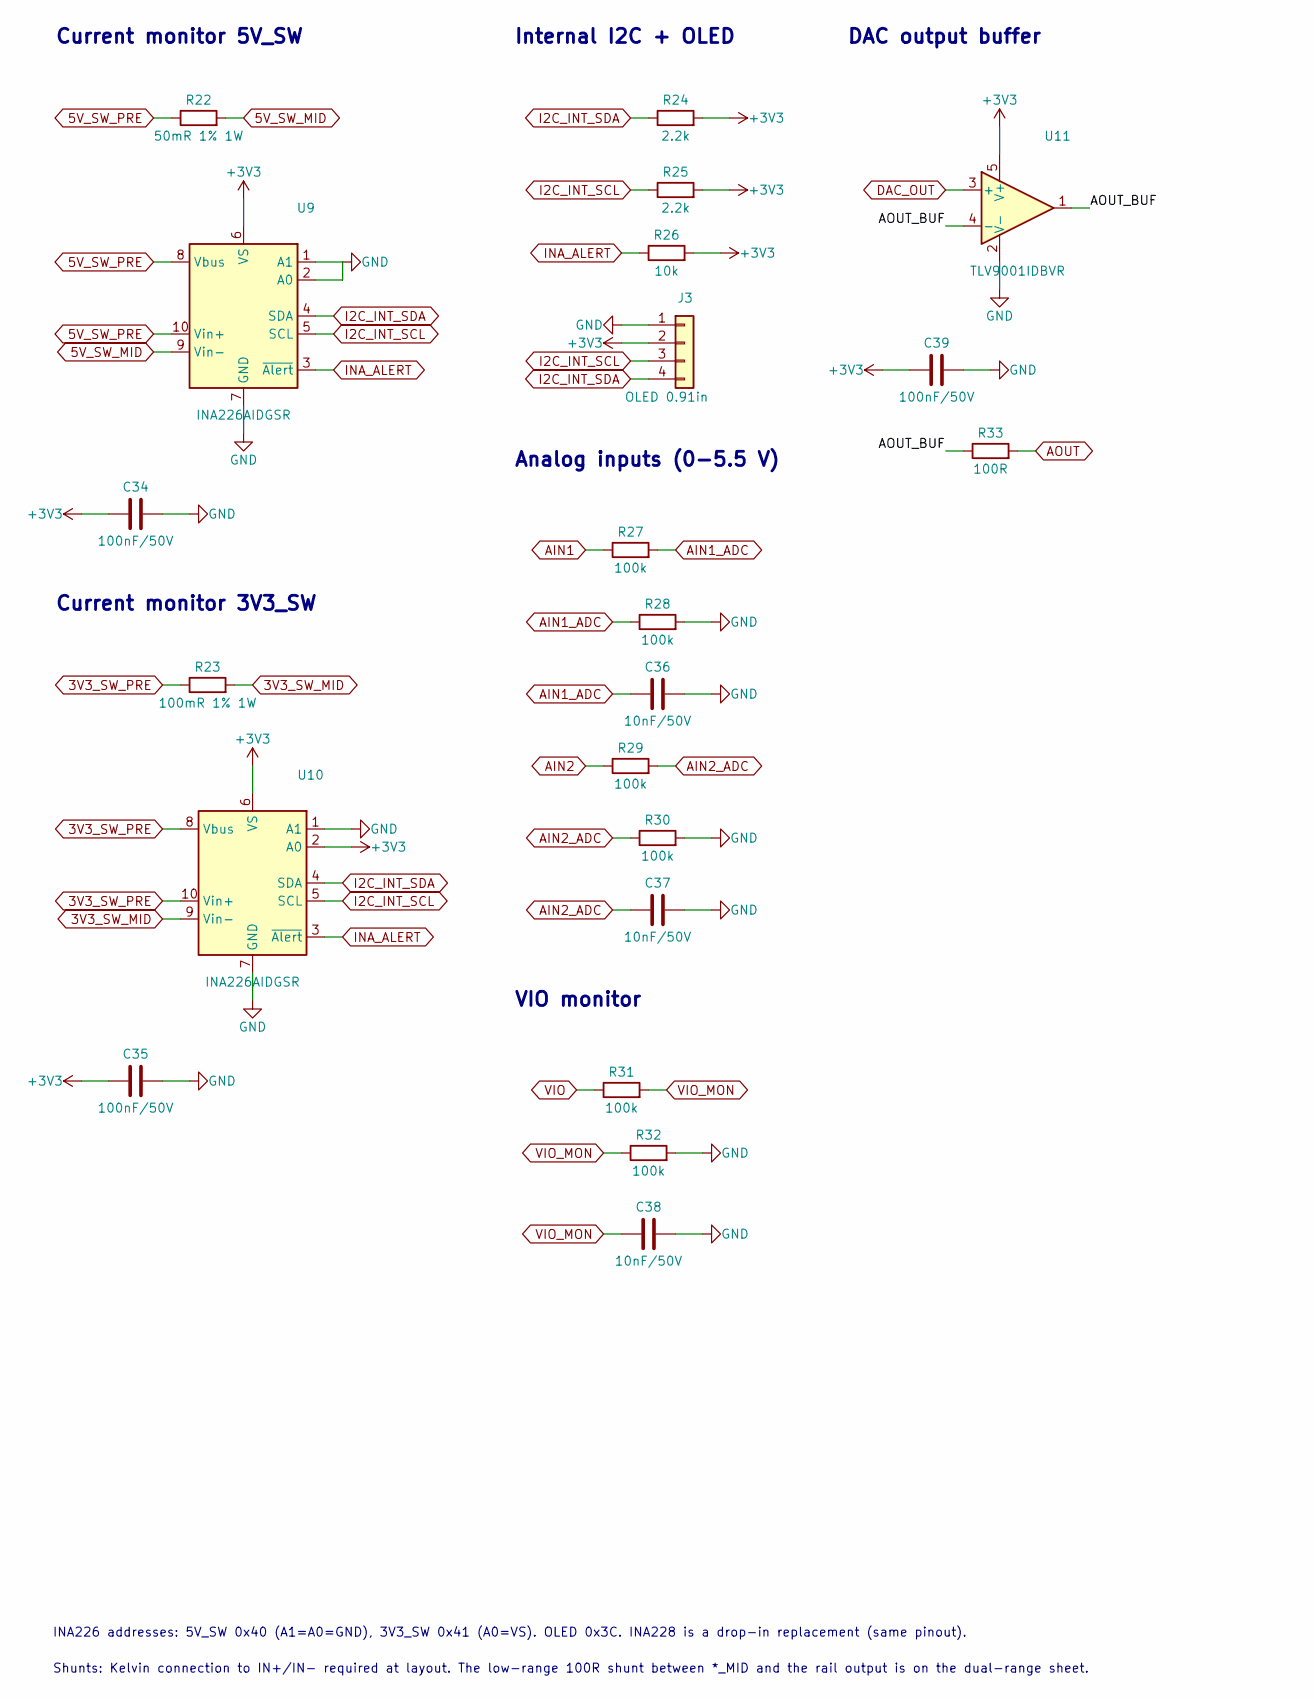
[picture p36: schematic sensing.kicad_sch, Current sensing, OLED, analog I/O]

Parts:
C34, C35, C39: 100nF/50V; C_0402_1005Metric; MPN CL05B104KB54PNC; LCSC C307331
C36, C37, C38: 10nF/50V; C_0402_1005Metric; MPN CL05B103KB5NNNC; LCSC C15195
J3: OLED 0.91in; PinSocket_1x04_P2.54mm_Vertical; MPN 2.54-1*4P; LCSC C2718488
R22: 50mR 1% 1W; R_1206_3216Metric; MPN SMF12M1FR050T; LCSC C845298
R23: 100mR 1% 1W; R_1206_3216Metric; MPN STE1206M1W0R100F; LCSC C201308
R24, R25: 2.2k; R_0402_1005Metric; MPN 0402WGF2201TCE; LCSC C25879
R26: 10k; R_0402_1005Metric; MPN 0402WGF1002TCE; LCSC C25744
R27, R28, R29, R30, R31, R32: 100k; R_0402_1005Metric; MPN 0402WGF1003TCE; LCSC C25741
R33: 100R; R_0402_1005Metric; MPN 0402WGF1000TCE; LCSC C25076
U9, U10: INA226AIDGSR; MSOP-10_3x3mm_P0.5mm; MPN INA226AIDGSR; LCSC C49851
U11: TLV9001IDBVR; SOT-23-5; MPN TLV9001IDBVR; LCSC C398363

Connections:
3V3_SW_MID: R23.2, U10.9 (Vin-); also elsewhere on the board
3V3_SW_PRE: R23.1, U10.8 (Vbus), U10.10 (Vin+); also elsewhere on the board
5V_SW_MID: R22.2, U9.9 (Vin-); also elsewhere on the board
5V_SW_PRE: R22.1, U9.8 (Vbus), U9.10 (Vin+); also elsewhere on the board
+3V3: C34.1, C35.1, C39.1, J3.2, R24.2, R25.2, R26.2, U9.6 (VS), U10.2 (A0), U10.6 (VS), U11.5 (V+); also elsewhere on the board
/sensing/AOUT_BUF: R33.1, U11.1, U11.4 (-)
AIN1: R27.1; also elsewhere on the board
AIN1_ADC: C36.1, R27.2, R28.1; also elsewhere on the board
AIN2: R29.1; also elsewhere on the board
AIN2_ADC: C37.1, R29.2, R30.1; also elsewhere on the board
AOUT: R33.2; also elsewhere on the board
DAC_OUT: U11.3 (+); also elsewhere on the board
GND: C34.2, C35.2, C36.2, C37.2, C38.2, C39.2, J3.1, R28.2, R30.2, R32.2, U9.1 (A1), U9.2 (A0), U9.7 (GND), U10.1 (A1), U10.7 (GND), U11.2 (V-); also elsewhere on the board
I2C_INT_SCL: J3.3, R25.1, U9.5 (SCL), U10.5 (SCL); also elsewhere on the board
I2C_INT_SDA: J3.4, R24.1, U9.4 (SDA), U10.4 (SDA); also elsewhere on the board
INA_ALERT: R26.1, U9.3 (~Alert), U10.3 (~Alert); also elsewhere on the board
VIO: R31.1; also elsewhere on the board
VIO_MON: C38.1, R31.2, R32.1; also elsewhere on the board

Notes on the sheet:
DAC output buffer
Analog inputs (0-5.5 V)
Internal I2C + OLED
INA226 addresses: 5V_SW 0x40 (A1=A0=GND), 3V3_SW 0x41 (A0=VS). OLED 0x3C. INA228 is a drop-in replacement (same pinout).
Shunts: Kelvin connection to IN+/IN- required at layout. The low-range 100R shunt between *_MID and the rail output is on the dual-range sheet.
Current monitor 5V_SW
VIO monitor
Current monitor 3V3_SW

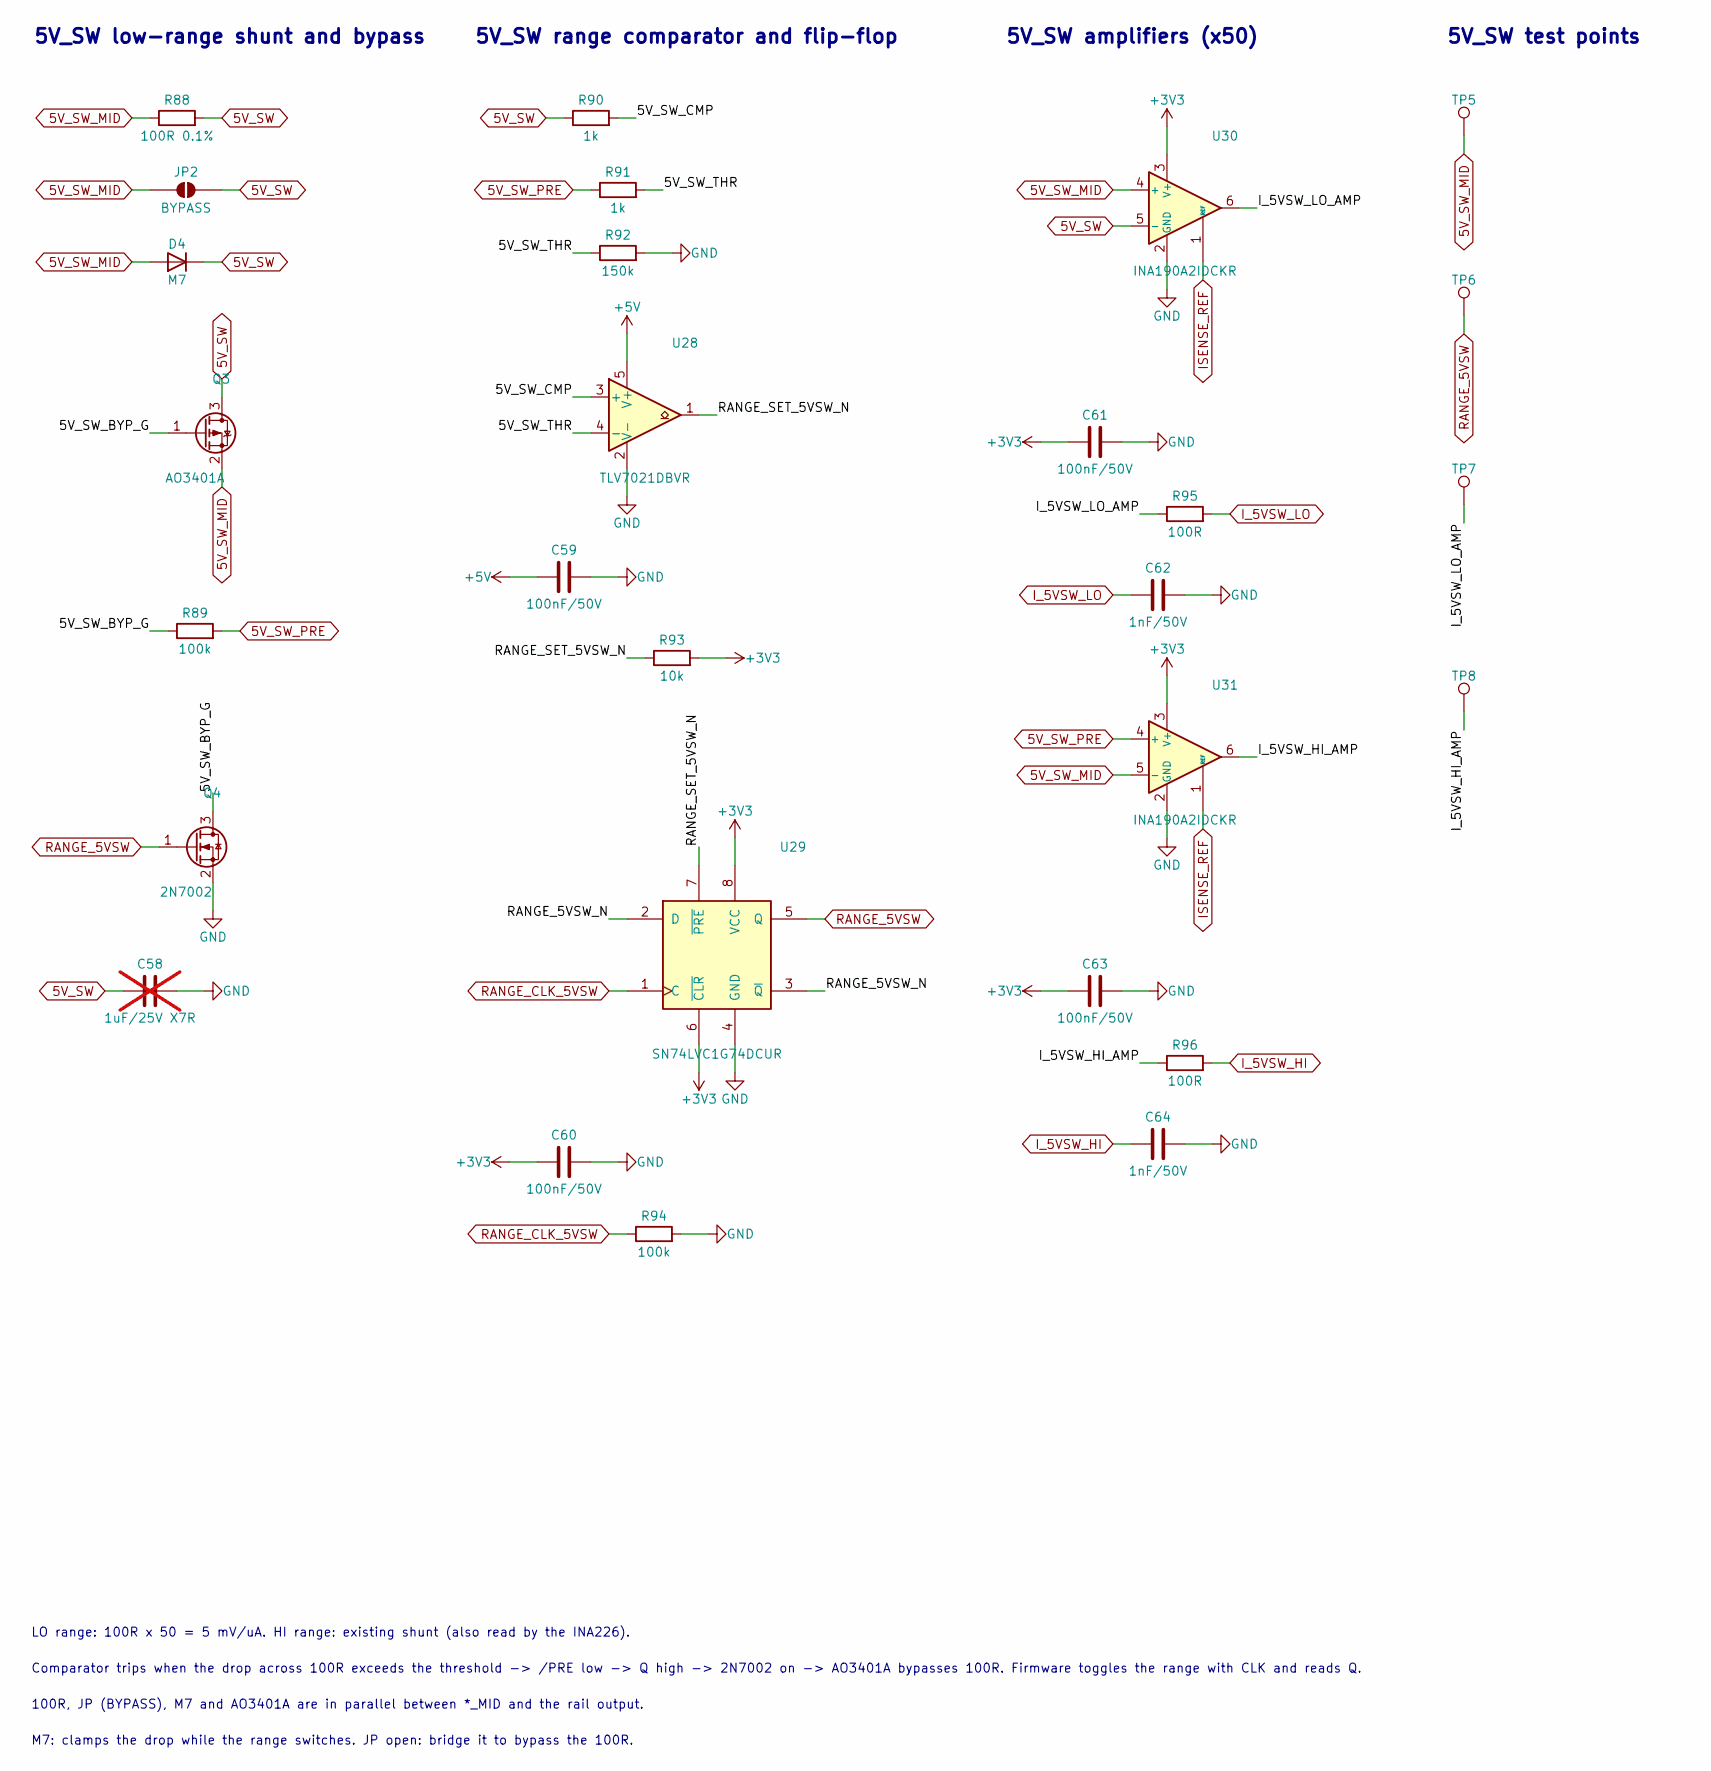
[picture p37: schematic range_5v_sw.kicad_sch, Dual-range current sensing 5V_SW]

Parts:
C58: 1uF/25V X7R; C_0603_1608Metric; MPN CL10B105KA8NNNC; LCSC_DNP C29936; not fitted
C59, C60, C61, C63: 100nF/50V; C_0402_1005Metric; MPN CL05B104KB54PNC; LCSC C307331
C62, C64: 1nF/50V; C_0402_1005Metric; MPN 0402B102K500NT; LCSC C1523
D4: M7; D_SMA; MPN M7; LCSC C95872
JP2: BYPASS; SolderJumper-2_P1.3mm_Open_RoundedPad1.0x1.5mm
Q3: AO3401A; SOT-23; MPN AO3401A; LCSC C15127
Q4: 2N7002; SOT-23; MPN 2N7002; LCSC C8545
R88: 100R 0.1%; R_0603_1608Metric; MPN RT0603BRD07100RL; LCSC C122970
R89, R94: 100k; R_0402_1005Metric; MPN 0402WGF1003TCE; LCSC C25741
R90, R91: 1k; R_0402_1005Metric; MPN 0402WGF1001TCE; LCSC C11702
R92: 150k; R_0402_1005Metric; MPN 0402WGF1503TCE; LCSC C25755
R93: 10k; R_0402_1005Metric; MPN 0402WGF1002TCE; LCSC C25744
R95, R96: 100R; R_0402_1005Metric; MPN 0402WGF1000TCE; LCSC C25076
TP5: 5V_SW_MID; TestPoint_Pad_D1.5mm
TP6: RANGE_5VSW; TestPoint_Pad_D1.5mm
TP7: I_5VSW_LO_AMP; TestPoint_Pad_D1.5mm
TP8: I_5VSW_HI_AMP; TestPoint_Pad_D1.5mm
U28: TLV7021DBVR; SOT-23-5; MPN TLV7021DBVR; LCSC C2860939
U29: SN74LVC1G74DCUR; VSSOP-8_2.3x2mm_P0.5mm; MPN SN74LVC1G74DCUR; LCSC C70285
U30, U31: INA190A2IDCKR; SOT-363_SC-70-6; MPN INA190A2IDCKR; LCSC C2870223

Connections:
5V_SW: C58.1, D4.1 (K), JP2.2 (B), Q3.3 (D), R88.2, R90.1, U30.5 (-); also elsewhere on the board
5V_SW_MID: D4.2 (A), JP2.1 (A), Q3.2 (S), R88.1, TP5.1, U30.4 (+), U31.5 (-); also elsewhere on the board
5V_SW_PRE: R89.2, R91.1, U31.4 (+); also elsewhere on the board
+3V3: C60.1, C61.1, C63.1, R93.2, U29.6 (~CLR), U29.8 (VCC), U30.3 (V+), U31.3 (V+); also elsewhere on the board
+5V: C59.1, U28.5 (V+); also elsewhere on the board
/range_5v_sw/5V_SW_BYP_G: Q3.1 (G), Q4.3 (D), R89.1
/range_5v_sw/5V_SW_CMP: R90.2, U28.3 (+)
/range_5v_sw/5V_SW_THR: R91.2, R92.1, U28.4 (-)
/range_5v_sw/I_5VSW_HI_AMP: R96.1, TP8.1, U31.6
/range_5v_sw/I_5VSW_LO_AMP: R95.1, TP7.1, U30.6
/range_5v_sw/RANGE_5VSW_N: U29.2 (D), U29.3 (~Q)
/range_5v_sw/RANGE_SET_5VSW_N: R93.1, U28.1, U29.7 (~PRE)
GND: C58.2, C59.2, C60.2, C61.2, C62.2, C63.2, C64.2, Q4.2 (S), R92.2, R94.2, U28.2 (V-), U29.4 (GND), U30.2 (GND), U31.2 (GND); also elsewhere on the board
ISENSE_REF: U30.1 (REF), U31.1 (REF); also elsewhere on the board
I_5VSW_HI: C64.1, R96.2; also elsewhere on the board
I_5VSW_LO: C62.1, R95.2; also elsewhere on the board
RANGE_5VSW: Q4.1 (G), TP6.1, U29.5 (Q); also elsewhere on the board
RANGE_CLK_5VSW: R94.1, U29.1 (C); also elsewhere on the board

Notes on the sheet:
Comparator trips when the drop across 100R exceeds the threshold -> /PRE low -> Q high -> 2N7002 on -> AO3401A bypasses 100R. Firmware toggles the range with CLK and reads Q.
5V_SW low-range shunt and bypass
LO range: 100R x 50 = 5 mV/uA. HI range: existing shunt (also read by the INA226).
5V_SW amplifiers (x50)
5V_SW range comparator and flip-flop
M7: clamps the drop while the range switches. JP open: bridge it to bypass the 100R.
100R, JP (BYPASS), M7 and AO3401A are in parallel between *_MID and the rail output.
5V_SW test points

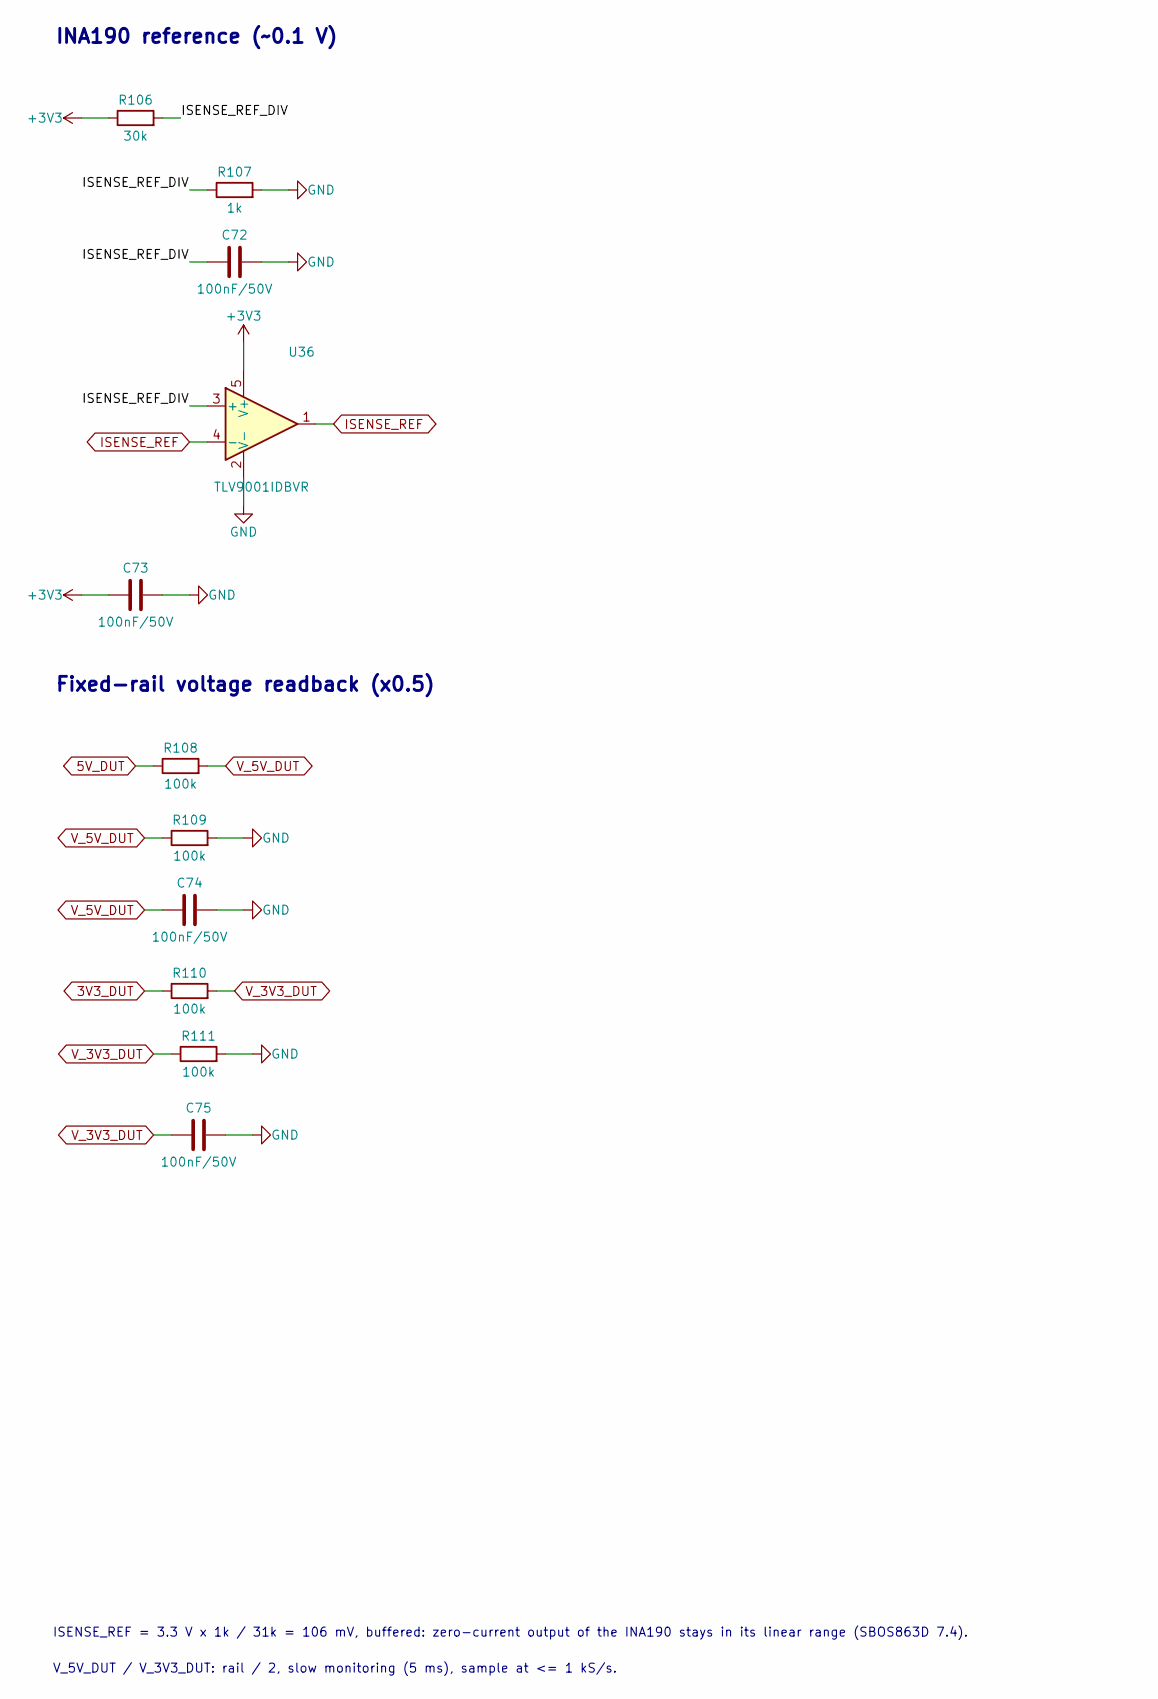
[picture p38: schematic readback.kicad_sch, INA190 reference, fixed-rail voltage readback]

Parts:
C72, C73, C74, C75: 100nF/50V; C_0402_1005Metric; MPN CL05B104KB54PNC; LCSC C307331
R106: 30k; R_0402_1005Metric; MPN 0402WGF3002TCE; LCSC C25776
R107: 1k; R_0402_1005Metric; MPN 0402WGF1001TCE; LCSC C11702
R108, R109, R110, R111: 100k; R_0402_1005Metric; MPN 0402WGF1003TCE; LCSC C25741
U36: TLV9001IDBVR; SOT-23-5; MPN TLV9001IDBVR; LCSC C398363

Connections:
3V3_DUT: R110.1; also elsewhere on the board
5V_DUT: R108.1; also elsewhere on the board
+3V3: C73.1, R106.1, U36.5 (V+); also elsewhere on the board
/readback/ISENSE_REF_DIV: C72.1, R106.2, R107.1, U36.3 (+)
GND: C72.2, C73.2, C74.2, C75.2, R107.2, R109.2, R111.2, U36.2 (V-); also elsewhere on the board
ISENSE_REF: U36.1, U36.4 (-); also elsewhere on the board
V_3V3_DUT: C75.1, R110.2, R111.1; also elsewhere on the board
V_5V_DUT: C74.1, R108.2, R109.1; also elsewhere on the board

Notes on the sheet:
Fixed-rail voltage readback (x0.5)
V_5V_DUT / V_3V3_DUT: rail / 2, slow monitoring (5 ms), sample at <= 1 kS/s.
ISENSE_REF = 3.3 V x 1k / 31k = 106 mV, buffered: zero-current output of the INA190 stays in its linear range (SBOS863D 7.4).
INA190 reference (~0.1 V)

Board: 4 copper layers, 264 parts (16 on the bottom side), 150 nets, no tracks yet.
