AlksGit/OOTY-/(commit log)

2026-10-19 feat: create empty KiCad 10 project, library tables and output tree
    [OOTY.kicad_pcb, OOTY.kicad_sch]
2026-10-19 docs: record Phase 0 decisions (layers, fab house, rules, regulator, current sensing)
2026-10-19 chore: record validated Phase 0 scope and I2C display in backlog
2026-10-19 docs: finalize Phase 0 spec after checkpoint (fixed-rail limiting, I2C OLED display)
2026-10-19 docs: size 3V3 buck with margin (>= 1.5 A)
2026-10-19 feat: add preliminary BOM generator and bom_draft.csv
    [bom_draft.csv]
2026-10-19 feat: apply BOM checkpoint decisions (merged UART/analog header, FAULT/ALERT pull-ups, TCA9517A)
    [bom_draft.csv]
2026-10-19 feat: add netlist-driven schematic generator (sexpr, symbol loader, layout)
2026-10-19 feat: generate hierarchical schematic (power, mcu, sensing, vio, translators, connectors)
    [OOTY.kicad_sch, connectors.kicad_sch, mcu.kicad_sch, power.kicad_sch, sensing.kicad_sch, translators.kicad_sch, vio.kicad_sch]
2026-10-19 feat: add netlist, BOM consistency and render checks for the schematic
2026-10-19 phase 2: schematic complete, ERC 0 errors, PDF and renders exported
2026-10-19 fix: apply schematic review findings (VIO 5V at power-up, push-pull BOOT, input bias, CC ESD)
    [OOTY.kicad_sch, bom_draft.csv, connectors.kicad_sch, mcu.kicad_sch, power.kicad_sch, sensing.kicad_sch, translators.kicad_sch, vio.kicad_sch]
2026-10-19 feat: deterministic schematic UUIDs to keep the schematic-PCB link stable
    [OOTY.kicad_sch, connectors.kicad_sch, mcu.kicad_sch, power.kicad_sch, sensing.kicad_sch, translators.kicad_sch, vio.kicad_sch]
2026-10-19 fix: connect INA226 Vbus upstream of the shunt (no bias current through it)
    [sensing.kicad_sch]
2026-10-19 docs: record MCU and current-sensing re-evaluation
2026-10-19 feat: PCB generator (stack-up, rules, net classes, outline, netlist import) and placer
2026-10-19 phase 3: PCB setup (85x55 mm, 4 layers, rules, connectors placed), DRC 0 errors
    [OOTY.kicad_pcb]
2026-10-19 feat: decoupling-aware auto-placement, silkscreen pin labels and review renders
2026-10-19 phase 4: placement complete, DRC 0 errors, renders exported (awaiting checkpoint)
    [OOTY.kicad_pcb]
2026-10-20 fix: apply schematic review (LQFP-80 MCU, fixed-rail EN, VIO from 5V_DUT, buttons, ESD per header)
    - STM32G431MBT6 (LQFP-80): 14 more GPIO; BOOT_DIR off PB4 (JTRST pull-up at reset)
    - Fixed DUT rails: EN on PE7/PE8 with pull-up (on by default, firmware can cut)
    - TPS2116 VIN1 from current-limited 5V_DUT instead of +5V
    - Two user push buttons (TS-1187A) on PD0/PD1, BOOT0 solder jumper
    - TVS after the PTC, buck Cin 10uF/25V 0805, 5th VDD decoupling cap
    - No floating translator inputs (U15 A8 to GND, 1M bias on U14 B side)
    - ESD channels grouped per header; datasheet field falls back to LCSC page
    - Decoupling capacitors declare the pin they decouple (validated against nets)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
    [OOTY.kicad_sch, bom_draft.csv, connectors.kicad_sch, mcu.kicad_sch, power.kicad_sch, sensing.kicad_sch, translators.kicad_sch, vio.kicad_sch]
2026-10-20 fix: assign MCU pins to the PCB floor plan, drop test points duplicated by headers
    - EN_5V/EN_3V3 on PD8/PD9 and BOOT_DIR on PD10 (pins facing the power and debug blocks)
    - BTN1/BTN2 on PE11/PE10 and LED_HB on PE12 (pins facing the top-right corner)
    - Second buck output capacitor declared next to the first one
    - DUT rail and VIO test points removed: J_PWR / J_DBG pins expose those nets
    [connectors.kicad_sch, mcu.kicad_sch, vio.kicad_sch]
2026-10-20 fix: redo PCB placement and rules after the placement review
    Rules: annular ring 0.15 mm, smallest via 0.5/0.2 mm, silkscreen text 1.0/0.15 mm,
    VIO net class limited to power nets, VBUS/+5V 1.5 mm, 7 mm copper keepout around M3 holes,
    USB-C flush with the board edge.
    Placement: MCU rotated 180 deg so USB, SWD probe and SPI/analog pins face their blocks;
    TLV62569 cell per datasheet (Cin on VIN, inductor off SW, Cout at its output, FB divider
    on the FB side); DUT rail switches, shunts and rail ESD above J_PWR; SWD/RESET/BOOT drivers
    above J_DBG; translators above J_IO; ESD channels next to their header pins; VIO mux + LDO
    under the OLED module; LEDs and buttons in the top-right corner.
    Tooli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
    [OOTY.kicad_pcb]
2026-10-20 docs: record checkpoint review, LQFP-80 MCU, new pin map, rules and placement
2026-10-20 fix: apply placement re-review (debug series resistors, USB corridor, shunt orientation, ILIM, EN_5V pull-up to 3V3)
    - R83-R87 between the J_DBG drivers and their ESD; keepout corridor for USB D+/D-
    - R22/R23 turned so current flows switch -> shunt -> header without crossing
    - ILIM resistors next to pin 5 of each AP22653
    - EN_5V pull-up to +3V3 instead of +5V (PD8 must not see 5 V while VDD is off)
    - Silkscreen: a reference must be within 2 mm of its part and closer to it than to any
    other part (10 key references still without room, to finish with the next placement pass)
    DRC with schematic parity: 0 errors. ERC: 0 errors.
    [OOTY.kicad_pcb, power.kicad_sch]
2026-10-20 chore: backlog TASK-010..012 (dual-range current sensing, fixed-rail voltage readback)
2026-10-20 docs: dual-range current sensing and fixed-rail voltage readback (TASK-010)
    Architecture, sizing, switching time, burden voltage, firmware rules, new
    parts (INA190A2, TLV7021, SN74LVC1G74, AO3401A, 1N4148W, 100R 0.1%) and the
    new MCU pin map freeing six ADC inputs.
    [bom_draft.csv]
2026-10-20 docs: apply TASK-010 design review (threshold margin, INA190 REF bias, toggle flip-flop, 1 A clamp diode)
    [bom_draft.csv]
2026-10-20 feat: dual-range current sensing and fixed-rail readback in the schematic (TASK-011)
    New sheets range_5v_sw, range_3v3_sw and readback appended at the end of the
    hierarchy (existing references unchanged). Shunts now end on *_MID, INA226
    Vin- on *_MID, MCU pins remapped per NOTES.md. ERC 0 errors, netlist and BOM
    0 mismatches.
    [OOTY.kicad_sch, mcu.kicad_sch, range_3v3_sw.kicad_sch, range_5v_sw.kicad_sch, readback.kicad_sch, sensing.kicad_sch]
2026-10-20 fix: schematic review of TASK-011 (DNP cap part number, parallel-path note, UCPD/PB4 note)
    [mcu.kicad_sch, range_3v3_sw.kicad_sch, range_5v_sw.kicad_sch]
2026-10-20 feat: place the dual-range blocks (TASK-012, in progress)
    Power chain hand-placed between the limiters and J_PWR, comparators above the
    limiter row, flip-flops and shunt amplifiers under the MCU, test points,
    bypass bridges and unfitted capacitors on the bottom side. Bottom-side parts
    handled by the placer and the silkscreen; Flip() fixed (footprint added to
    the board first). DRC 0 errors, parity 0, decoupling 59/59.
    [OOTY.kicad_pcb]
2026-10-20 feat: finish the placement and silkscreen of TASK-012
    Every key part has its reference (on top, or on B.SilkS under the part when the
    top side is full); test points, bypass bridges and unfitted parts on the bottom
    side; bottom renders and assembly drawing; NOTES updated. DRC 0 errors, parity 0,
    decoupling 59/59.
    [OOTY.kicad_pcb]
2026-10-20 docs: record the TASK-012 placement in NOTES, fix plot_placement usage
    [plot_placement.py]
2026-10-20 fix: apply the TASK-012 placement review
    Flip-flop U29 next to its comparator (short /PRE), U33 next to U32, 2N7002
    drivers under the MCU, amplifier row at a 4 mm pitch with the REF buffer next
    to it, R60 back near the J_DBG series resistors, rail ESD under the J4 label,
    ADC capacitors at PF0/PF1, test points outside the MCU body, routing room
    between the two chains. DRC 0 errors, parity 0, decoupling 59/59.
    [OOTY.kicad_pcb]
2026-10-20 fix: TASK-012 counter-review (REF divider next to U36, series resistors back near J8)
    [OOTY.kicad_pcb]
